BehrensG/ETH1CLCR1/hardware/project/ETH1CLCR1/ETH1CLCR1.kicad_pcb

## KiCad design hardware/project/ETH1CLCR1/ETH1CLCR1.kicad_pcb (2020-01-29)

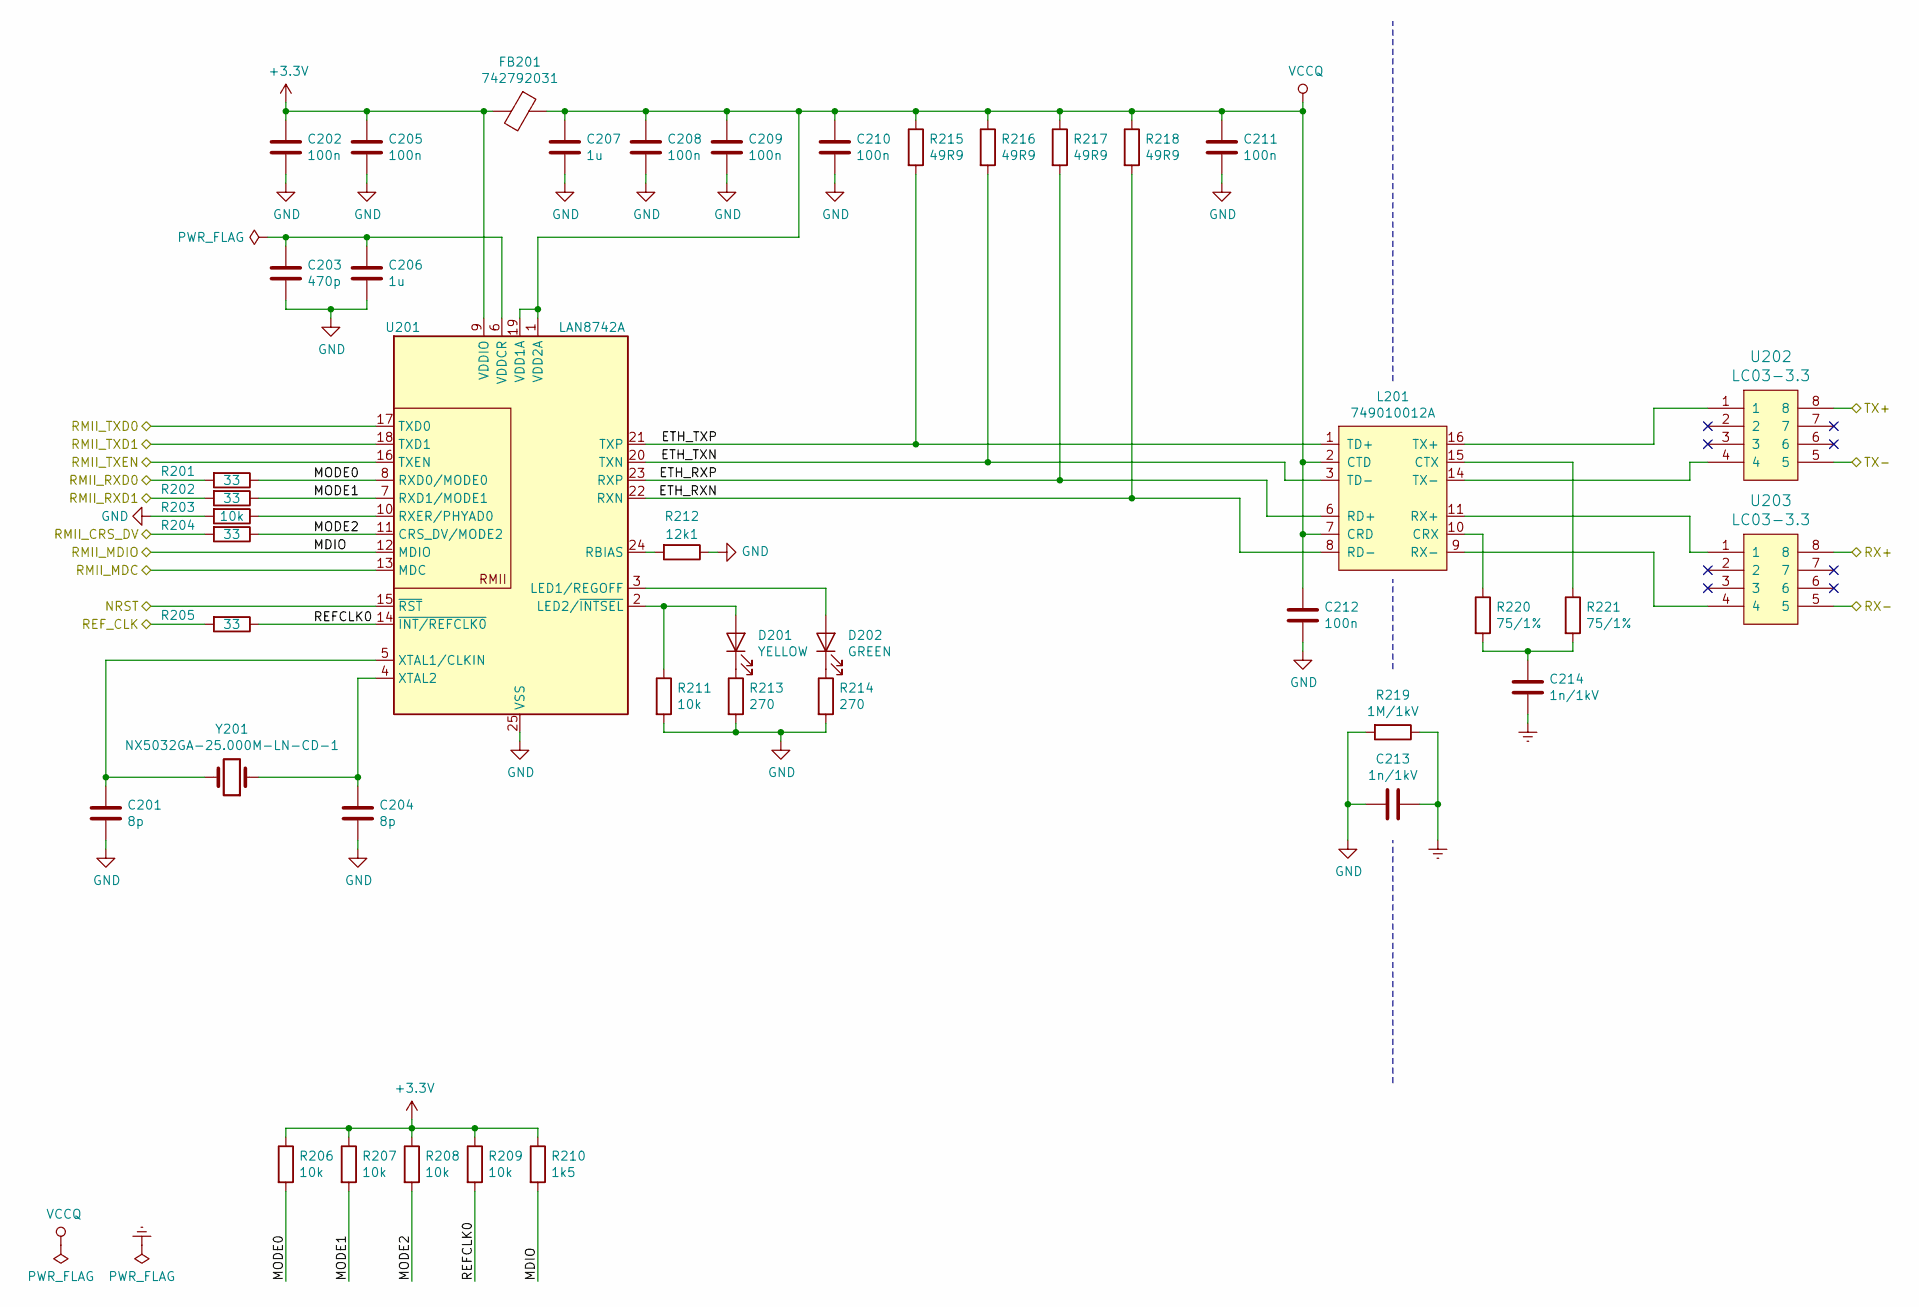
[picture p1: schematic Ethernet.sch]

Parts:
C201, C204: 8p; C_0603_1608Metric_Pad1.05x0.95mm_HandSolder
C202, C205, C208, C209, C210, C211, C212: 100n; C_0603_1608Metric_Pad1.05x0.95mm_HandSolder
C203: 470p; C_0603_1608Metric_Pad1.05x0.95mm_HandSolder
C206, C207: 1u; C_0603_1608Metric_Pad1.05x0.95mm_HandSolder
C213, C214: 1n/1kV; C_1206_3216Metric_Pad1.42x1.75mm_HandSolder
D201: YELLOW; LED_0603_1608Metric_Pad1.05x0.95mm_HandSolder
D202: GREEN; LED_0603_1608Metric_Pad1.05x0.95mm_HandSolder
FB201: 742792031; L_0805_2012Metric_Pad1.15x1.40mm_HandSolder
L201: 749010012A
R201, R202, R204, R205: 33; R_0603_1608Metric_Pad1.05x0.95mm_HandSolder
R203, R206, R207, R208, R209, R211: 10k; R_0603_1608Metric_Pad1.05x0.95mm_HandSolder
R210: 1k5; R_0603_1608Metric_Pad1.05x0.95mm_HandSolder
R212: 12k1; R_0603_1608Metric_Pad1.05x0.95mm_HandSolder
R213, R214: 270; R_0603_1608Metric_Pad1.05x0.95mm_HandSolder
R215, R216, R217, R218: 49R9; R_0603_1608Metric_Pad1.05x0.95mm_HandSolder
R219: 1M/1kV; R_1206_3216Metric_Pad1.42x1.75mm_HandSolder
R220, R221: 75/1%; R_0603_1608Metric_Pad1.05x0.95mm_HandSolder
U201: LAN8742A; QFN-24-1EP_4x4mm_P0.5mm_EP2.6x2.6mm_ThermalVias
U202, U203: LC03-3.3; SO8E
Y201: NX5032GA-25.000M-LN-CD-1; NX5032GA

Connections:
+3V3: C202.1, C205.1, FB201.2, R206.1, R207.1, R208.1, R209.1, R210.1, U201.9 (VDDIO); also elsewhere on the board
/Connector/RX+: U203.8; also elsewhere on the board
/Connector/RX-: U203.5; also elsewhere on the board
/Connector/TX+: U202.8; also elsewhere on the board
/Connector/TX-: U202.5; also elsewhere on the board
/Ethernet/ETH_RXN: L201.8 (RD-), R218.2, U201.22 (RXN)
/Ethernet/ETH_RXP: L201.6 (RD+), R217.2, U201.23 (RXP)
/Ethernet/ETH_TXN: L201.3 (TD-), R216.2, U201.20 (TXN)
/Ethernet/ETH_TXP: L201.1 (TD+), R215.2, U201.21 (TXP)
/Ethernet/MODE0: R201.1, R206.2, U201.8 (RXD0/MODE0)
/Ethernet/MODE1: R202.1, R207.2, U201.7 (RXD1/MODE1)
/Ethernet/MODE2: R204.1, R208.2, U201.11 (CRS_DV/MODE2)
/Ethernet/NRST: U201.15 (~RST); also elsewhere on the board
/Ethernet/REFCLK0: R205.1, R209.2, U201.14 (~INT/REFCLK0)
/Ethernet/REF_CLK: R205.2; also elsewhere on the board
/Ethernet/RMII_CRS_DV: R204.2; also elsewhere on the board
/Ethernet/RMII_MDC: U201.13 (MDC); also elsewhere on the board
/Ethernet/RMII_MDIO: R210.2, U201.12 (MDIO); also elsewhere on the board
/Ethernet/RMII_RXD0: R201.2; also elsewhere on the board
/Ethernet/RMII_RXD1: R202.2; also elsewhere on the board
/Ethernet/RMII_TXD0: U201.17 (TXD0); also elsewhere on the board
/Ethernet/RMII_TXD1: U201.18 (TXD1); also elsewhere on the board
/Ethernet/RMII_TXEN: U201.16 (TXEN); also elsewhere on the board
AGNDF: C201.2, C202.2, C203.2, C204.2, C205.2, C206.2, C207.2, C208.2, C209.2, C210.2, C211.2, C212.2, C213.2, R203.2, R211.2, R212.1, R213.2, R214.2, R219.2, U201.25 (VSS); also elsewhere on the board
Earth: C213.1, C214.2, R219.1; also elsewhere on the board
unnamed: C201.1, U201.5 (XTAL1/CLKIN), Y201.2
unnamed: C203.1, C206.1, U201.6 (VDDCR)
unnamed: C204.1, U201.4 (XTAL2), Y201.1
unnamed: C214.1, R220.2, R221.2
unnamed: D201.1 (K), R213.1
unnamed: D201.2 (A), R211.1, U201.2 (LED2/~INTSEL)
unnamed: D202.1 (K), R214.1
unnamed: D202.2 (A), U201.3 (LED1/REGOFF)
unnamed: L201.9 (RX-), U203.4
unnamed: L201.10 (CRX), R220.1
unnamed: L201.11 (RX+), U203.1
unnamed: L201.14 (TX-), U202.4
unnamed: L201.15 (CTX), R221.1
unnamed: L201.16 (TX+), U202.1
unnamed: R203.1, U201.10 (RXER/PHYAD0)
unnamed: R212.2, U201.24 (RBIAS)
VCCQ: C207.1, C208.1, C209.1, C210.1, C211.1, C212.1, FB201.1, L201.2 (CTD), L201.7 (CRD), R215.1, R216.1, R217.1, R218.1, U201.1 (VDD2A), U201.19 (VDD1A)

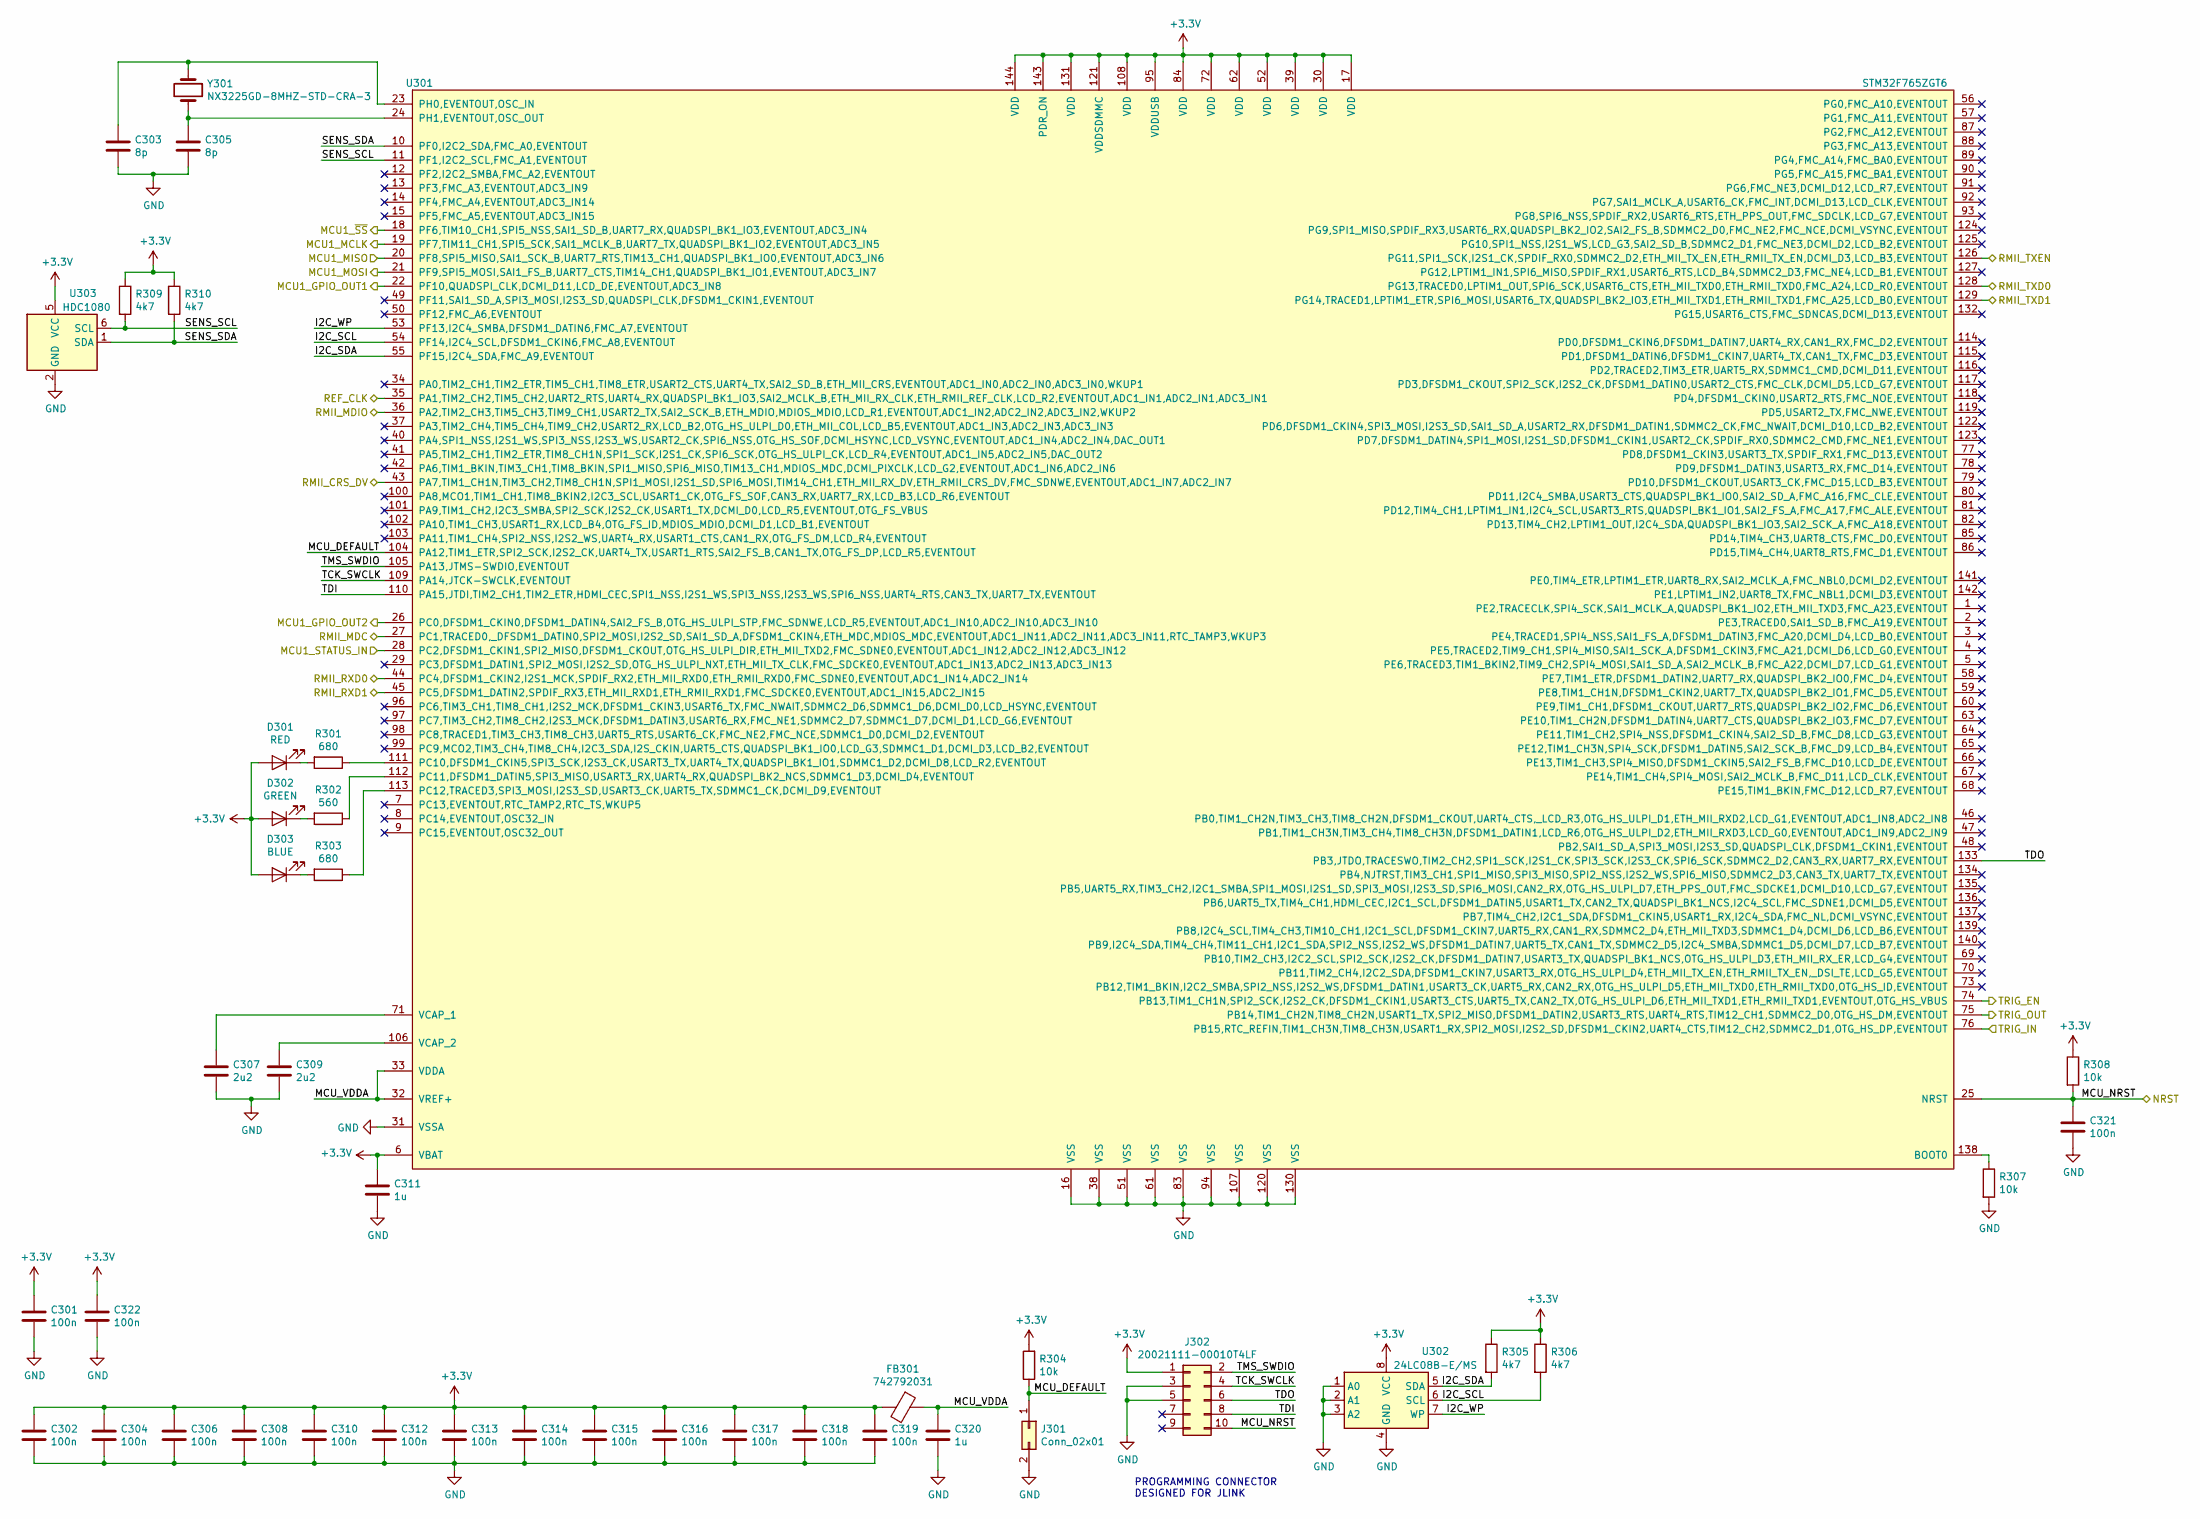
[picture p2: schematic MCU1.sch]

Parts:
C301, C302, C304, C306, C308, C310, C312, C313, C314, C315, C316, C317, C318, C319, C321, C322: 100n; C_0603_1608Metric_Pad1.05x0.95mm_HandSolder
C303, C305: 8p; C_0603_1608Metric_Pad1.05x0.95mm_HandSolder
C307, C309: 2u2; C_0805_2012Metric_Pad1.15x1.40mm_HandSolder
C311, C320: 1u; C_0603_1608Metric_Pad1.05x0.95mm_HandSolder
D301: RED; LED_0603_1608Metric_Pad1.05x0.95mm_HandSolder
D302: GREEN; LED_0603_1608Metric_Pad1.05x0.95mm_HandSolder
D303: BLUE; LED_0603_1608Metric_Pad1.05x0.95mm_HandSolder
FB301: 742792031; L_0805_2012Metric_Pad1.15x1.40mm_HandSolder
J301: Conn_02x01; PinHeader_1x02_P2.54mm_Vertical
J302: 20021111-00010T4LF; PinHeader_2x05_P1.27mm_Vertical
R301, R303: 680; R_0603_1608Metric_Pad1.05x0.95mm_HandSolder
R302: 560; R_0603_1608Metric_Pad1.05x0.95mm_HandSolder
R304, R307, R308: 10k; R_0603_1608Metric_Pad1.05x0.95mm_HandSolder
R305, R306, R309, R310: 4k7; R_0603_1608Metric_Pad1.05x0.95mm_HandSolder
U301: STM32F765ZGT6; TQFP-144_20x20mm_P0.5mm
U302: 24LC08B-E/MS; MSOP-8_3x3mm_P0.65mm
U303: HDC1080; Texas_PWSON-N6
Y301: NX3225GD-8MHZ-STD-CRA-3; NX3225GD

Connections:
+3V3: C301.1, C302.1, C304.1, C306.1, C308.1, C310.1, C311.1, C312.1, C313.1, C314.1, C315.1, C316.1, C317.1, C318.1, C319.1, C322.1, D301.2 (A), D302.2 (A), D303.2 (A), FB301.2, J302.1, R304.2, R305.1, R306.1, R308.1, R309.1, R310.1, U301.6 (VBAT), U301.17 (VDD), U301.30 (VDD), U301.39 (VDD), U301.52 (VDD), U301.62 (VDD), U301.72 (VDD), U301.84 (VDD), U301.95 (VDDUSB), U301.108 (VDD), U301.121 (VDDSDMMC), U301.131 (VDD), U301.143 (PDR_ON), U301.144 (VDD), U302.8 (VCC), U303.5 (VCC); also elsewhere on the board
/Ethernet/NRST: C321.1, J302.10, R308.2, U301.25 (NRST); also elsewhere on the board
/Ethernet/REF_CLK: U301.35 (PA1,TIM2_CH2,TIM5_CH2,UART2_RTS,UART4_R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); also elsewhere on the board
/Ethernet/RMII_CRS_DV: U301.43 (PA7,TIM1_CH1N,TIM3_CH2,TIM8_CH1N,SPI1_M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); also elsewhere on the board
/Ethernet/RMII_MDC: U301.27 (PC1,TRACED0,_DFSDM1_DATIN0,SPI2_MOSI,I2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); also elsewhere on the board
/Ethernet/RMII_MDIO: U301.36 (PA2,TIM2_CH3,TIM5_CH3,TIM9_CH1,USART2_T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); also elsewhere on the board
/Ethernet/RMII_RXD0: U301.44 (PC4,DFSDM1_CKIN2,I2S1_MCK,SPDIF_RX2,ETH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); also elsewhere on the board
/Ethernet/RMII_RXD1: U301.45 (PC5,DFSDM1_DATIN2,SPDIF_RX3,ETH_MII_RXD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); also elsewhere on the board
/Ethernet/RMII_TXD0: U301.128 (PG13,TRACED0,LPTIM1_OUT,SPI6_SCK,USART6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); also elsewhere on the board
/Ethernet/RMII_TXD1: U301.129 (PG14,TRACED1,LPTIM1_ETR,SPI6_MOSI,USART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); also elsewhere on the board
/Ethernet/RMII_TXEN: U301.126 (PG11,SPI1_SCK,I2S1_CK,SPDIF_RX0,SDMMC2_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); also elsewhere on the board
/MCU1/I2C_SCL: R306.2, U301.54 (PF14,I2C4_SCL,DFSDM1_CKIN6,FMC_A8,EVENT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), U302.6 (SCL)
/MCU1/I2C_SDA: R305.2, U301.55 (PF15,I2C4_SDA,FMC_A9,EVENTOUT), U302.5 (SDA)
/MCU1/I2C_WP: U301.53 (PF13,I2C4_SMBA,DFSDM1_DATIN6,FMC_A7,EVE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), U302.7 (WP)
/MCU1/MCU1_GPIO_OUT1: U301.22 (PF10,QUADSPI_CLK,DCMI_D11,LCD_DE,EVENTO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); also elsewhere on the board
/MCU1/MCU1_GPIO_OUT2: U301.26 (PC0,DFSDM1_CKIN0,DFSDM1_DATIN4,SAI2_FS_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); also elsewhere on the board
/MCU1/MCU1_MCLK: U301.19 (PF7,TIM11_CH1,SPI5_SCK,SAI1_MCLK_B,UART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); also elsewhere on the board
/MCU1/MCU1_MISO: U301.20 (PF8,SPI5_MISO,SAI1_SCK_B,UART7_RTS,TIM1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); also elsewhere on the board
/MCU1/MCU1_MOSI: U301.21 (PF9,SPI5_MOSI,SAI1_FS_B,UART7_CTS,TIM14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); also elsewhere on the board
/MCU1/MCU1_STATUS_IN: U301.28 (PC2,DFSDM1_CKIN1,SPI2_MISO,DFSDM1_CKOUT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); also elsewhere on the board
/MCU1/MCU1_~SS: U301.18 (PF6,TIM10_CH1,SPI5_NSS,SAI1_SD_B,UART7_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); also elsewhere on the board
/MCU1/MCU_DEFAULT: J301.1, R304.1, U301.104 (PA12,TIM1_ETR,SPI2_SCK,I2S2_CK,UART4_TX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)
/MCU1/MCU_VDDA: C320.1, FB301.1, U301.32 (VREF+), U301.33 (VDDA)
/MCU1/SENS_SCL: R309.2, U301.11 (PF1,I2C2_SCL,FMC_A1,EVENTOUT), U303.6 (SCL)
/MCU1/SENS_SDA: R310.2, U301.10 (PF0,I2C2_SDA,FMC_A0,EVENTOUT), U303.1 (SDA)
/MCU1/TCK_SWCLK: J302.4, U301.109 (PA14,JTCK-SWCLK,EVENTOUT)
/MCU1/TDI: J302.8, U301.110 (PA15,JTDI,TIM2_CH1,TIM2_ETR,HDMI_CEC,SP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)
/MCU1/TDO: J302.6, U301.133 (PB3,JTDO,TRACESWO,TIM2_CH2,SPI1_SCK,I2S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)
/MCU1/TMS_SWDIO: J302.2, U301.105 (PA13,JTMS-SWDIO,EVENTOUT)
/MCU1/TRIG_EN: U301.74 (PB13,TIM1_CH1N,SPI2_SCK,I2S2_CK,DFSDM1_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); also elsewhere on the board
/MCU1/TRIG_IN: U301.76 (PB15,RTC_REFIN,TIM1_CH3N,TIM8_CH3N,USAR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); also elsewhere on the board
/MCU1/TRIG_OUT: U301.75 (PB14,TIM1_CH2N,TIM8_CH2N,USART1_TX,SPI2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); also elsewhere on the board
AGNDF: C301.2, C302.2, C303.2, C304.2, C305.2, C306.2, C307.2, C308.2, C309.2, C310.2, C311.2, C312.2, C313.2, C314.2, C315.2, C316.2, C317.2, C318.2, C319.2, C320.2, C321.2, C322.2, J301.2, J302.3, J302.5, R307.2, U301.16 (VSS), U301.31 (VSSA), U301.38 (VSS), U301.51 (VSS), U301.61 (VSS), U301.83 (VSS), U301.94 (VSS), U301.107 (VSS), U301.120 (VSS), U301.130 (VSS), U302.1 (A0), U302.2 (A1), U302.3 (A2), U302.4 (GND), U303.2 (GND); also elsewhere on the board
unnamed: C303.1, U301.23 (PH0,EVENTOUT,OSC_IN), Y301.1
unnamed: C305.1, U301.24 (PH1,EVENTOUT,OSC_OUT), Y301.2
unnamed: C307.1, U301.71 (VCAP_1)
unnamed: C309.1, U301.106 (VCAP_2)
unnamed: D301.1 (K), R301.2
unnamed: D302.1 (K), R302.2
unnamed: D303.1 (K), R303.2
unnamed: R301.1, U301.111 (PC10,DFSDM1_CKIN5,SPI3_SCK,I2S3_CK,USAR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)
unnamed: R302.1, U301.112 (PC11,DFSDM1_DATIN5,SPI3_MISO,USART3_RX,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)
unnamed: R303.1, U301.113 (PC12,TRACED3,SPI3_MOSI,I2S3_SD,USART3_C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)
unnamed: R307.1, U301.138 (BOOT0)

Notes on the sheet:
PROGRAMMING CONNECTOR DESIGNED FOR JLINK

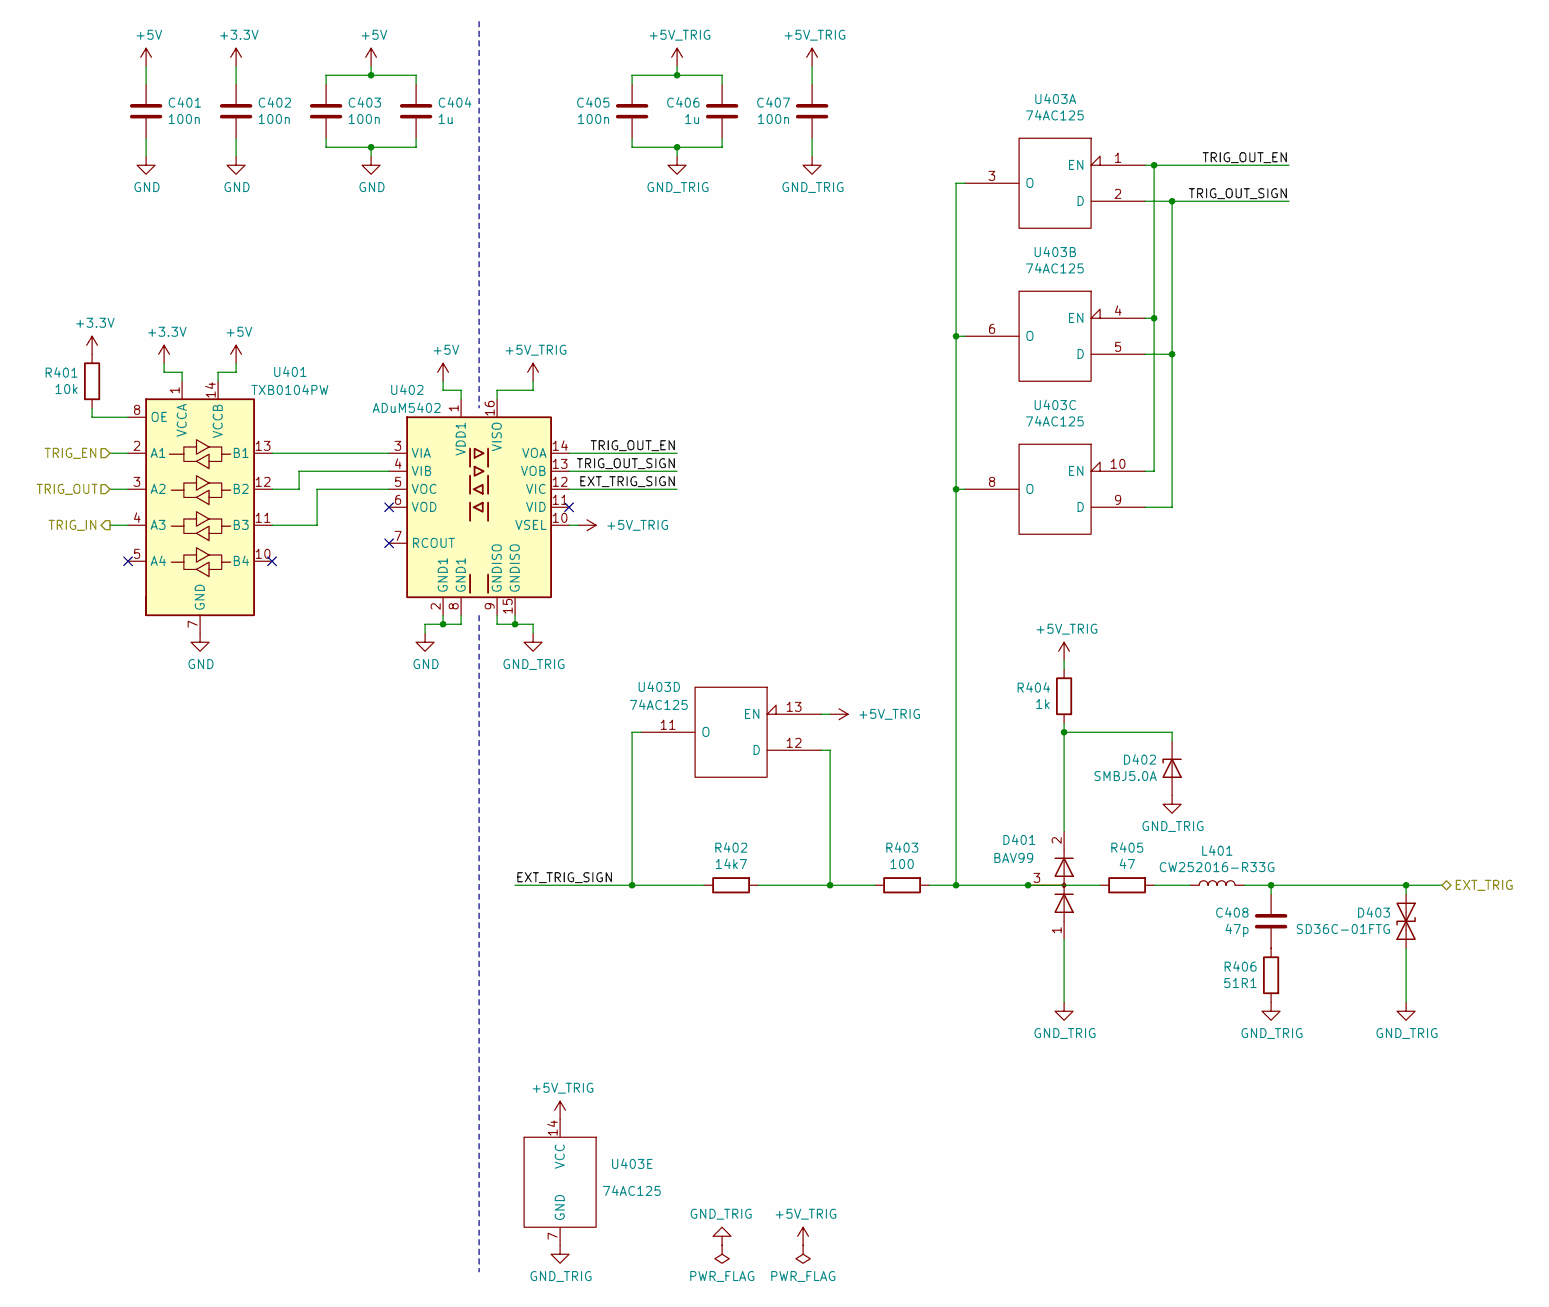
[picture p3: schematic Trigger.sch]

Parts:
C401, C402, C403, C405, C407: 100n; C_0603_1608Metric_Pad1.05x0.95mm_HandSolder
C404, C406: 1u; C_0603_1608Metric_Pad1.05x0.95mm_HandSolder
C408: 47p; C_0603_1608Metric_Pad1.05x0.95mm_HandSolder
D401: BAV99; SOT-23
D402: SMBJ5.0A; D_SMB
D403: SD36C-01FTG; D_SOD-323_HandSoldering
L401: CW252016-R33G; CW252016
R401: 10k; R_0603_1608Metric_Pad1.05x0.95mm_HandSolder
R402: 14k7; R_0603_1608Metric_Pad1.05x0.95mm_HandSolder
R403: 100; R_0603_1608Metric_Pad1.05x0.95mm_HandSolder
R404: 1k; R_0603_1608Metric_Pad1.05x0.95mm_HandSolder
R405: 47; R_0603_1608Metric_Pad1.05x0.95mm_HandSolder
R406: 51R1; R_0603_1608Metric_Pad1.05x0.95mm_HandSolder
U401: TXB0104PW; TSSOP-14_4.4x5mm_P0.65mm
U402: ADuM5402; SOIC-16W_7.5x10.3mm_P1.27mm
U403: 74AC125; TSSOP-14_4.4x5mm_P0.65mm

Connections:
+3V3: C402.1, R401.1, U401.1 (VCCA); also elsewhere on the board
+5V: C401.1, C403.1, C404.1, U401.14 (VCCB), U402.1 (VDD1); also elsewhere on the board
+5V_TRIG: C405.1, C406.1, C407.1, R404.1, U402.10 (VSEL), U402.16 (VISO), U403.13 (EN), U403.14 (VCC)
/Connector/EXT_TRIG: C408.1, D403.1 (A1), L401.1; also elsewhere on the board
/MCU1/TRIG_EN: U401.2 (A1); also elsewhere on the board
/MCU1/TRIG_IN: U401.4 (A3); also elsewhere on the board
/MCU1/TRIG_OUT: U401.3 (A2); also elsewhere on the board
/Trigger/EXT_TRIG_SIGN: R402.1, U402.12 (VIC), U403.11 (O)
/Trigger/TRIG_OUT_EN: U402.14 (VOA), U403.1 (EN), U403.4 (EN), U403.10 (EN)
/Trigger/TRIG_OUT_SIGN: U402.13 (VOB), U403.2 (D), U403.5 (D), U403.9 (D)
AGNDF: C401.2, C402.2, C403.2, C404.2, U401.7 (GND), U402.2 (GND1), U402.8 (GND1); also elsewhere on the board
GND_TRIG: C405.2, C406.2, C407.2, D401.1 (K), D402.2 (A), D403.2 (A2), R406.2, U402.9 (GNDISO), U402.15 (GNDISO), U403.7 (GND); also elsewhere on the board
unnamed: C408.2, R406.1
unnamed: D401.2 (A), D402.1 (K), R404.2
unnamed: D401.3 (K), R403.2, R405.1, U403.3 (O), U403.6 (O), U403.8 (O)
unnamed: L401.2, R405.2
unnamed: R401.2, U401.8 (OE)
unnamed: R402.2, R403.1, U403.12 (D)
unnamed: U401.11 (B3), U402.5 (VOC)
unnamed: U401.12 (B2), U402.4 (VIB)
unnamed: U401.13 (B1), U402.3 (VIA)

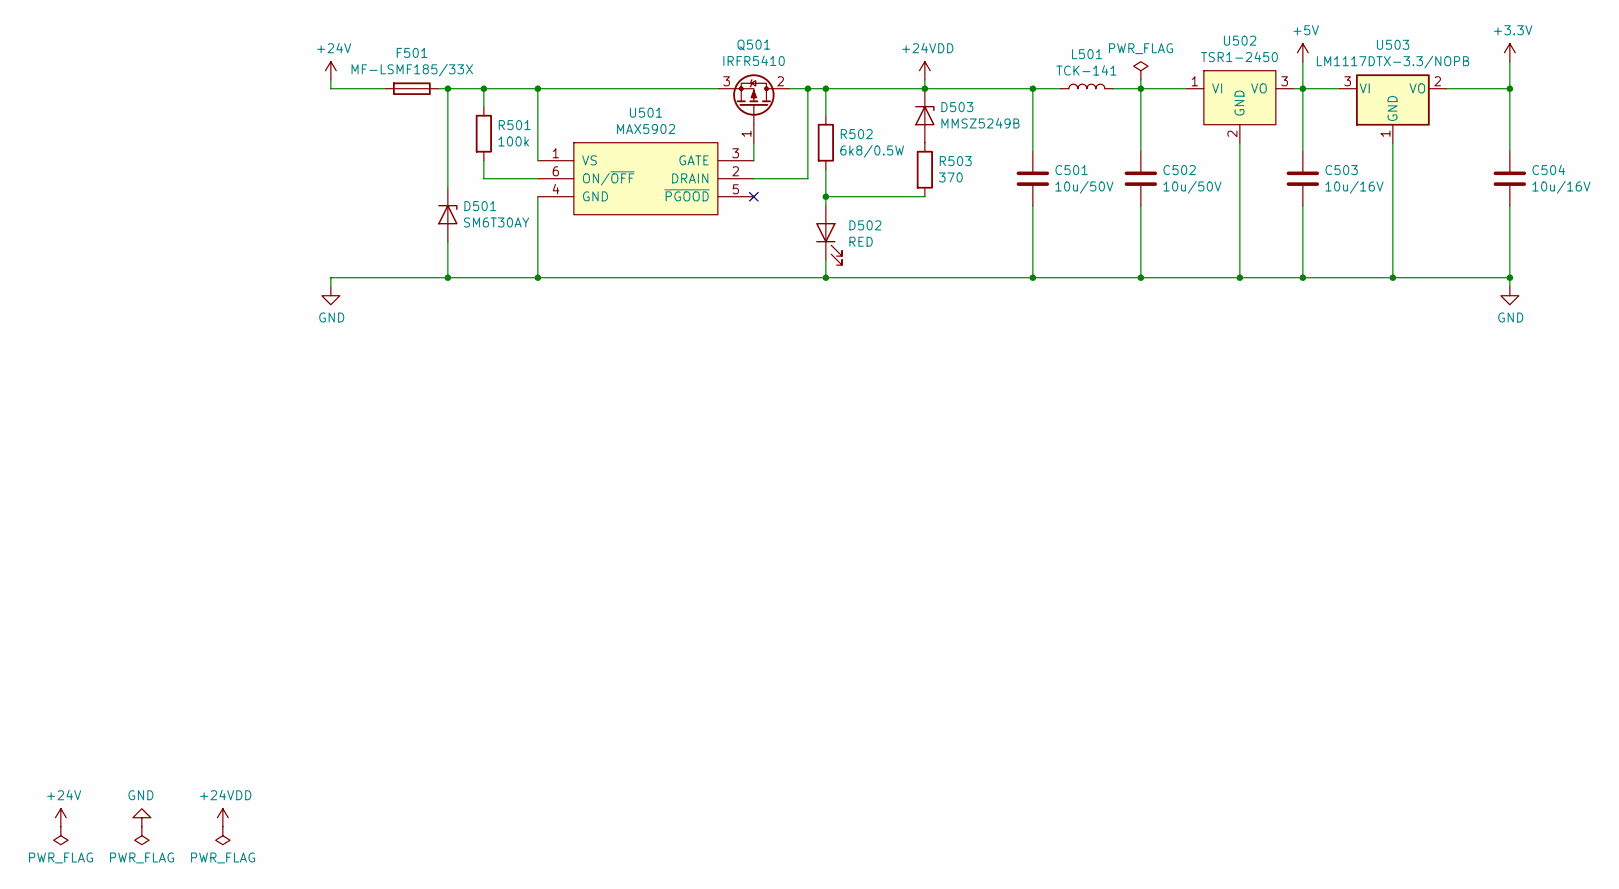
[picture p4: schematic Power_One.sch, Power supply one]

Parts:
C501, C502: 10u/50V; C_1206_3216Metric_Pad1.42x1.75mm_HandSolder
C503, C504: 10u/16V; C_1206_3216Metric_Pad1.42x1.75mm_HandSolder
D501: SM6T30AY; DO_214AA_REV
D502: RED; LED_0603_1608Metric_Pad1.05x0.95mm_HandSolder
D503: MMSZ5249B; D_SOD-123
F501: MF-LSMF185/33X; Fuse_SMD2920
L501: TCK-141
Q501: IRFR5410; TO-252-2_Rectifier
R501: 100k; R_0603_1608Metric_Pad1.05x0.95mm_HandSolder
R502: 6k8/0.5W; R_0805_2012Metric_Pad1.15x1.40mm_HandSolder
R503: 370; R_0603_1608Metric_Pad1.05x0.95mm_HandSolder
U501: MAX5902; SOT-23-6_Handsoldering
U502: TSR1-2450; TSR1
U503: LM1117DTX-3.3/NOPB; TO-252-2

Connections:
+3V3: C504.1, U503.2 (VO); also elsewhere on the board
+5V: C503.1, U502.3 (VO), U503.3 (VI); also elsewhere on the board
+24V: F501.2; also elsewhere on the board
+24VDD: C501.1, D503.1 (K), L501.1, Q501.2 (D), R502.1, U501.2 (DRAIN); also elsewhere on the board
AGNDF: C501.2, C502.2, C503.2, C504.2, D501.2 (A), D502.1 (K), U501.4 (GND), U502.2 (GND), U503.1 (GND); also elsewhere on the board
unnamed: C502.1, L501.2, U502.1 (VI)
unnamed: D501.1 (K), F501.1, Q501.3 (S), R501.1, U501.1 (VS)
unnamed: D502.2 (A), R502.2, R503.2
unnamed: D503.2 (A), R503.1
unnamed: Q501.1 (G), U501.3 (GATE)
unnamed: R501.2, U501.6 (ON/~OFF)

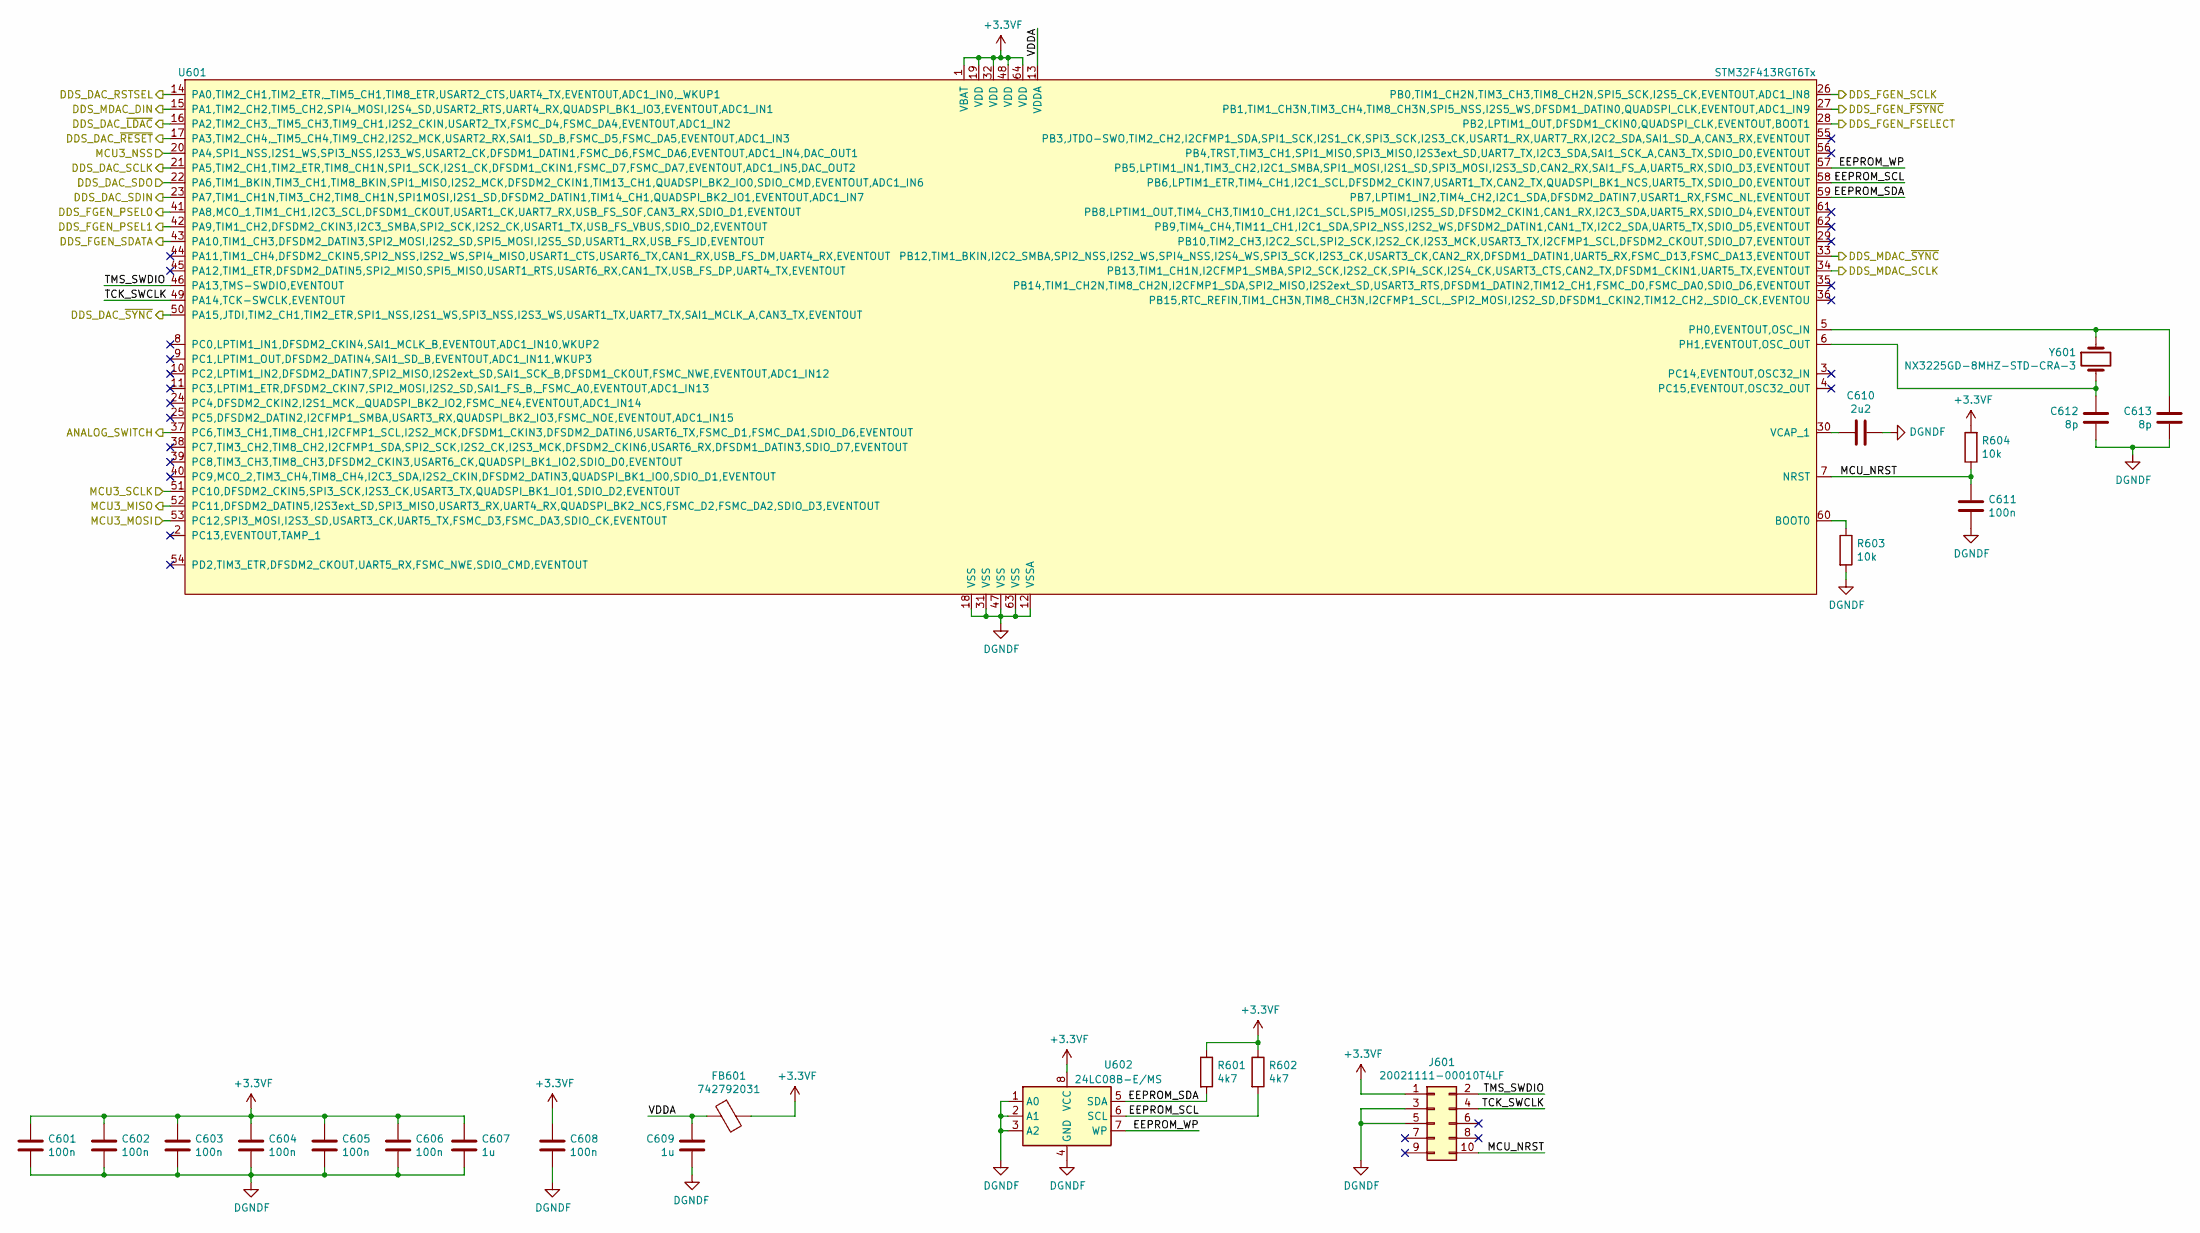
[picture p5: schematic MCU3.sch]

Parts:
C601, C602, C603, C604, C605, C606, C608, C611: 100n; C_0603_1608Metric_Pad1.05x0.95mm_HandSolder
C607, C609: 1u; C_0603_1608Metric_Pad1.05x0.95mm_HandSolder
C610: 2u2; C_0805_2012Metric_Pad1.15x1.40mm_HandSolder
C612, C613: 8p; C_0603_1608Metric_Pad1.05x0.95mm_HandSolder
FB601: 742792031; L_0805_2012Metric_Pad1.15x1.40mm_HandSolder
J601: 20021111-00010T4LF; PinHeader_2x05_P1.27mm_Vertical
R601, R602: 4k7; R_0603_1608Metric_Pad1.05x0.95mm_HandSolder
R603, R604: 10k; R_0603_1608Metric_Pad1.05x0.95mm_HandSolder
U601: STM32F413RGT6Tx; LQFP-64_10x10mm_P0.5mm
U602: 24LC08B-E/MS; MSOP-8_3x3mm_P0.65mm
Y601: NX3225GD-8MHZ-STD-CRA-3; NX3225GD

Connections:
+3.3VF: C601.1, C602.1, C603.1, C604.1, C605.1, C606.1, C607.1, C608.1, FB601.2, J601.1, R601.1, R602.1, R604.2, U601.1 (VBAT), U601.19 (VDD), U601.32 (VDD), U601.48 (VDD), U601.64 (VDD), U602.8 (VCC); also elsewhere on the board
/FGEN/ANALOG_SWITCH: U601.37 (PC6,TIM3_CH1,TIM8_CH1,I2CFMP1_SCL,I2S2_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); also elsewhere on the board
/FGEN/DDS_DAC_RSTSEL: U601.14 (PA0,TIM2_CH1,TIM2_ETR,_TIM5_CH1,TIM8_ET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); also elsewhere on the board
/FGEN/DDS_DAC_SCLK: U601.21 (PA5,TIM2_CH1,TIM2_ETR,TIM8_CH1N,SPI1_SC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); also elsewhere on the board
/FGEN/DDS_DAC_SDIN: U601.23 (PA7,TIM1_CH1N,TIM3_CH2,TIM8_CH1N,SPI1MO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); also elsewhere on the board
/FGEN/DDS_DAC_SDO: U601.22 (PA6,TIM1_BKIN,TIM3_CH1,TIM8_BKIN,SPI1_M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); also elsewhere on the board
/FGEN/DDS_DAC_~LDAC: U601.16 (PA2,TIM2_CH3,_TIM5_CH3,TIM9_CH1,I2S2_CK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); also elsewhere on the board
/FGEN/DDS_DAC_~RESET: U601.17 (PA3,TIM2_CH4,_TIM5_CH4,TIM9_CH2,I2S2_MC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); also elsewhere on the board
/FGEN/DDS_DAC_~SYNC: U601.50 (PA15,JTDI,TIM2_CH1,TIM2_ETR,SPI1_NSS,I2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); also elsewhere on the board
/FGEN/DDS_FGEN_FSELECT: U601.28 (PB2,LPTIM1_OUT,DFSDM1_CKIN0,QUADSPI_CLK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); also elsewhere on the board
/FGEN/DDS_FGEN_PSEL0: U601.41 (PA8,MCO_1,TIM1_CH1,I2C3_SCL,DFSDM1_CKOU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); also elsewhere on the board
/FGEN/DDS_FGEN_PSEL1: U601.42 (PA9,TIM1_CH2,DFSDM2_CKIN3,I2C3_SMBA,SPI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); also elsewhere on the board
/FGEN/DDS_FGEN_SCLK: U601.26 (PB0,TIM1_CH2N,TIM3_CH3,TIM8_CH2N,SPI5_S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); also elsewhere on the board
/FGEN/DDS_FGEN_SDATA: U601.43 (PA10,TIM1_CH3,DFSDM2_DATIN3,SPI2_MOSI,I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); also elsewhere on the board
/FGEN/DDS_FGEN_~FSYNC: U601.27 (PB1,TIM1_CH3N,TIM3_CH4,TIM8_CH3N,SPI5_N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); also elsewhere on the board
/FGEN/DDS_MDAC_DIN: U601.15 (PA1,TIM2_CH2,TIM5_CH2,SPI4_MOSI,I2S4_SD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); also elsewhere on the board
/FGEN/DDS_MDAC_SCLK: U601.34 (PB13,TIM1_CH1N,I2CFMP1_SMBA,SPI2_SCK,I2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); also elsewhere on the board
/FGEN/DDS_MDAC_~SYNC: U601.33 (PB12,TIM1_BKIN,I2C2_SMBA,SPI2_NSS,I2S2_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); also elsewhere on the board
/MCU2/MCU3_MISO: U601.52 (PC11,DFSDM2_DATIN5,I2S3ext_SD,SPI3_MISO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); also elsewhere on the board
/MCU2/MCU3_MOSI: U601.53 (PC12,SPI3_MOSI,I2S3_SD,USART3_CK,UART5_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); also elsewhere on the board
/MCU2/MCU3_NSS: U601.20 (PA4,SPI1_NSS,I2S1_WS,SPI3_NSS,I2S3_WS,U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); also elsewhere on the board
/MCU2/MCU3_SCLK: U601.51 (PC10,DFSDM2_CKIN5,SPI3_SCK,I2S3_CK,USAR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); also elsewhere on the board
/MCU3/EEPROM_SCL: R602.2, U601.58 (PB6,LPTIM1_ETR,TIM4_CH1,I2C1_SCL,DFSDM2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), U602.6 (SCL)
/MCU3/EEPROM_SDA: R601.2, U601.59 (PB7,LPTIM1_IN2,TIM4_CH2,I2C1_SDA,DFSDM2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), U602.5 (SDA)
/MCU3/EEPROM_WP: U601.57 (PB5,LPTIM1_IN1,TIM3_CH2,I2C1_SMBA,SPI1_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), U602.7 (WP)
/MCU3/MCU_NRST: C611.1, J601.10, R604.1, U601.7 (NRST)
/MCU3/TCK_SWCLK: J601.4, U601.49 (PA14,TCK-SWCLK,EVENTOUT)
/MCU3/TMS_SWDIO: J601.2, U601.46 (PA13,TMS-SWDIO,EVENTOUT)
/MCU3/VDDA: C609.1, FB601.1, U601.13 (VDDA)
AGNDF: C601.2, C602.2, C603.2, C604.2, C605.2, C606.2, C607.2, C608.2, C609.2, C610.1, C611.2, C612.2, C613.2, J601.3, J601.5, R603.2, U601.12 (VSSA), U601.18 (VSS), U601.31 (VSS), U601.47 (VSS), U601.63 (VSS), U602.1 (A0), U602.2 (A1), U602.3 (A2), U602.4 (GND); also elsewhere on the board
unnamed: C610.2, U601.30 (VCAP_1)
unnamed: C612.1, U601.6 (PH1,EVENTOUT,OSC_OUT), Y601.2
unnamed: C613.1, U601.5 (PH0,EVENTOUT,OSC_IN), Y601.1
unnamed: R603.1, U601.60 (BOOT0)
