BehrensG/ETH1CLCR1/hardware/project/ETH1CLCR1/ETH1CLCR1.kicad_pcb

## KiCad design hardware/project/ETH1CLCR1/ETH1CLCR1.kicad_pcb (continued)

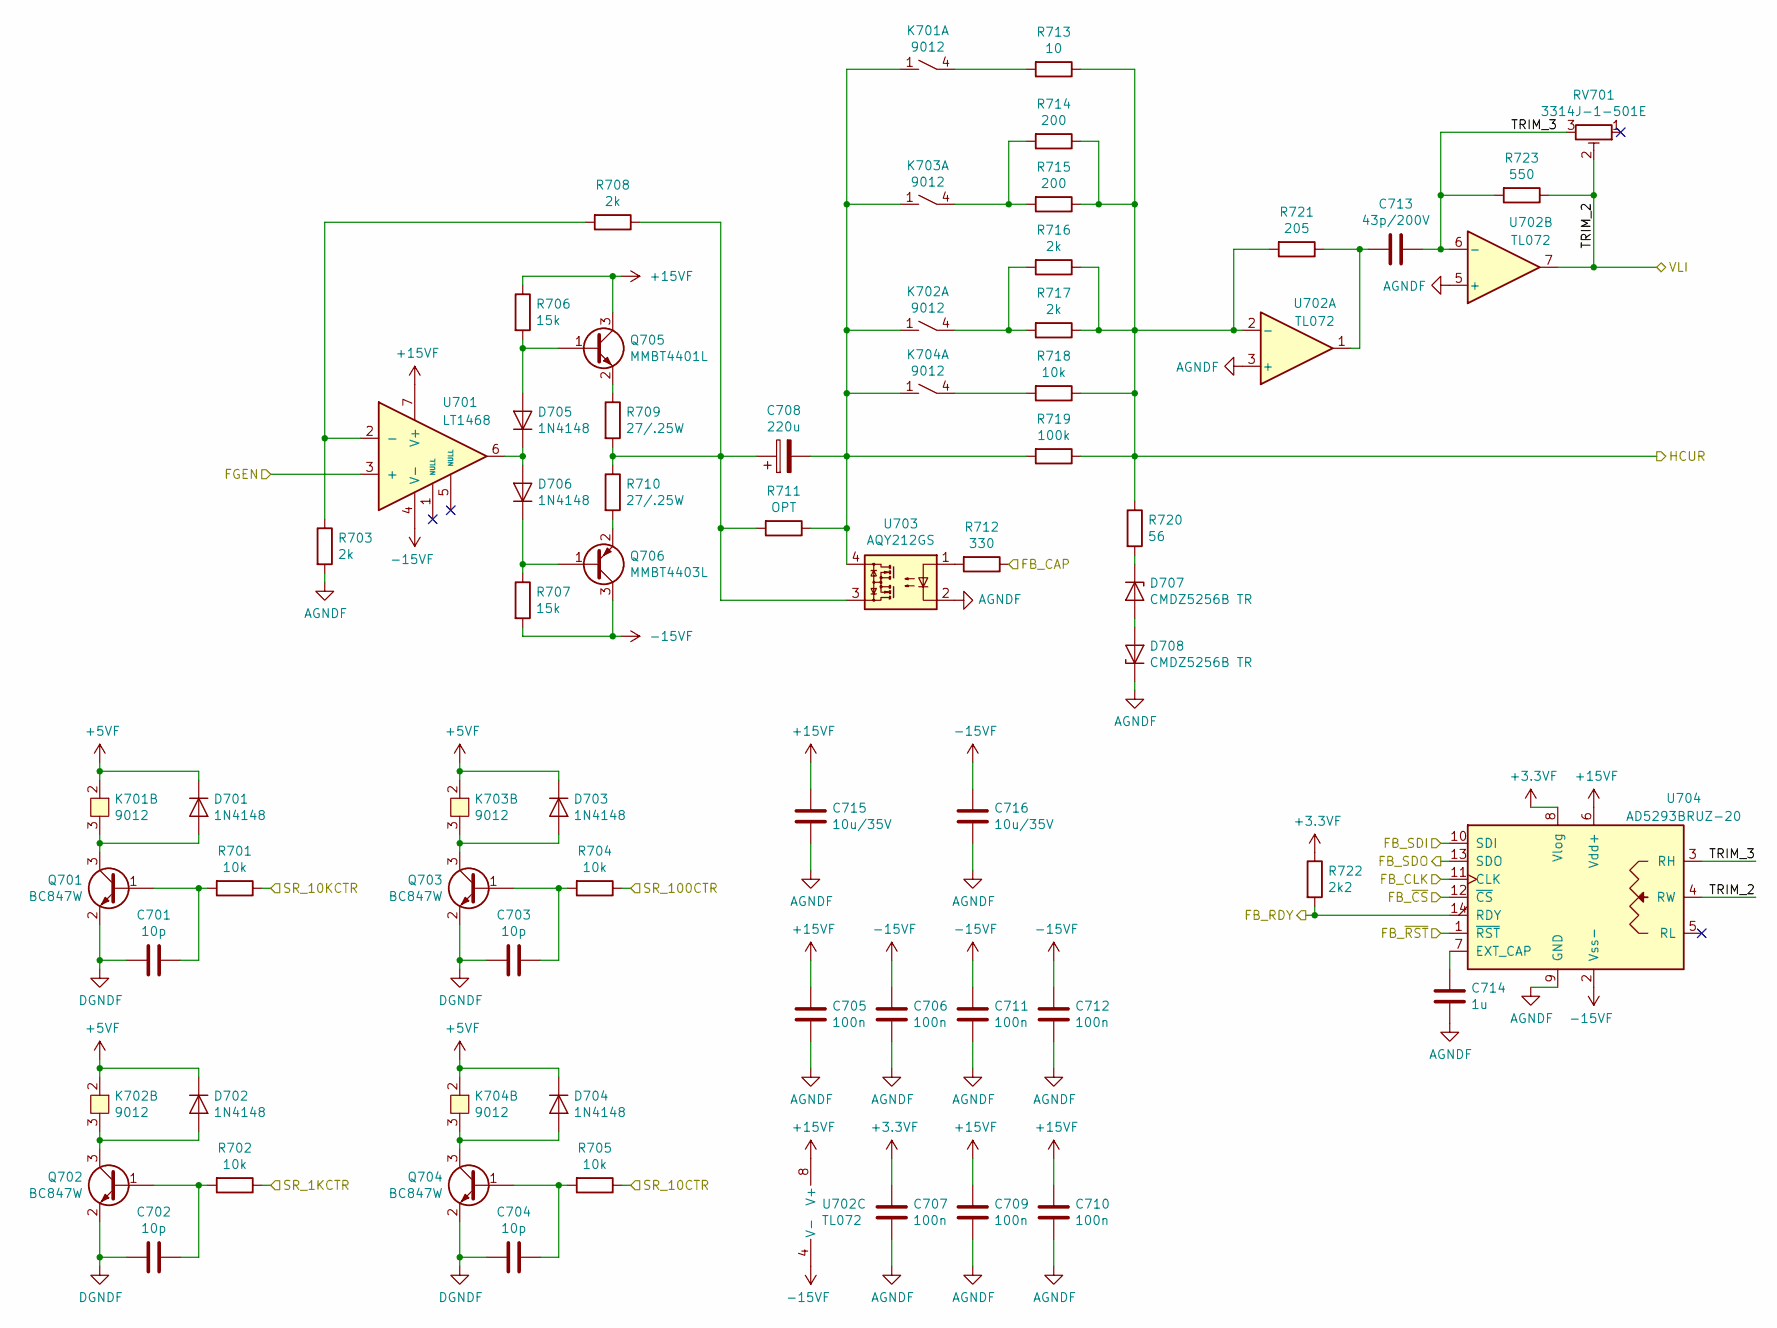
[picture p6: schematic FGEN_Buffer.sch, Function generator power ampl. and source resistor]

Parts:
C701, C702, C703, C704: 10p; C_0603_1608Metric_Pad1.05x0.95mm_HandSolder
C705, C706, C707, C709, C710, C711, C712: 100n; C_0603_1608Metric_Pad1.05x0.95mm_HandSolder
C708: 220u; CP_Elec_10x10
C713: 43p/200V; C_0603_1608Metric_Pad1.05x0.95mm_HandSolder
C714: 1u; C_0603_1608Metric_Pad1.05x0.95mm_HandSolder
C715, C716: 10u/35V; C_1206_3216Metric_Pad1.42x1.75mm_HandSolder
D701, D702, D703, D704, D705, D706: 1N4148; D_SOD-123
D707, D708: CMDZ5256B TR; D_SOD-323_HandSoldering
K701, K702, K703, K704: 9012
Q701, Q702, Q703, Q704: BC847W; SOT-323_SC-70
Q705: MMBT4401L; SOT-23
Q706: MMBT4403L; SOT-23
R701, R702, R704, R705, R718: 10k; R_0603_1608Metric_Pad1.05x0.95mm_HandSolder
R703, R708, R716, R717: 2k; R_0603_1608Metric_Pad1.05x0.95mm_HandSolder
R706, R707: 15k; R_0603_1608Metric_Pad1.05x0.95mm_HandSolder
R709, R710: 27/.25W; R_0805_2012Metric_Pad1.15x1.40mm_HandSolder
R711: OPT; R_0603_1608Metric_Pad1.05x0.95mm_HandSolder
R712: 330; R_0603_1608Metric_Pad1.05x0.95mm_HandSolder
R713: 10; R_0603_1608Metric_Pad1.05x0.95mm_HandSolder
R714, R715: 200; R_0603_1608Metric_Pad1.05x0.95mm_HandSolder
R719: 100k; R_0603_1608Metric_Pad1.05x0.95mm_HandSolder
R720: 56; R_0603_1608Metric_Pad1.05x0.95mm_HandSolder
R721: 205; R_0603_1608Metric_Pad1.05x0.95mm_HandSolder
R722: 2k2; R_0603_1608Metric_Pad1.05x0.95mm_HandSolder
R723: 550; R_0603_1608Metric_Pad1.05x0.95mm_HandSolder
RV701: 3314J-1-501E; Potentiometer_Bourns_3314J_Vertical
U701: LT1468; SSOP-8_3.9x5.05mm_P1.27mm
U702: TL072; SOIC-8_3.9x4.9mm_P1.27mm
U703: AQY212GS
U704: AD5293BRUZ-20; TSSOP-14_4.4x5mm_P0.65mm

Connections:
+3.3VF: C707.1, R722.1, U704.8 (Vlog); also elsewhere on the board
+5VF: D701.1 (K), D702.1 (K), D703.1 (K), D704.1 (K), K701.2, K702.2, K703.2, K704.2; also elsewhere on the board
+15VF: C705.1, C709.1, C710.1, C715.1, Q705.3 (C), R706.1, U701.7 (V+), U702.8 (V+), U704.6 (Vdd+); also elsewhere on the board
-15VF: C706.1, C711.1, C712.1, C716.1, Q706.3 (C), R707.2, U701.4 (V-), U702.4 (V-), U704.2 (Vss-); also elsewhere on the board
/Connector/HCUR: R713.1, R714.1, R715.1, R716.1, R717.1, R718.1, R719.1, R720.1, R721.2, U702.2 (-); also elsewhere on the board
/FGEN Buffer + Source resistor/FB_CAP: R712.1; also elsewhere on the board
/FGEN Buffer + Source resistor/FB_CLK: U704.11 (CLK); also elsewhere on the board
/FGEN Buffer + Source resistor/FB_RDY: R722.2, U704.14 (RDY); also elsewhere on the board
/FGEN Buffer + Source resistor/FB_SDI: U704.10 (SDI); also elsewhere on the board
/FGEN Buffer + Source resistor/FB_SDO: U704.13 (SDO); also elsewhere on the board
/FGEN Buffer + Source resistor/FB_~CS: U704.12 (~CS~); also elsewhere on the board
/FGEN Buffer + Source resistor/FB_~RST: U704.1 (~RST~); also elsewhere on the board
/FGEN Buffer + Source resistor/FGEN: U701.3 (+); also elsewhere on the board
/FGEN Buffer + Source resistor/SR_1KCTR: R702.1; also elsewhere on the board
/FGEN Buffer + Source resistor/SR_10CTR: R705.1; also elsewhere on the board
/FGEN Buffer + Source resistor/SR_10KCTR: R701.1; also elsewhere on the board
/FGEN Buffer + Source resistor/SR_100CTR: R704.1; also elsewhere on the board
/FGEN Buffer + Source resistor/TRIM_3: C713.1, R723.2, RV701.3, U702.6 (-), U704.3 (RH)
/FGEN Buffer + Source resistor/VLI: R723.1, RV701.2, U702.7, U704.4 (RW); also elsewhere on the board
AGNDF: C701.2, C702.2, C703.2, C704.2, C705.2, C706.2, C707.2, C709.2, C710.2, C711.2, C712.2, C714.2, C715.2, C716.2, D708.1 (K), Q701.2 (E), Q702.2 (E), Q703.2 (E), Q704.2 (E), R703.2, U702.3 (+), U702.5 (+), U703.2, U704.9 (GND); also elsewhere on the board
unnamed: C701.1, Q701.1 (B), R701.2
unnamed: C702.1, Q702.1 (B), R702.2
unnamed: C703.1, Q703.1 (B), R704.2
unnamed: C704.1, Q704.1 (B), R705.2
unnamed: C708.1, R708.1, R709.2, R710.1, R711.2, U703.3
unnamed: C708.2, K701.1, K702.1, K703.1, K704.1, R711.1, R719.2, U703.4
unnamed: C713.2, R721.1, U702.1
unnamed: C714.1, U704.7 (EXT_CAP)
unnamed: D701.2 (A), K701.3, Q701.3 (C)
unnamed: D702.2 (A), K702.3, Q702.3 (C)
unnamed: D703.2 (A), K703.3, Q703.3 (C)
unnamed: D704.2 (A), K704.3, Q704.3 (C)
unnamed: D705.1 (K), D706.2 (A), U701.6
unnamed: D705.2 (A), Q705.1 (B), R706.2
unnamed: D706.1 (K), Q706.1 (B), R707.1
unnamed: D707.1 (K), R720.2
unnamed: D707.2 (A), D708.2 (A)
unnamed: K701.4, R713.2
unnamed: K702.4, R716.2, R717.2
unnamed: K703.4, R714.2, R715.2
unnamed: K704.4, R718.2
unnamed: Q705.2 (E), R709.1
unnamed: Q706.2 (E), R710.2
unnamed: R703.1, R708.2, U701.2 (-)
unnamed: R712.2, U703.1

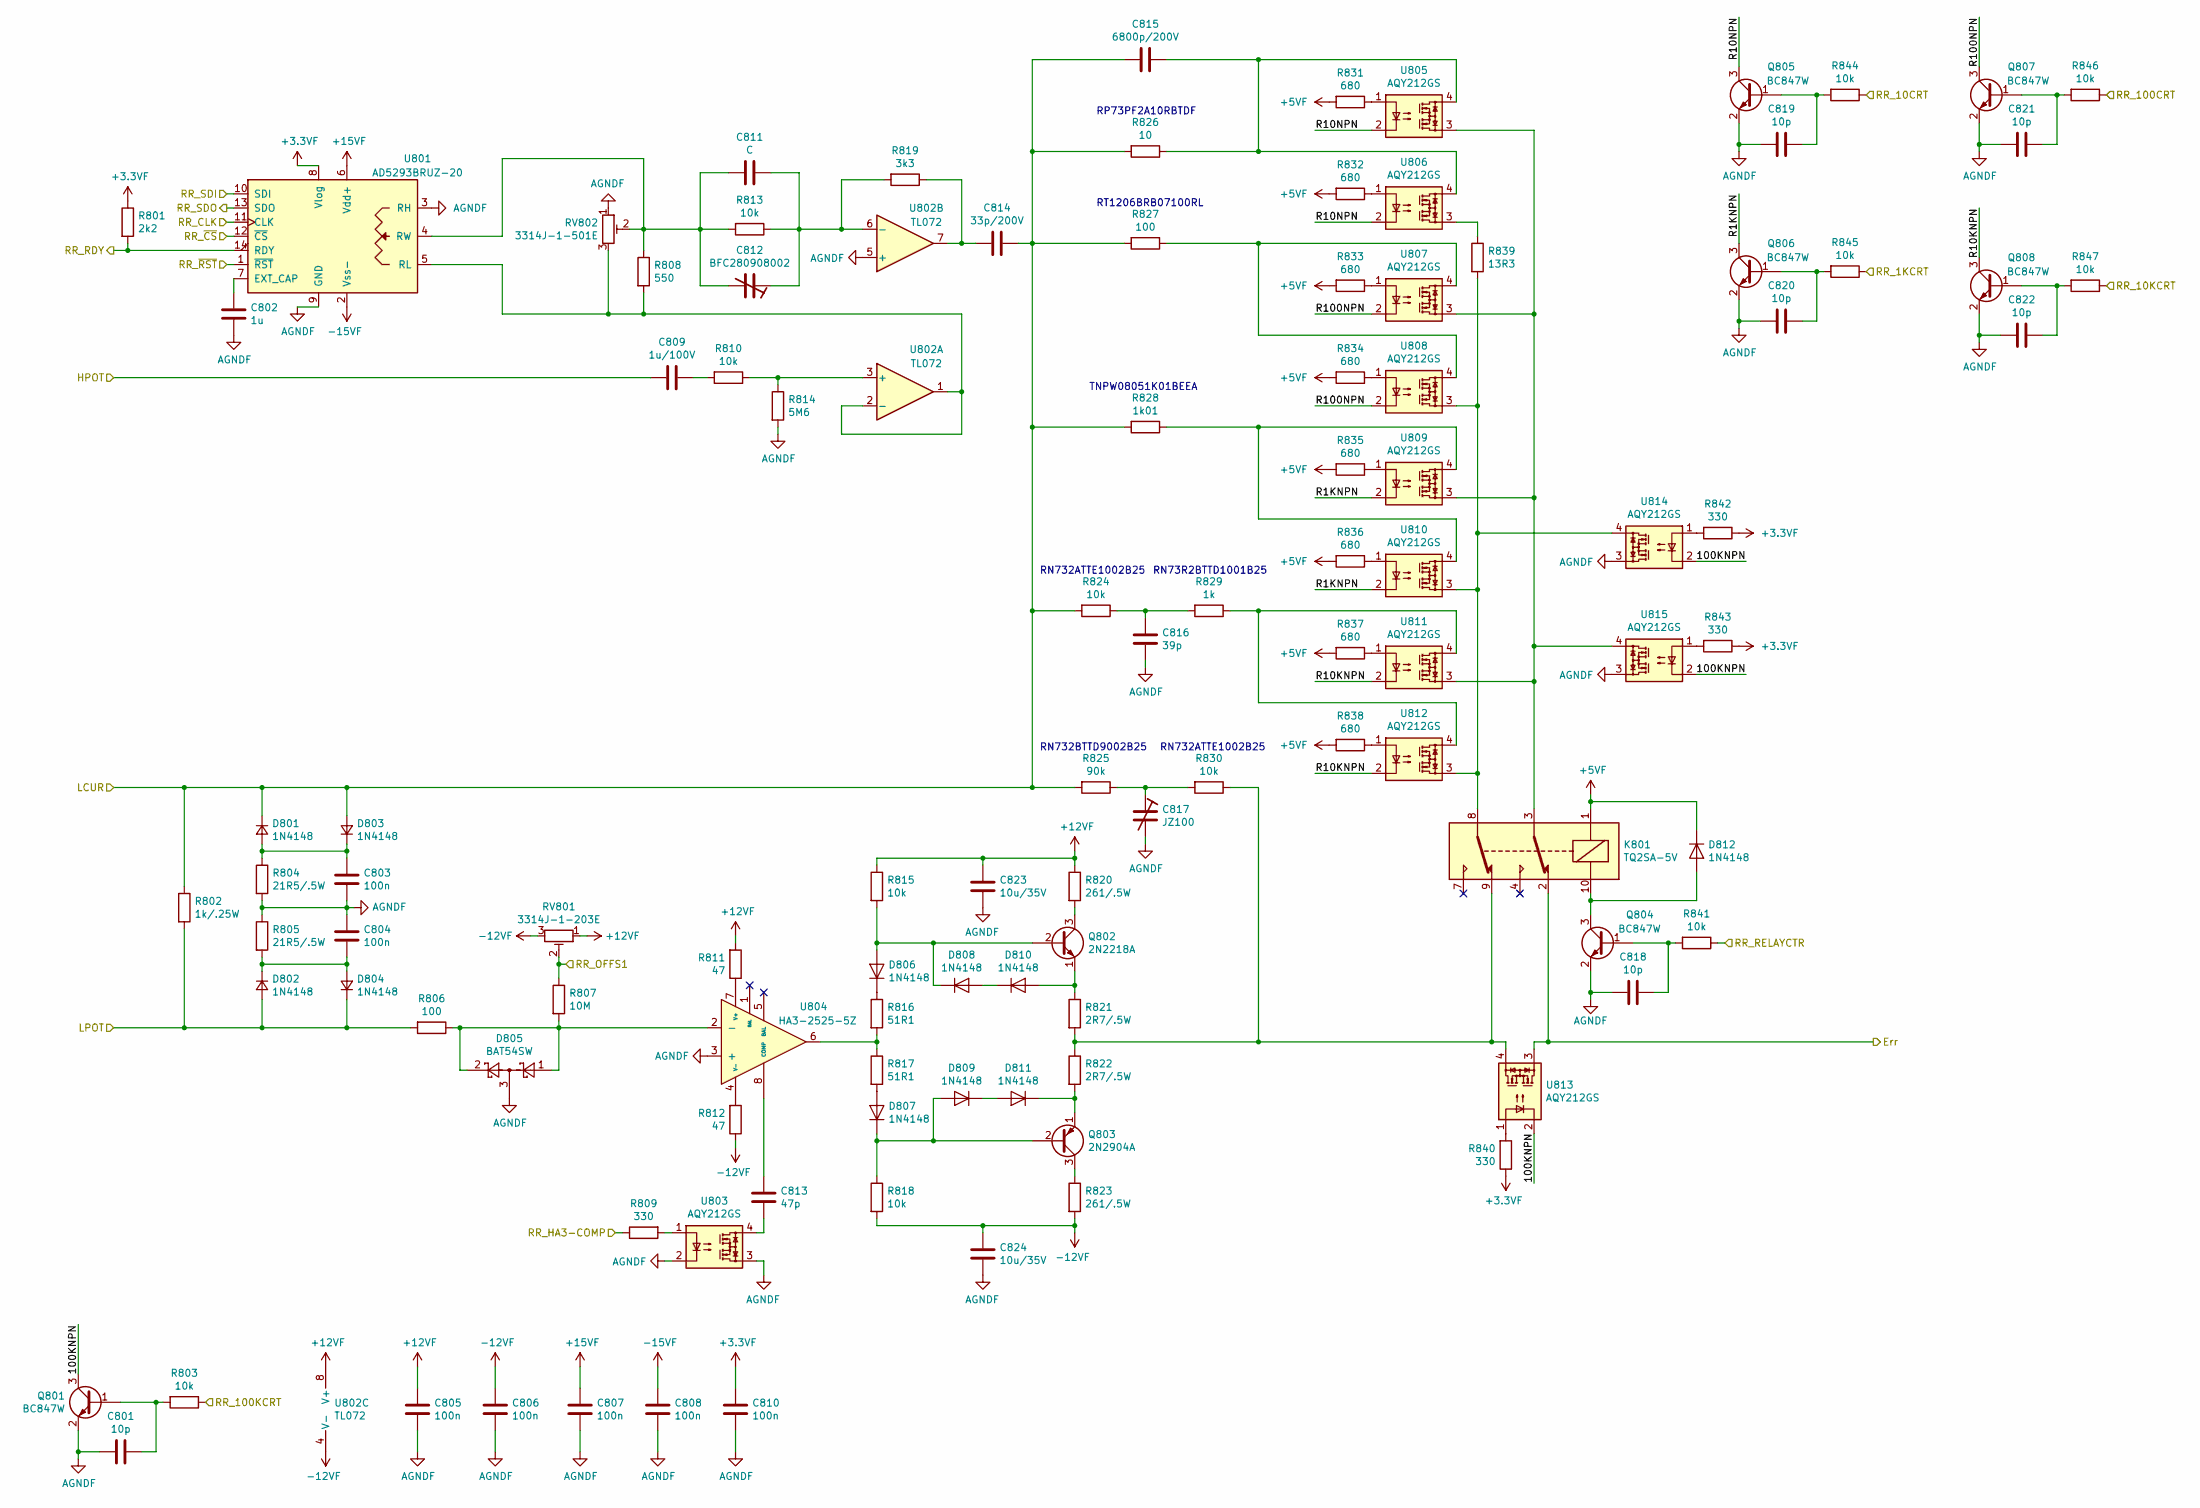
[picture p7: schematic RangeResistor.sch, Range resistor]

Parts:
C801, C818, C819, C820, C821, C822: 10p; C_0603_1608Metric_Pad1.05x0.95mm_HandSolder
C802: 1u; C_0603_1608Metric_Pad1.05x0.95mm_HandSolder
C803, C804, C805, C806, C807, C808, C810: 100n; C_0603_1608Metric_Pad1.05x0.95mm_HandSolder
C809: 1u/100V; C_1812_4532Metric_Pad1.30x3.40mm_HandSolder
C811: C; C_0603_1608Metric_Pad1.05x0.95mm_HandSolder
C812: BFC280908002; BFC2
C813: 47p; C_0603_1608Metric_Pad1.05x0.95mm_HandSolder
C814: 33p/200V; C_0603_1608Metric_Pad1.05x0.95mm_HandSolder
C815: 6800p/200V; C_0603_1608Metric_Pad1.05x0.95mm_HandSolder
C816: 39p; C_0603_1608Metric_Pad1.05x0.95mm_HandSolder
C817: JZ100; JZ
C823, C824: 10u/35V; C_1206_3216Metric_Pad1.42x1.75mm_HandSolder
D801, D802, D803, D804, D806, D807, D808, D809, D810, D811, D812: 1N4148; D_SOD-123
D805: BAT54SW; SOT-323_SC-70
K801: TQ2SA-5V; SA
Q801, Q804, Q805, Q806, Q807, Q808: BC847W; SOT-323_SC-70
Q802: 2N2218A; TO-39-3
Q803: 2N2904A; TO-39-3
R801: 2k2; R_0603_1608Metric_Pad1.05x0.95mm_HandSolder
R802: 1k/.25W; R_1206_3216Metric_Pad1.42x1.75mm_HandSolder
R803, R810, R813, R815, R818, R824, R830, R841, R844, R845, R846, R847: 10k; R_0603_1608Metric_Pad1.05x0.95mm_HandSolder
R804, R805: 21R5/.5W; R_0805_2012Metric_Pad1.15x1.40mm_HandSolder
R806: 100; R_0603_1608Metric_Pad1.05x0.95mm_HandSolder
R807: 10M; R_0603_1608Metric_Pad1.05x0.95mm_HandSolder
R808: 550; R_0603_1608Metric_Pad1.05x0.95mm_HandSolder
R809, R840, R842, R843: 330; R_0603_1608Metric_Pad1.05x0.95mm_HandSolder
R811, R812: 47; R_0603_1608Metric_Pad1.05x0.95mm_HandSolder
R814: 5M6; R_0603_1608Metric_Pad1.05x0.95mm_HandSolder
R816, R817: 51R1; R_0603_1608Metric_Pad1.05x0.95mm_HandSolder
R819: 3k3; R_0603_1608Metric_Pad1.05x0.95mm_HandSolder
R820, R823: 261/.5W; R_0805_2012Metric_Pad1.15x1.40mm_HandSolder
R821, R822: 2R7/.5W; R_0805_2012Metric_Pad1.15x1.40mm_HandSolder
R825: 90k; R_1206_3216Metric_Pad1.42x1.75mm_HandSolder
R826: 10; R_0805_2012Metric_Pad1.15x1.40mm_HandSolder
R827: 100; R_1206_3216Metric_Pad1.42x1.75mm_HandSolder
R828: 1k01; R_0805_2012Metric_Pad1.15x1.40mm_HandSolder
R829: 1k; R_1206_3216Metric_Pad1.42x1.75mm_HandSolder
R831, R832, R833, R834, R835, R836, R837, R838: 680; R_0603_1608Metric_Pad1.05x0.95mm_HandSolder
R839: 13R3; R_0603_1608Metric_Pad1.05x0.95mm_HandSolder
RV801: 3314J-1-203E; Potentiometer_Bourns_3314J_Vertical
RV802: 3314J-1-501E; Potentiometer_Bourns_3314J_Vertical
U801: AD5293BRUZ-20; TSSOP-14_4.4x5mm_P0.65mm
U802: TL072; SOIC-8_3.9x4.9mm_P1.27mm
U803, U805, U806, U807, U808, U809, U810, U811, U812, U813, U814, U815: AQY212GS
U804: HA3-2525-5Z; DIP-8_W7.62mm

Connections:
+3.3VF: C810.1, R801.1, R840.1, R842.1, R843.1, U801.8 (Vlog); also elsewhere on the board
+5VF: D812.1 (K), K801.1, R831.2, R832.2, R833.2, R834.2, R835.2, R836.2, R837.2, R838.2; also elsewhere on the board
+12VF: C805.1, C823.1, R811.2, R815.1, R820.1, RV801.1, U802.8 (V+); also elsewhere on the board
+15VF: C807.1, U801.6 (Vdd+); also elsewhere on the board
-12VF: C806.1, C824.1, R812.1, R818.2, R823.2, RV801.3, U802.4 (V-); also elsewhere on the board
-15VF: C808.1, U801.2 (Vss-); also elsewhere on the board
/Connector/HPOT: C809.2; also elsewhere on the board
/Connector/LCUR: C814.1, C815.2, D801.1 (K), D803.2 (A), R802.1, R824.2, R825.2, R826.2, R827.2, R828.2; also elsewhere on the board
/Connector/LPOT: D802.2 (A), D804.1 (K), R802.2, R806.2; also elsewhere on the board
/DAC/RR_OFFS1: R807.1, RV801.2; also elsewhere on the board
/MCU2/RR_1KCRT: R845.1; also elsewhere on the board
/MCU2/RR_10CRT: R844.1; also elsewhere on the board
/MCU2/RR_10KCRT: R847.1; also elsewhere on the board
/MCU2/RR_100CRT: R846.1; also elsewhere on the board
/MCU2/RR_100KCRT: R803.1; also elsewhere on the board
/MCU2/RR_CLK: U801.11 (CLK); also elsewhere on the board
/MCU2/RR_HA3-COMP: R809.1; also elsewhere on the board
/MCU2/RR_RDY: R801.2, U801.14 (RDY); also elsewhere on the board
/MCU2/RR_RELAYCTR: R841.1; also elsewhere on the board
/MCU2/RR_SDI: U801.10 (SDI); also elsewhere on the board
/MCU2/RR_SDO: U801.13 (SDO); also elsewhere on the board
/MCU2/RR_~CS: U801.12 (~CS~); also elsewhere on the board
/MCU2/RR_~RST: U801.1 (~RST~); also elsewhere on the board
/Process Amplifier/Err: K801.2, U813.3; also elsewhere on the board
/Range Resistors/100KNPN: Q801.3 (C), U813.2, U814.2, U815.2
/Range Resistors/R1KNPN: Q806.3 (C), U809.2, U810.2
/Range Resistors/R10KNPN: Q808.3 (C), U811.2, U812.2
/Range Resistors/R10NPN: Q805.3 (C), U805.2, U806.2
/Range Resistors/R100NPN: Q807.3 (C), U807.2, U808.2
AGNDF: C801.2, C802.2, C803.2, C804.1, C805.2, C806.2, C807.2, C808.2, C810.2, C816.2, C817.2, C818.2, C819.2, C820.2, C821.2, C822.2, C823.2, C824.2, D805.3, Q801.2 (E), Q804.2 (E), Q805.2 (E), Q806.2 (E), Q807.2 (E), Q808.2 (E), R804.2, R805.1, R814.2, RV802.1, U801.3 (RH), U801.9 (GND), U802.5 (+), U803.2, U803.3, U804.3 (+), U814.3, U815.3; also elsewhere on the board
unnamed: C801.1, Q801.1 (B), R803.2
unnamed: C802.1, U801.7 (EXT_CAP)
unnamed: C803.1, D801.2 (A), D803.1 (K), R804.1
unnamed: C804.2, D802.1 (K), D804.2 (A), R805.2
unnamed: C809.1, R810.2
unnamed: C811.1, C812.1, R813.1, R819.2, U802.6 (-)
unnamed: C811.2, C812.2, R808.1, R813.2, RV802.2, U801.4 (RW)
unnamed: C813.1, U803.4
unnamed: C813.2, U804.8 (COMP)
unnamed: C814.2, R819.1, U802.7
unnamed: C815.1, R826.1, U805.4, U806.4
unnamed: C816.1, R824.1, R829.2
unnamed: C817.1, R825.1, R830.2
unnamed: C818.1, Q804.1 (B), R841.2
unnamed: C819.1, Q805.1 (B), R844.2
unnamed: C820.1, Q806.1 (B), R845.2
unnamed: C821.1, Q807.1 (B), R846.2
unnamed: C822.1, Q808.1 (B), R847.2
unnamed: D805.1, D805.2, R806.1, R807.2, U804.2 (-)
unnamed: D806.1 (K), R816.1
unnamed: D806.2 (A), D808.1 (K), Q802.2 (B), R815.2
unnamed: D807.1 (K), D809.2 (A), Q803.2 (B), R818.1
unnamed: D807.2 (A), R817.2
unnamed: D808.2 (A), D810.1 (K)
unnamed: D809.1 (K), D811.2 (A)
unnamed: D810.2 (A), Q802.1 (E), R821.1
unnamed: D811.1 (K), Q803.1 (E), R822.2
unnamed: D812.2 (A), K801.10, Q804.3 (C)
unnamed: K801.3, U805.3, U807.3, U809.3, U811.3, U815.4
unnamed: K801.8, R839.2, U808.3, U810.3, U812.3, U814.4
unnamed: K801.9, R821.2, R822.1, R830.1, U813.4
unnamed: Q802.3 (C), R820.2
unnamed: Q803.3 (C), R823.1
unnamed: R808.2, RV802.3, U801.5 (RL), U802.1, U802.2 (-)
unnamed: R809.2, U803.1
unnamed: R810.1, R814.1, U802.3 (+)
unnamed: R811.1, U804.7 (V+)
unnamed: R812.2, U804.4 (V-)
unnamed: R816.2, R817.1, U804.6
unnamed: R827.1, U807.4, U808.4
unnamed: R828.1, U809.4, U810.4
unnamed: R829.1, U811.4, U812.4
unnamed: R831.1, U805.1
unnamed: R832.1, U806.1
unnamed: R833.1, U807.1
unnamed: R834.1, U808.1
unnamed: R835.1, U809.1
unnamed: R836.1, U810.1
unnamed: R837.1, U811.1
unnamed: R838.1, U812.1
unnamed: R839.1, U806.3
unnamed: R840.2, U813.1
unnamed: R842.2, U814.1
unnamed: R843.2, U815.1

Notes on the sheet:
RP73PF2A10RBTDF
RT1206BRB07100RL
TNPW08051K01BEEA
RN732BTTD9002B25
RN732ATTE1002B25
RN73R2BTTD1001B25

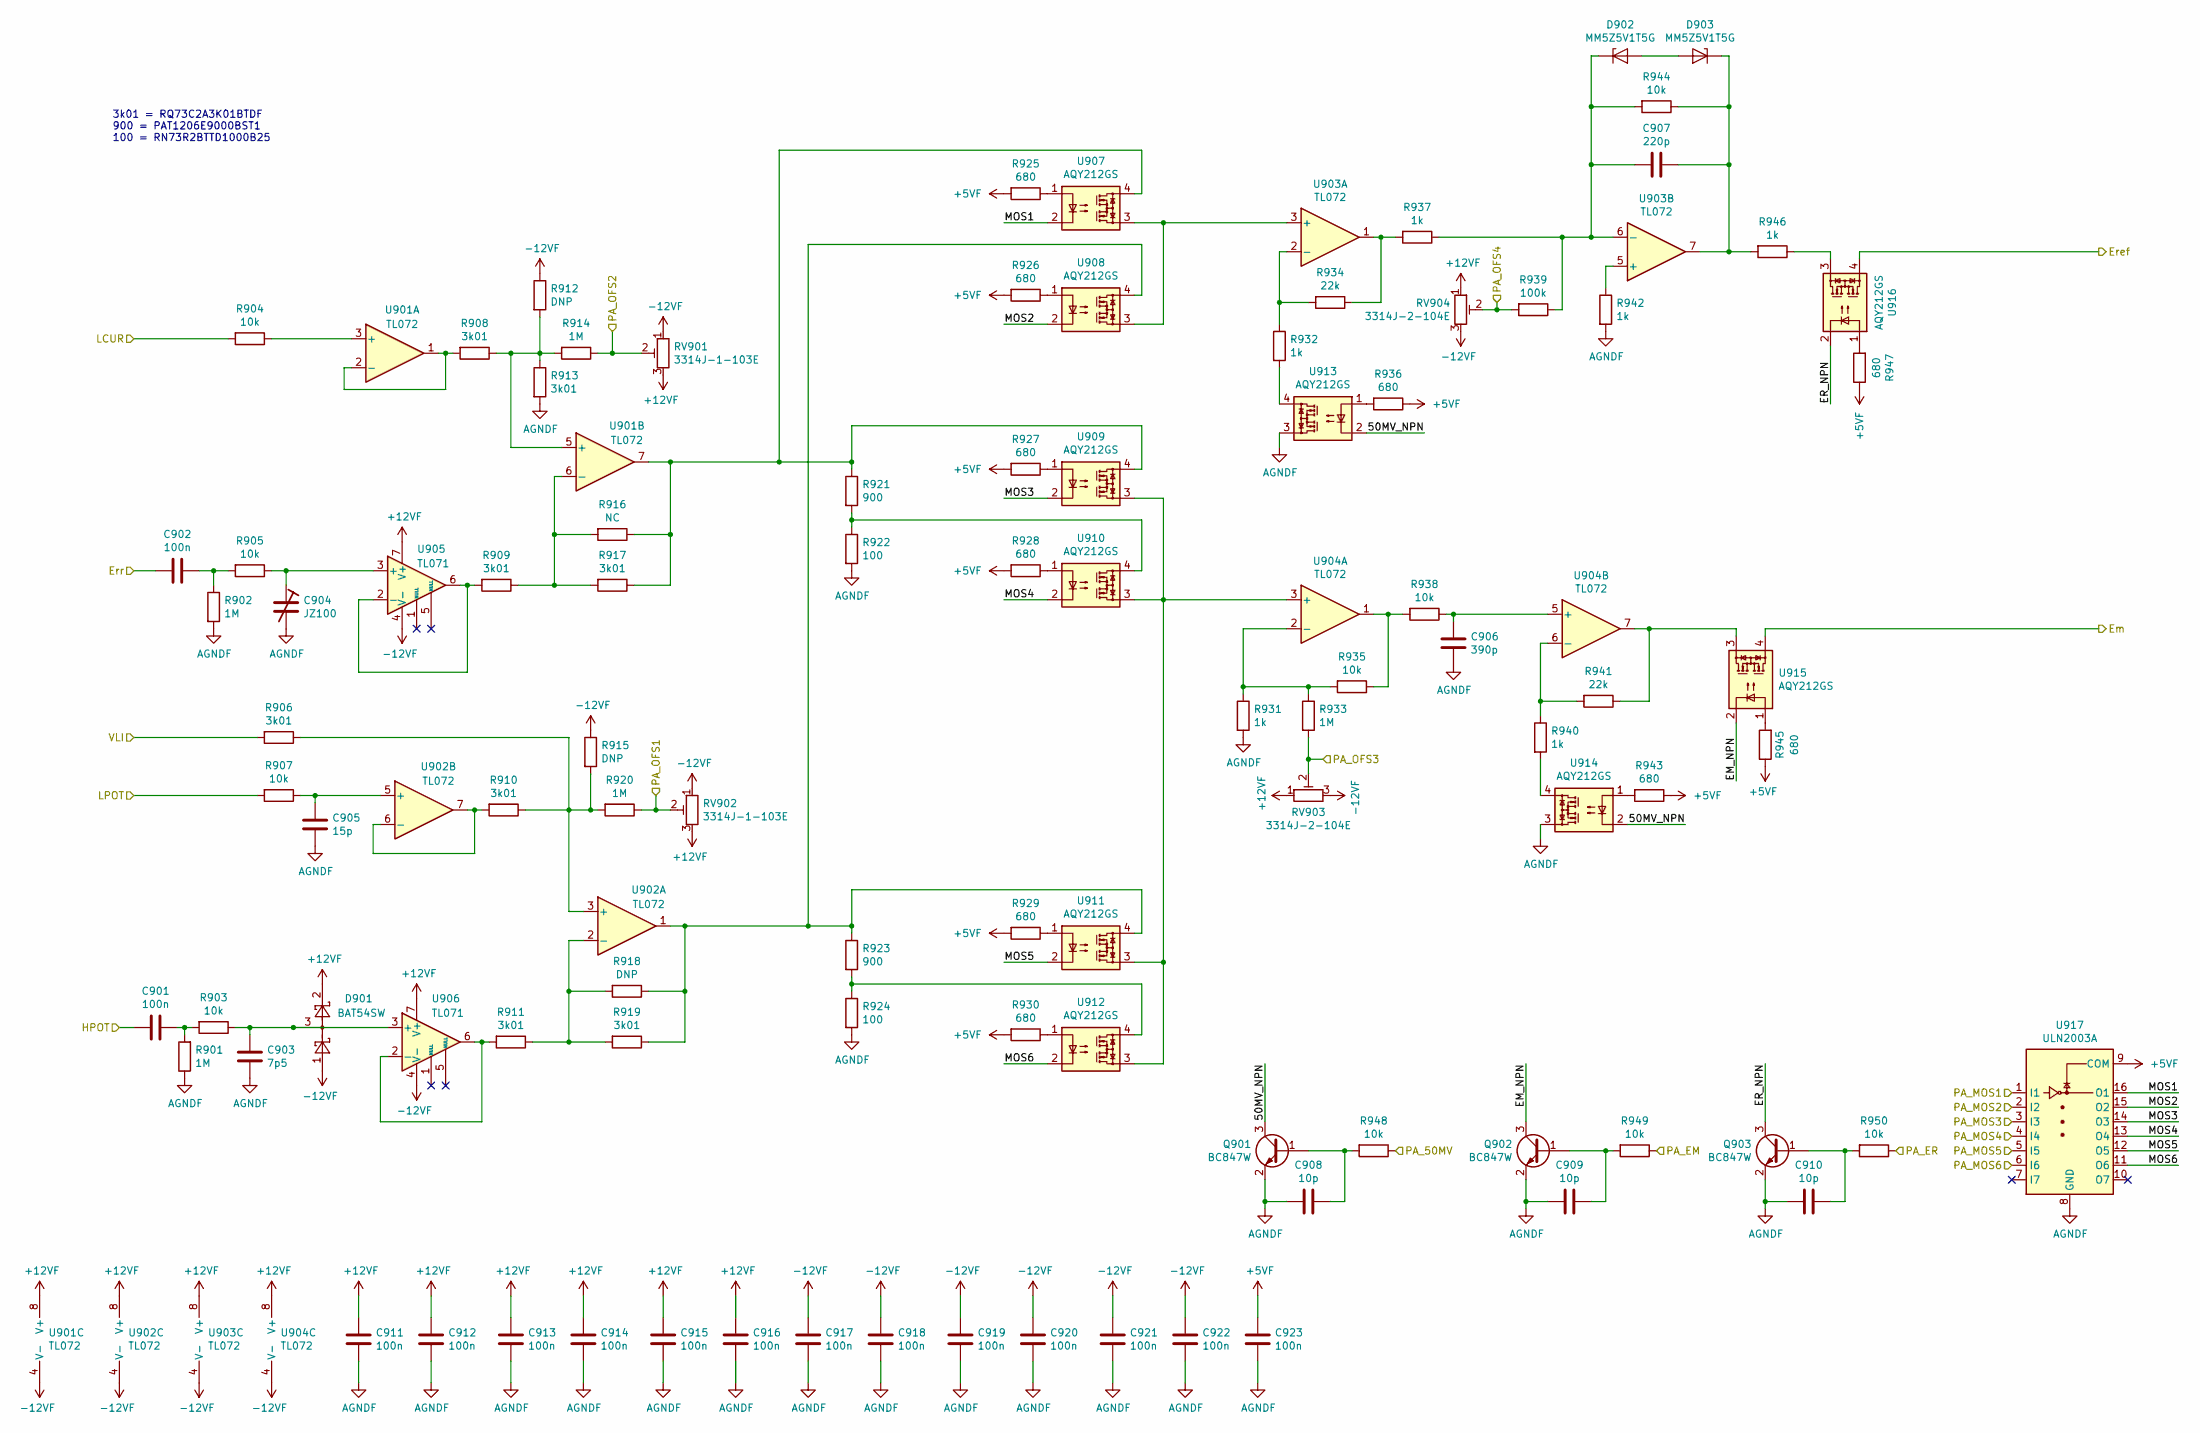
[picture p8: schematic ProcessAmplifier.sch, Process amplifier]

Parts:
C901, C902, C911, C912, C913, C914, C915, C916, C917, C918, C919, C920, C921, C922, C923: 100n; C_0603_1608Metric_Pad1.05x0.95mm_HandSolder
C903: 7p5; C_0603_1608Metric_Pad1.05x0.95mm_HandSolder
C904: JZ100; JZ
C905: 15p; C_0603_1608Metric_Pad1.05x0.95mm_HandSolder
C906: 390p; C_0603_1608Metric_Pad1.05x0.95mm_HandSolder
C907: 220p; C_0603_1608Metric_Pad1.05x0.95mm_HandSolder
C908, C909, C910: 10p; C_0603_1608Metric_Pad1.05x0.95mm_HandSolder
D901: BAT54SW; SOT-323_SC-70
D902, D903: MM5Z5V1T5G; D_SOD-523
Q901, Q902, Q903: BC847W; SOT-323_SC-70
R901, R902, R914, R920, R933: 1M; R_0603_1608Metric_Pad1.05x0.95mm_HandSolder
R903, R904, R905, R907, R935, R938, R944, R948, R949, R950: 10k; R_0603_1608Metric_Pad1.05x0.95mm_HandSolder
R906, R908, R909, R910, R911, R913, R917, R919: 3k01; R_0805_2012Metric_Pad1.15x1.40mm_HandSolder
R912, R915, R918: DNP; R_0603_1608Metric_Pad1.05x0.95mm_HandSolder
R916: NC; R_0603_1608Metric_Pad1.05x0.95mm_HandSolder
R921, R923: 900; R_1206_3216Metric_Pad1.42x1.75mm_HandSolder
R922, R924: 100; R_1206_3216Metric_Pad1.42x1.75mm_HandSolder
R925, R926, R927, R928, R929, R930, R936, R943, R945, R947: 680; R_0603_1608Metric_Pad1.05x0.95mm_HandSolder
R931, R932, R937, R940, R942, R946: 1k; R_0603_1608Metric_Pad1.05x0.95mm_HandSolder
R934, R941: 22k; R_0603_1608Metric_Pad1.05x0.95mm_HandSolder
R939: 100k; R_0603_1608Metric_Pad1.05x0.95mm_HandSolder
RV901, RV902: 3314J-1-103E; Potentiometer_Bourns_3314J_Vertical
RV903, RV904: 3314J-2-104E; Potentiometer_Bourns_3314J_Vertical
U901, U902, U903, U904: TL072; SOIC-8_3.9x4.9mm_P1.27mm
U905, U906: TL071; SOIC-8_3.9x4.9mm_P1.27mm
U907, U908, U909, U910, U911, U912, U913, U914, U915, U916: AQY212GS
U917: ULN2003A; TSSOP-16_4.4x5mm_P0.65mm

Connections:
+5VF: C923.1, R925.2, R926.2, R927.2, R928.2, R929.2, R930.2, R936.1, R943.1, R945.1, R947.1, U917.9 (COM); also elsewhere on the board
+12VF: C911.1, C912.1, C913.1, C914.1, C915.1, C916.1, D901.2, RV901.3, RV902.3, RV903.1, RV904.1, U901.8 (V+), U902.8 (V+), U903.8 (V+), U904.8 (V+), U905.7 (V+), U906.7 (V+); also elsewhere on the board
-12VF: C917.1, C918.1, C919.1, C920.1, C921.1, C922.1, D901.1, R912.1, R915.1, RV901.1, RV902.1, RV903.3, RV904.3, U901.4 (V-), U902.4 (V-), U903.4 (V-), U904.4 (V-), U905.4 (V-), U906.4 (V-); also elsewhere on the board
/ADC/Em: U915.4; also elsewhere on the board
/ADC/Eref: U916.4; also elsewhere on the board
/Connector/HPOT: C901.2; also elsewhere on the board
/Connector/LCUR: R904.2; also elsewhere on the board
/Connector/LPOT: R907.2; also elsewhere on the board
/DAC/PA_OFFS1: R920.1, RV902.2; also elsewhere on the board
/DAC/PA_OFFS2: R914.1, RV901.2; also elsewhere on the board
/DAC/PA_OFFS3: R933.2, RV903.2; also elsewhere on the board
/DAC/PA_OFFS4: R939.2, RV904.2; also elsewhere on the board
/FGEN Buffer + Source resistor/VLI: R906.2; also elsewhere on the board
/MCU2/PA_50MV: R948.1; also elsewhere on the board
/MCU2/PA_EM: R949.1; also elsewhere on the board
/MCU2/PA_ER: R950.1; also elsewhere on the board
/MCU2/PA_MOS1: U917.1 (I1); also elsewhere on the board
/MCU2/PA_MOS2: U917.2 (I2); also elsewhere on the board
/MCU2/PA_MOS3: U917.3 (I3); also elsewhere on the board
/MCU2/PA_MOS4: U917.4 (I4); also elsewhere on the board
/MCU2/PA_MOS5: U917.5 (I5); also elsewhere on the board
/MCU2/PA_MOS6: U917.6 (I6); also elsewhere on the board
/Process Amplifier/50MV_NPN: Q901.3 (C), U913.2, U914.2
/Process Amplifier/EM_NPN: Q902.3 (C), U915.2
/Process Amplifier/ER_NPN: Q903.3 (C), U916.2
/Process Amplifier/Err: C902.2; also elsewhere on the board
/Process Amplifier/MOS1: U907.2, U917.16 (O1)
/Process Amplifier/MOS2: U908.2, U917.15 (O2)
/Process Amplifier/MOS3: U909.2, U917.14 (O3)
/Process Amplifier/MOS4: U910.2, U917.13 (O4)
/Process Amplifier/MOS5: U911.2, U917.12 (O5)
/Process Amplifier/MOS6: U912.2, U917.11 (O6)
AGNDF: C903.2, C904.2, C905.2, C906.2, C908.2, C909.2, C910.2, C911.2, C912.2, C913.2, C914.2, C915.2, C916.2, C917.2, C918.2, C919.2, C920.2, C921.2, C922.2, C923.2, Q901.2 (E), Q902.2 (E), Q903.2 (E), R901.1, R902.2, R913.2, R922.2, R924.2, R931.2, R942.2, U913.3, U914.3, U917.8 (GND); also elsewhere on the board
unnamed: C901.1, R901.2, R903.2
unnamed: C902.1, R902.1, R905.2
unnamed: C903.1, D901.3, R903.1, U906.3 (+)
unnamed: C904.1, R905.1, U905.3 (+)
unnamed: C905.1, R907.1, U902.5 (+)
unnamed: C906.1, R938.1, U904.5 (+)
unnamed: C907.1, D903.1 (K), R944.1, R946.2, U903.7
unnamed: C907.2, D902.1 (K), R937.1, R939.1, R944.2, U903.6 (-)
unnamed: C908.1, Q901.1 (B), R948.2
unnamed: C909.1, Q902.1 (B), R949.2
unnamed: C910.1, Q903.1 (B), R950.2
unnamed: D902.2 (A), D903.2 (A)
unnamed: R904.1, U901.3 (+)
unnamed: R906.1, R910.1, R915.2, R920.2, U902.3 (+)
unnamed: R908.1, R912.2, R913.1, R914.2, U901.5 (+)
unnamed: R908.2, U901.1, U901.2 (-)
unnamed: R909.1, R916.2, R917.2, U901.6 (-)
unnamed: R909.2, U905.2 (-), U905.6
unnamed: R910.2, U902.6 (-), U902.7
unnamed: R911.1, R918.2, R919.2, U902.2 (-)
unnamed: R911.2, U906.2 (-), U906.6
unnamed: R916.1, R917.1, R921.1, U901.7, U907.4, U909.4
unnamed: R918.1, R919.1, R923.1, U902.1, U908.4, U911.4
unnamed: R921.2, R922.1, U910.4
unnamed: R923.2, R924.1, U912.4
unnamed: R925.1, U907.1
unnamed: R926.1, U908.1
unnamed: R927.1, U909.1
unnamed: R928.1, U910.1
unnamed: R929.1, U911.1
unnamed: R930.1, U912.1
unnamed: R931.1, R933.1, R935.2, U904.2 (-)
unnamed: R932.1, R934.2, U903.2 (-)
unnamed: R932.2, U913.4
unnamed: R934.1, R937.2, U903.1
unnamed: R935.1, R938.2, U904.1
unnamed: R936.2, U913.1
unnamed: R940.1, R941.2, U904.6 (-)
unnamed: R940.2, U914.4
unnamed: R941.1, U904.7, U915.3
unnamed: R942.1, U903.5 (+)
unnamed: R943.2, U914.1
unnamed: R945.2, U915.1
unnamed: R946.1, U916.3
unnamed: R947.2, U916.1
unnamed: U903.3 (+), U907.3, U908.3
unnamed: U904.3 (+), U909.3, U910.3, U911.3, U912.3

Notes on the sheet:
3k01 = RQ73C2A3K01BTDF 900 = PAT1206E9000BST1 100 = RN73R2BTTD1000B25
