BehrensG/ETH1CLCR1/hardware/project/ETH1CLCR1/ETH1CLCR1.kicad_pcb

## KiCad design hardware/project/ETH1CLCR1/ETH1CLCR1.kicad_pcb (continued)

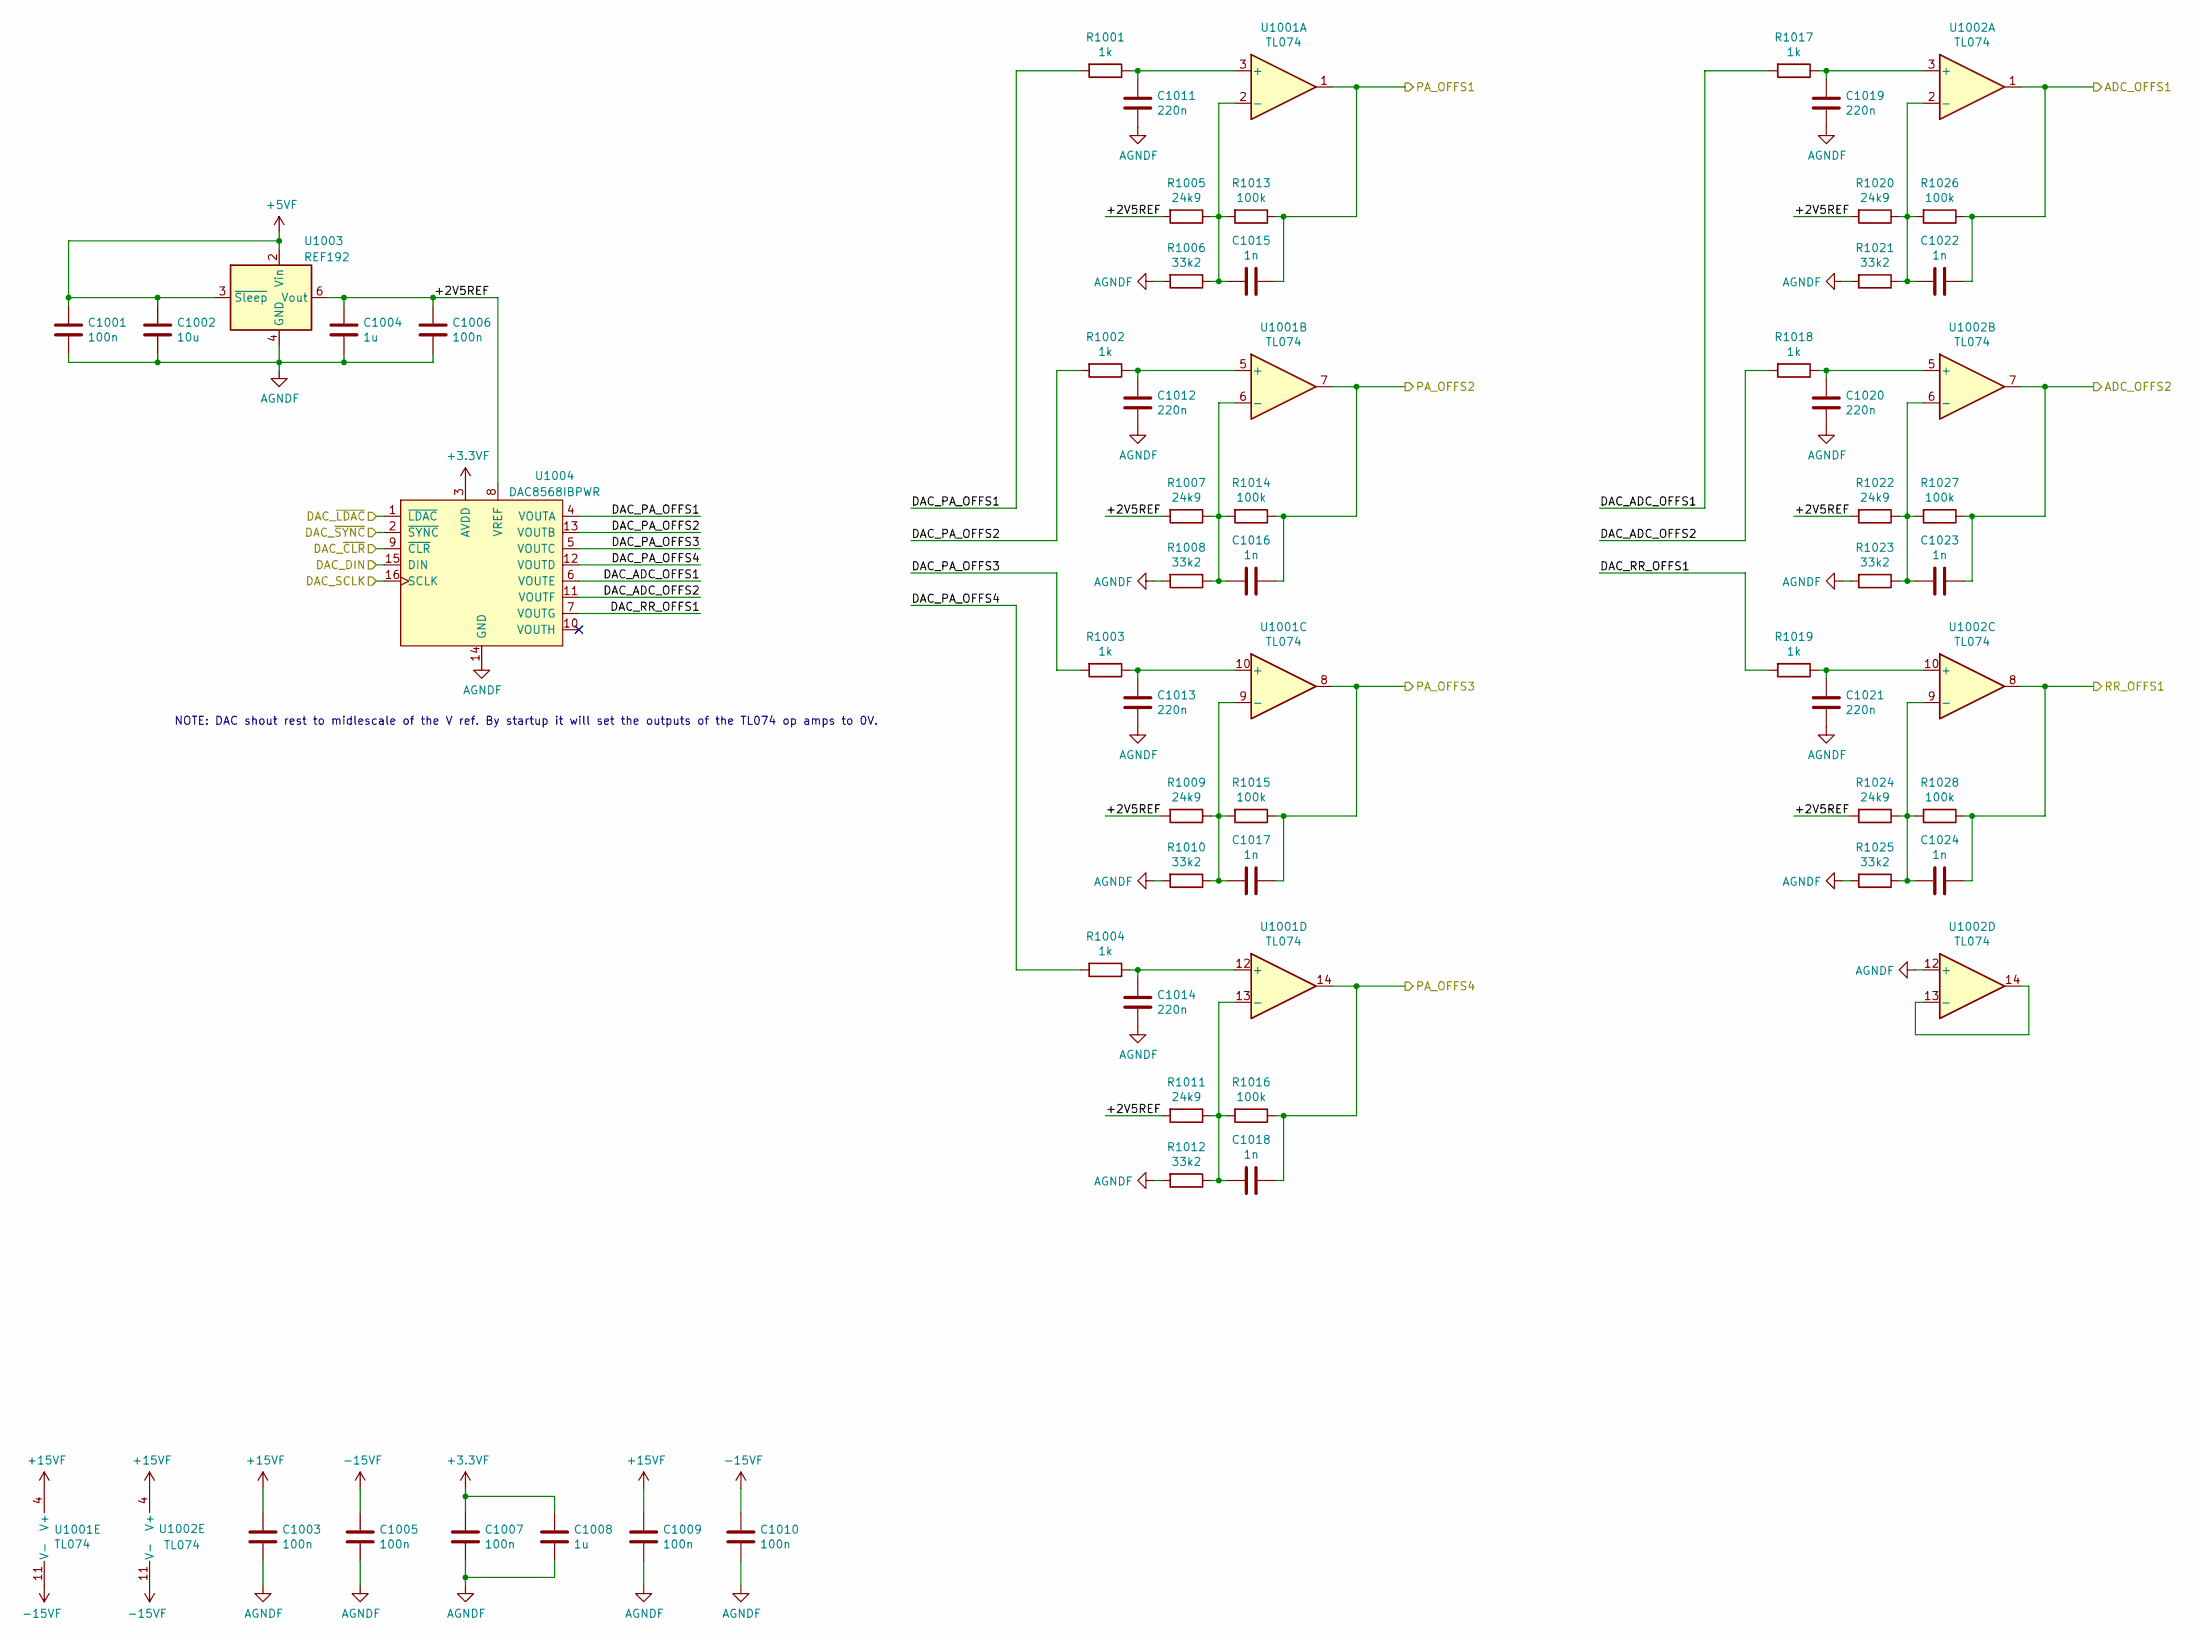
[picture p9: schematic DAC.sch]

Parts:
C1001, C1003, C1005, C1006, C1007, C1009, C1010: 100n; C_0603_1608Metric_Pad1.05x0.95mm_HandSolder
C1002: 10u; C_0805_2012Metric_Pad1.15x1.40mm_HandSolder
C1004, C1008: 1u; C_0603_1608Metric_Pad1.05x0.95mm_HandSolder
C1011, C1012, C1013, C1014, C1019, C1020, C1021: 220n; C_0603_1608Metric_Pad1.05x0.95mm_HandSolder
C1015, C1016, C1017, C1018, C1022, C1023, C1024: 1n; C_0603_1608Metric_Pad1.05x0.95mm_HandSolder
R1001, R1002, R1003, R1004, R1017, R1018, R1019: 1k; R_0603_1608Metric_Pad1.05x0.95mm_HandSolder
R1005, R1007, R1009, R1011, R1020, R1022, R1024: 24k9; R_0603_1608Metric_Pad1.05x0.95mm_HandSolder
R1006, R1008, R1010, R1012, R1021, R1023, R1025: 33k2; R_0603_1608Metric_Pad1.05x0.95mm_HandSolder
R1013, R1014, R1015, R1016, R1026, R1027, R1028: 100k; R_0603_1608Metric_Pad1.05x0.95mm_HandSolder
U1001, U1002: TL074; SOIC-14_3.9x8.7mm_P1.27mm
U1003: REF192; SSOP-8_3.9x5.05mm_P1.27mm
U1004: DAC8568IBPWR; TSSOP-16_4.4x5mm_P0.65mm

Connections:
+3.3VF: C1007.1, C1008.1, U1004.3 (AVDD); also elsewhere on the board
+5VF: C1001.1, C1002.1, U1003.2 (Vin), U1003.3 (~Sleep~); also elsewhere on the board
+15VF: C1003.1, C1009.1, U1001.4 (V+), U1002.4 (V+); also elsewhere on the board
-15VF: C1005.1, C1010.1, U1001.11 (V-), U1002.11 (V-); also elsewhere on the board
/ADC/ADC_OFFS1: C1022.1, R1026.1, U1002.1; also elsewhere on the board
/ADC/ADC_OFFS2: C1023.1, R1027.1, U1002.7; also elsewhere on the board
/DAC/+2V5REF: C1004.1, C1006.1, R1005.2, R1007.2, R1009.2, R1011.2, R1020.2, R1022.2, R1024.2, U1003.6 (Vout), U1004.8 (VREF)
/DAC/DAC_ADC_OFFS1: R1017.2, U1004.6 (VOUTE)
/DAC/DAC_ADC_OFFS2: R1018.2, U1004.11 (VOUTF)
/DAC/DAC_DIN: U1004.15 (DIN); also elsewhere on the board
/DAC/DAC_PA_OFFS1: R1001.2, U1004.4 (VOUTA)
/DAC/DAC_PA_OFFS2: R1002.2, U1004.13 (VOUTB)
/DAC/DAC_PA_OFFS3: R1003.2, U1004.5 (VOUTC)
/DAC/DAC_PA_OFFS4: R1004.2, U1004.12 (VOUTD)
/DAC/DAC_RR_OFFS1: R1019.2, U1004.7 (VOUTG)
/DAC/DAC_SCLK: U1004.16 (SCLK); also elsewhere on the board
/DAC/DAC_~CLR: U1004.9 (~CLR); also elsewhere on the board
/DAC/DAC_~LDAC: U1004.1 (~LDAC); also elsewhere on the board
/DAC/DAC_~SYNC: U1004.2 (~SYNC); also elsewhere on the board
/DAC/PA_OFFS1: C1015.1, R1013.1, U1001.1; also elsewhere on the board
/DAC/PA_OFFS2: C1016.1, R1014.1, U1001.7; also elsewhere on the board
/DAC/PA_OFFS3: C1017.1, R1015.1, U1001.8; also elsewhere on the board
/DAC/PA_OFFS4: C1018.1, R1016.1, U1001.14; also elsewhere on the board
/DAC/RR_OFFS1: C1024.1, R1028.1, U1002.8; also elsewhere on the board
AGNDF: C1001.2, C1002.2, C1003.2, C1004.2, C1005.2, C1006.2, C1007.2, C1008.2, C1009.2, C1010.2, C1011.2, C1012.2, C1013.2, C1014.2, C1019.2, C1020.2, C1021.2, R1006.2, R1008.2, R1010.2, R1012.2, R1021.2, R1023.2, R1025.2, U1002.12 (+), U1003.4 (GND), U1004.14 (GND); also elsewhere on the board
unnamed: C1011.1, R1001.1, U1001.3 (+)
unnamed: C1012.1, R1002.1, U1001.5 (+)
unnamed: C1013.1, R1003.1, U1001.10 (+)
unnamed: C1014.1, R1004.1, U1001.12 (+)
unnamed: C1015.2, R1005.1, R1006.1, R1013.2, U1001.2 (-)
unnamed: C1016.2, R1007.1, R1008.1, R1014.2, U1001.6 (-)
unnamed: C1017.2, R1009.1, R1010.1, R1015.2, U1001.9 (-)
unnamed: C1018.2, R1011.1, R1012.1, R1016.2, U1001.13 (-)
unnamed: C1019.1, R1017.1, U1002.3 (+)
unnamed: C1020.1, R1018.1, U1002.5 (+)
unnamed: C1021.1, R1019.1, U1002.10 (+)
unnamed: C1022.2, R1020.1, R1021.1, R1026.2, U1002.2 (-)
unnamed: C1023.2, R1022.1, R1023.1, R1027.2, U1002.6 (-)
unnamed: C1024.2, R1024.1, R1025.1, R1028.2, U1002.9 (-)
unnamed: U1002.13 (-), U1002.14

Notes on the sheet:
NOTE: DAC shout rest to midlescale of the V ref. By startup it will set the outputs of the TL074 op amps to 0V.

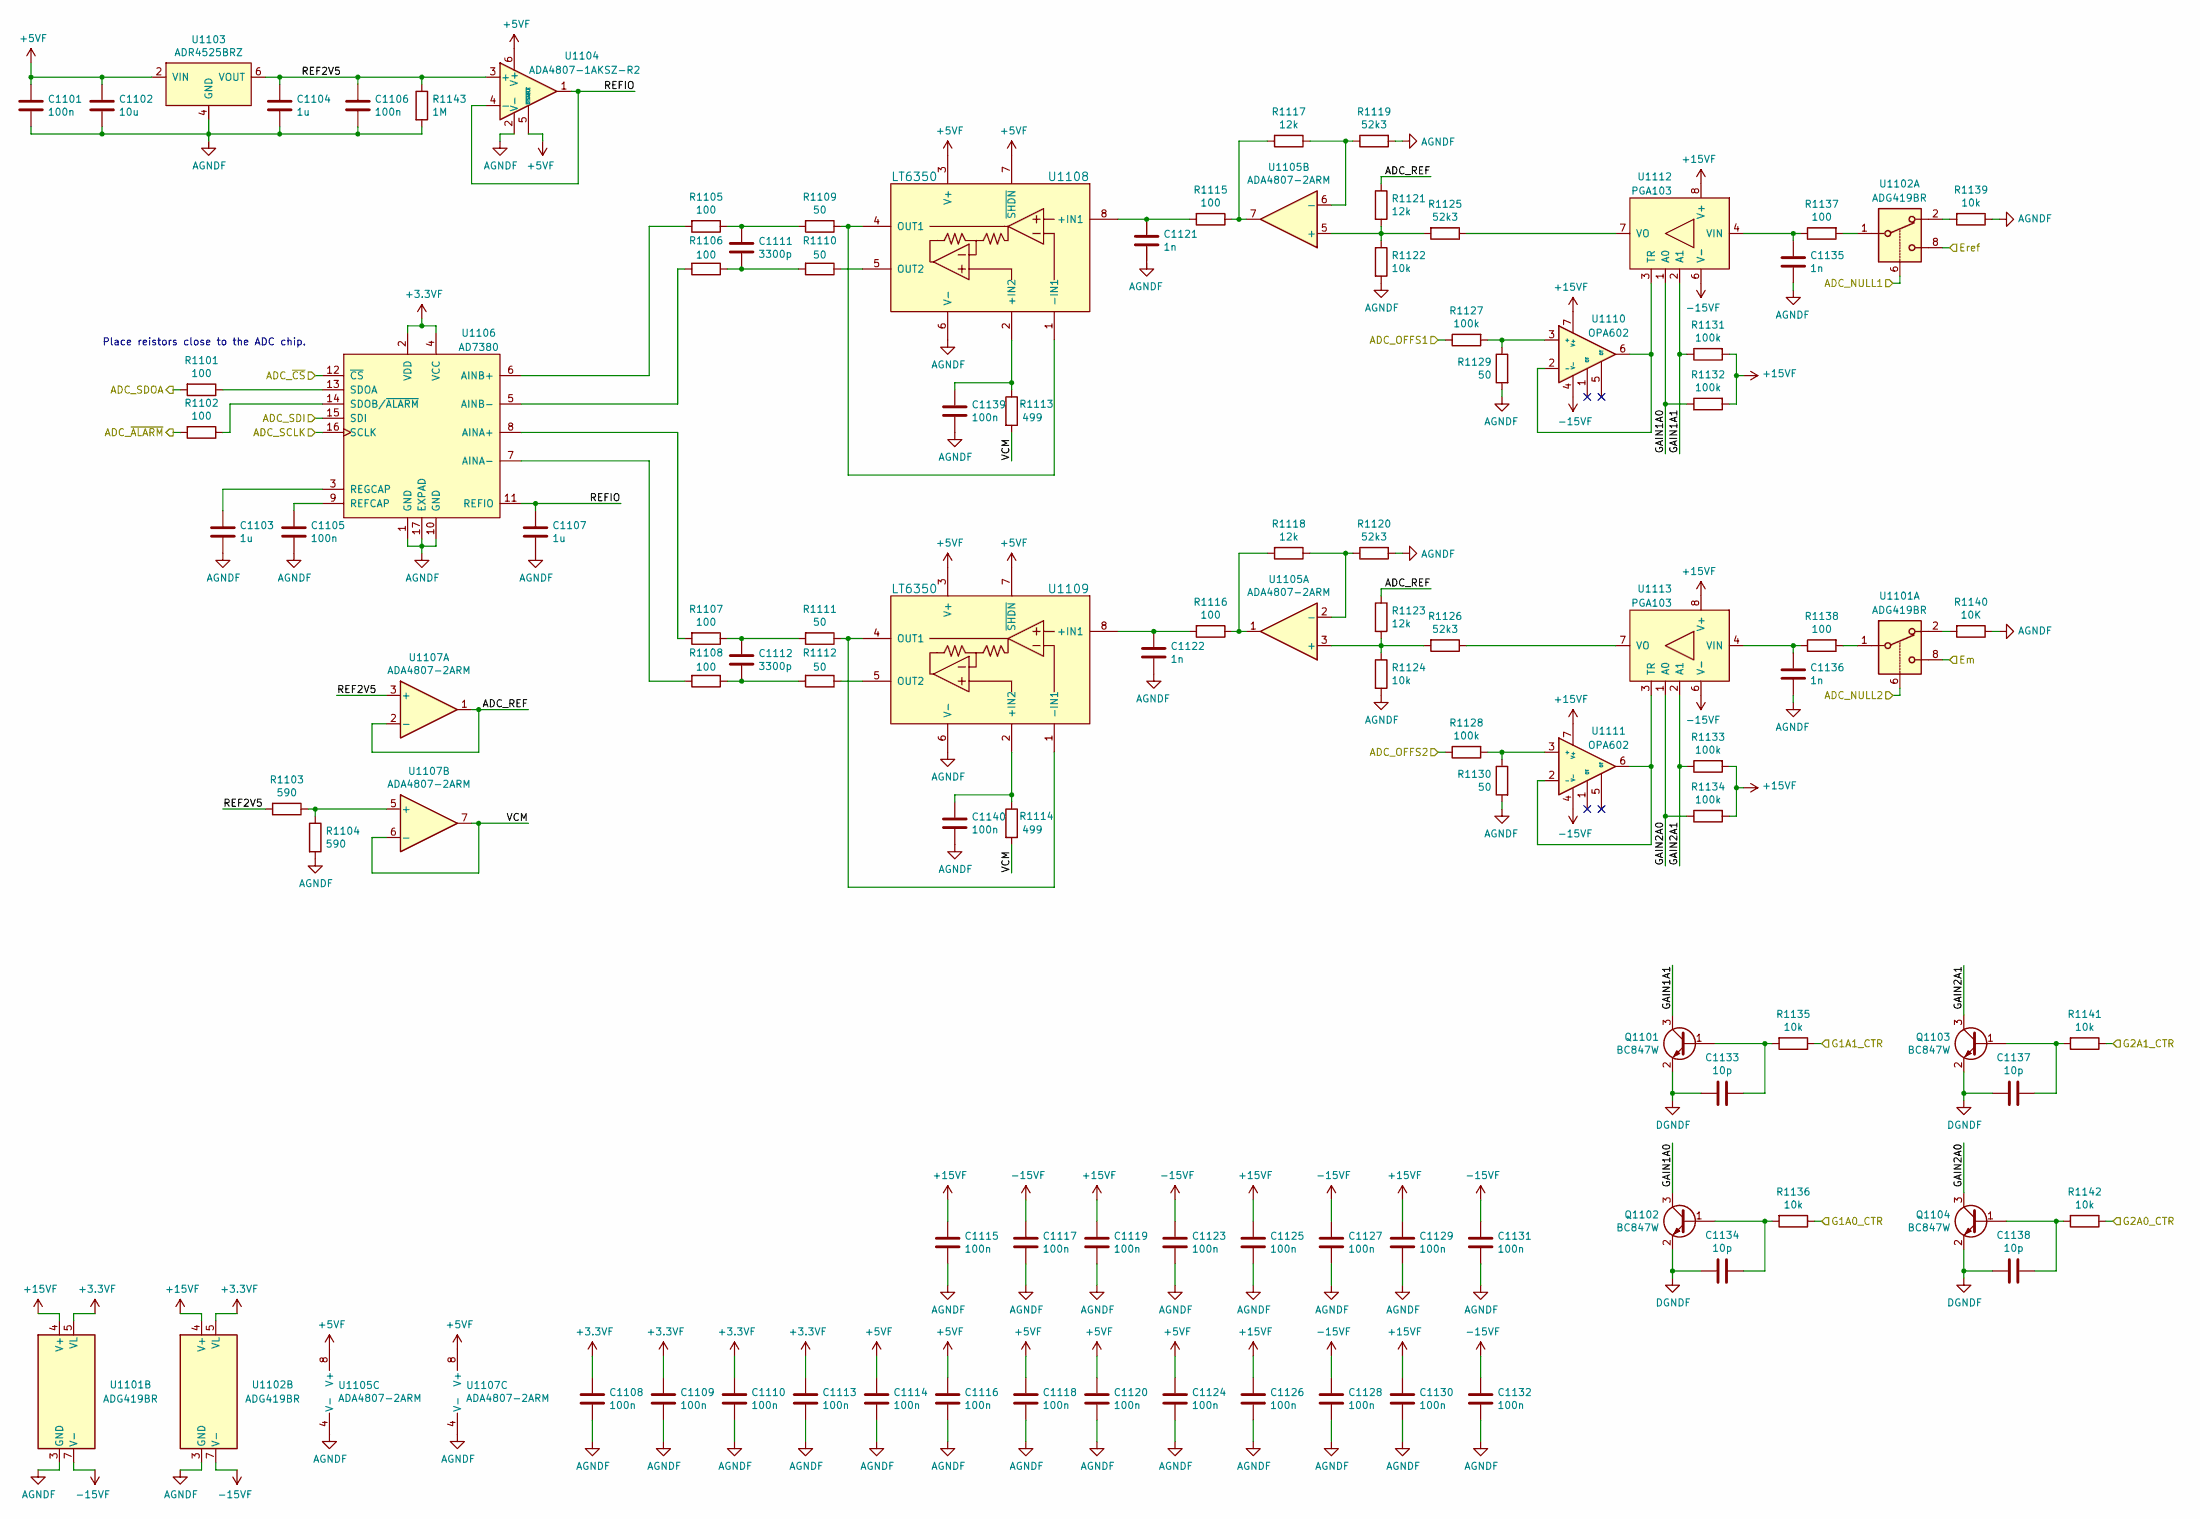
[picture p10: schematic ADC.sch]

Parts:
C1101, C1105, C1106, C1108, C1109, C1110, C1113, C1114, C1115, C1116, C1117, C1118, C1119, C1120, C1123, C1124, C1125, C1126, C1127, C1128, C1129, C1130, C1131, C1132, C1139, C1140: 100n; C_0603_1608Metric_Pad1.05x0.95mm_HandSolder
C1102: 10u; C_0805_2012Metric_Pad1.15x1.40mm_HandSolder
C1103, C1104, C1107: 1u; C_0603_1608Metric_Pad1.05x0.95mm_HandSolder
C1111, C1112: 3300p; C_0603_1608Metric_Pad1.05x0.95mm_HandSolder
C1121, C1122, C1135, C1136: 1n; C_0603_1608Metric_Pad1.05x0.95mm_HandSolder
C1133, C1134, C1137, C1138: 10p; C_0603_1608Metric_Pad1.05x0.95mm_HandSolder
Q1101, Q1102, Q1103, Q1104: BC847W; SOT-323_SC-70
R1101, R1102, R1105, R1106, R1107, R1108, R1115, R1116, R1137, R1138: 100; R_0603_1608Metric_Pad1.05x0.95mm_HandSolder
R1103, R1104: 590; R_0603_1608Metric_Pad1.05x0.95mm_HandSolder
R1109, R1110, R1111, R1112, R1129, R1130: 50; R_0603_1608Metric_Pad1.05x0.95mm_HandSolder
R1113, R1114: 499; R_0603_1608Metric_Pad1.05x0.95mm_HandSolder
R1117, R1118, R1121, R1123: 12k; R_0603_1608Metric_Pad1.05x0.95mm_HandSolder
R1119, R1120, R1125, R1126: 52k3; R_0603_1608Metric_Pad1.05x0.95mm_HandSolder
R1122, R1124, R1135, R1136, R1139, R1141, R1142: 10k; R_0603_1608Metric_Pad1.05x0.95mm_HandSolder
R1127, R1128, R1131, R1132, R1133, R1134: 100k; R_0603_1608Metric_Pad1.05x0.95mm_HandSolder
R1140: 10K; R_0603_1608Metric_Pad1.05x0.95mm_HandSolder
R1143: 1M; R_0603_1608Metric_Pad1.05x0.95mm_HandSolder
U1101, U1102: ADG419BR; SOIC-8_3.9x4.9mm_P1.27mm
U1103: ADR4525BRZ; SOIC-8_3.9x4.9mm_P1.27mm
U1104: ADA4807-1AKSZ-R2; SOT-363_SC-70-6_Handsoldering
U1105, U1107: ADA4807-2ARM; MSOP-8_3x3mm_P0.65mm
U1106: AD7380; LFCSP-16-1EP_3x3mm_P0.5mm_EP1.6x1.6mm
U1108, U1109: LT6350; MSOP-8_3x3mm_P0.65mm
U1110, U1111: OPA602; SOIC-8_3.9x4.9mm_P1.27mm
U1112, U1113: PGA103; SOIC-8_3.9x4.9mm_P1.27mm

Connections:
+3.3VF: C1108.1, C1109.1, C1110.1, C1113.1, U1101.5 (VL), U1102.5 (VL), U1106.2 (VDD), U1106.4 (VCC); also elsewhere on the board
+5VF: C1101.1, C1102.1, C1114.1, C1116.1, C1118.1, C1120.1, C1124.1, U1103.2 (VIN), U1104.5 (~DISABLE), U1104.6 (V+), U1105.8 (V+), U1107.8 (V+), U1108.3 (V+), U1108.7 (~SHDN), U1109.3 (V+), U1109.7 (~SHDN); also elsewhere on the board
+15VF: C1115.1, C1119.1, C1125.1, C1126.1, C1129.1, C1130.1, R1131.2, R1132.2, R1133.2, R1134.2, U1101.4 (V+), U1102.4 (V+), U1110.7 (V+), U1111.7 (V+), U1112.8 (V+), U1113.8 (V+); also elsewhere on the board
-15VF: C1117.1, C1123.1, C1127.1, C1128.1, C1131.1, C1132.1, U1101.7 (V-), U1102.7 (V-), U1110.4 (V-), U1111.4 (V-), U1112.6 (V-), U1113.6 (V-); also elsewhere on the board
/ADC/ADC_NULL1: U1102.6; also elsewhere on the board
/ADC/ADC_NULL2: U1101.6; also elsewhere on the board
/ADC/ADC_OFFS1: R1127.1; also elsewhere on the board
/ADC/ADC_OFFS2: R1128.1; also elsewhere on the board
/ADC/ADC_REF: R1121.1, R1123.1, U1107.1, U1107.2 (-)
/ADC/ADC_SCLK: U1106.16 (SCLK); also elsewhere on the board
/ADC/ADC_SDI: U1106.15 (SDI); also elsewhere on the board
/ADC/ADC_SDOA: R1101.2; also elsewhere on the board
/ADC/ADC_~ALARM: R1102.2; also elsewhere on the board
/ADC/ADC_~CS: U1106.12 (~CS); also elsewhere on the board
/ADC/Em: U1101.8; also elsewhere on the board
/ADC/Eref: U1102.8; also elsewhere on the board
/ADC/G1A0_CTR: R1136.1; also elsewhere on the board
/ADC/G1A1_CTR: R1135.1; also elsewhere on the board
/ADC/G2A0_CTR: R1142.1; also elsewhere on the board
/ADC/G2A1_CTR: R1141.1; also elsewhere on the board
/ADC/GAIN1A0: Q1102.3 (C), R1132.1, U1112.1 (A0)
/ADC/GAIN1A1: Q1101.3 (C), R1131.1, U1112.2 (A1)
/ADC/GAIN2A0: Q1104.3 (C), R1134.1, U1113.1 (A0)
/ADC/GAIN2A1: Q1103.3 (C), R1133.1, U1113.2 (A1)
/ADC/REF2V5: C1104.1, C1106.1, R1103.2, R1143.1, U1103.6 (VOUT), U1104.3 (+), U1107.3 (+)
/ADC/REFIO: C1107.1, U1104.1, U1104.4 (-), U1106.11 (REFIO)
/ADC/VCM: R1113.2, R1114.2, U1107.6 (-), U1107.7
AGNDF: C1101.2, C1102.2, C1103.2, C1104.2, C1105.2, C1106.2, C1107.2, C1108.2, C1109.2, C1110.2, C1113.2, C1114.2, C1115.2, C1116.2, C1117.2, C1118.2, C1119.2, C1120.2, C1121.2, C1122.2, C1123.2, C1124.2, C1125.2, C1126.2, C1127.2, C1128.2, C1129.2, C1130.2, C1131.2, C1132.2, C1133.2, C1134.2, C1135.2, C1136.2, C1137.2, C1138.2, C1139.2, C1140.2, Q1101.2 (E), Q1102.2 (E), Q1103.2 (E), Q1104.2 (E), R1104.2, R1119.2, R1120.2, R1122.2, R1124.2, R1129.2, R1130.2, R1139.1, R1140.1, R1143.2, U1101.3 (GND), U1102.3 (GND), U1103.4 (GND), U1104.2 (V-), U1105.4 (V-), U1106.1 (GND), U1106.10 (GND), U1106.17 (EXPAD), U1107.4 (V-), U1108.6 (V-), U1109.6 (V-); also elsewhere on the board
unnamed: C1103.1, U1106.3 (REGCAP)
unnamed: C1105.1, U1106.9 (REFCAP)
unnamed: C1111.1, R1105.1, R1109.2
unnamed: C1111.2, R1106.1, R1110.2
unnamed: C1112.1, R1107.1, R1111.2
unnamed: C1112.2, R1108.1, R1112.2
unnamed: C1121.1, R1115.2, U1108.8 (+IN1)
unnamed: C1122.1, R1116.2, U1109.8 (+IN1)
unnamed: C1133.1, Q1101.1 (B), R1135.2
unnamed: C1134.1, Q1102.1 (B), R1136.2
unnamed: C1135.1, R1137.1, U1112.4 (VIN)
unnamed: C1136.1, R1138.1, U1113.4 (VIN)
unnamed: C1137.1, Q1103.1 (B), R1141.2
unnamed: C1138.1, Q1104.1 (B), R1142.2
unnamed: C1139.1, R1113.1, U1108.2 (+IN2)
unnamed: C1140.1, R1114.1, U1109.2 (+IN2)
unnamed: R1101.1, U1106.13 (SDOA)
unnamed: R1102.1, U1106.14 (SDOB/~ALARM)
unnamed: R1103.1, R1104.1, U1107.5 (+)
unnamed: R1105.2, U1106.6 (AINB+)
unnamed: R1106.2, U1106.5 (AINB-)
unnamed: R1107.2, U1106.8 (AINA+)
unnamed: R1108.2, U1106.7 (AINA-)
unnamed: R1109.1, U1108.1 (-IN1), U1108.4 (OUT1)
unnamed: R1110.1, U1108.5 (OUT2)
unnamed: R1111.1, U1109.1 (-IN1), U1109.4 (OUT1)
unnamed: R1112.1, U1109.5 (OUT2)
unnamed: R1115.1, R1117.2, U1105.7
unnamed: R1116.1, R1118.2, U1105.1
unnamed: R1117.1, R1119.1, U1105.6 (-)
unnamed: R1118.1, R1120.1, U1105.2 (-)
unnamed: R1121.2, R1122.1, R1125.2, U1105.5 (+)
unnamed: R1123.2, R1124.1, R1126.2, U1105.3 (+)
unnamed: R1125.1, U1112.7 (VO)
unnamed: R1126.1, U1113.7 (VO)
unnamed: R1127.2, R1129.1, U1110.3 (+)
unnamed: R1128.2, R1130.1, U1111.3 (+)
unnamed: R1137.2, U1102.1
unnamed: R1138.2, U1101.1
unnamed: R1139.2, U1102.2
unnamed: R1140.2, U1101.2
unnamed: U1110.2 (-), U1110.6, U1112.3 (TR)
unnamed: U1111.2 (-), U1111.6, U1113.3 (TR)

Notes on the sheet:
Place reistors close to the ADC chip.

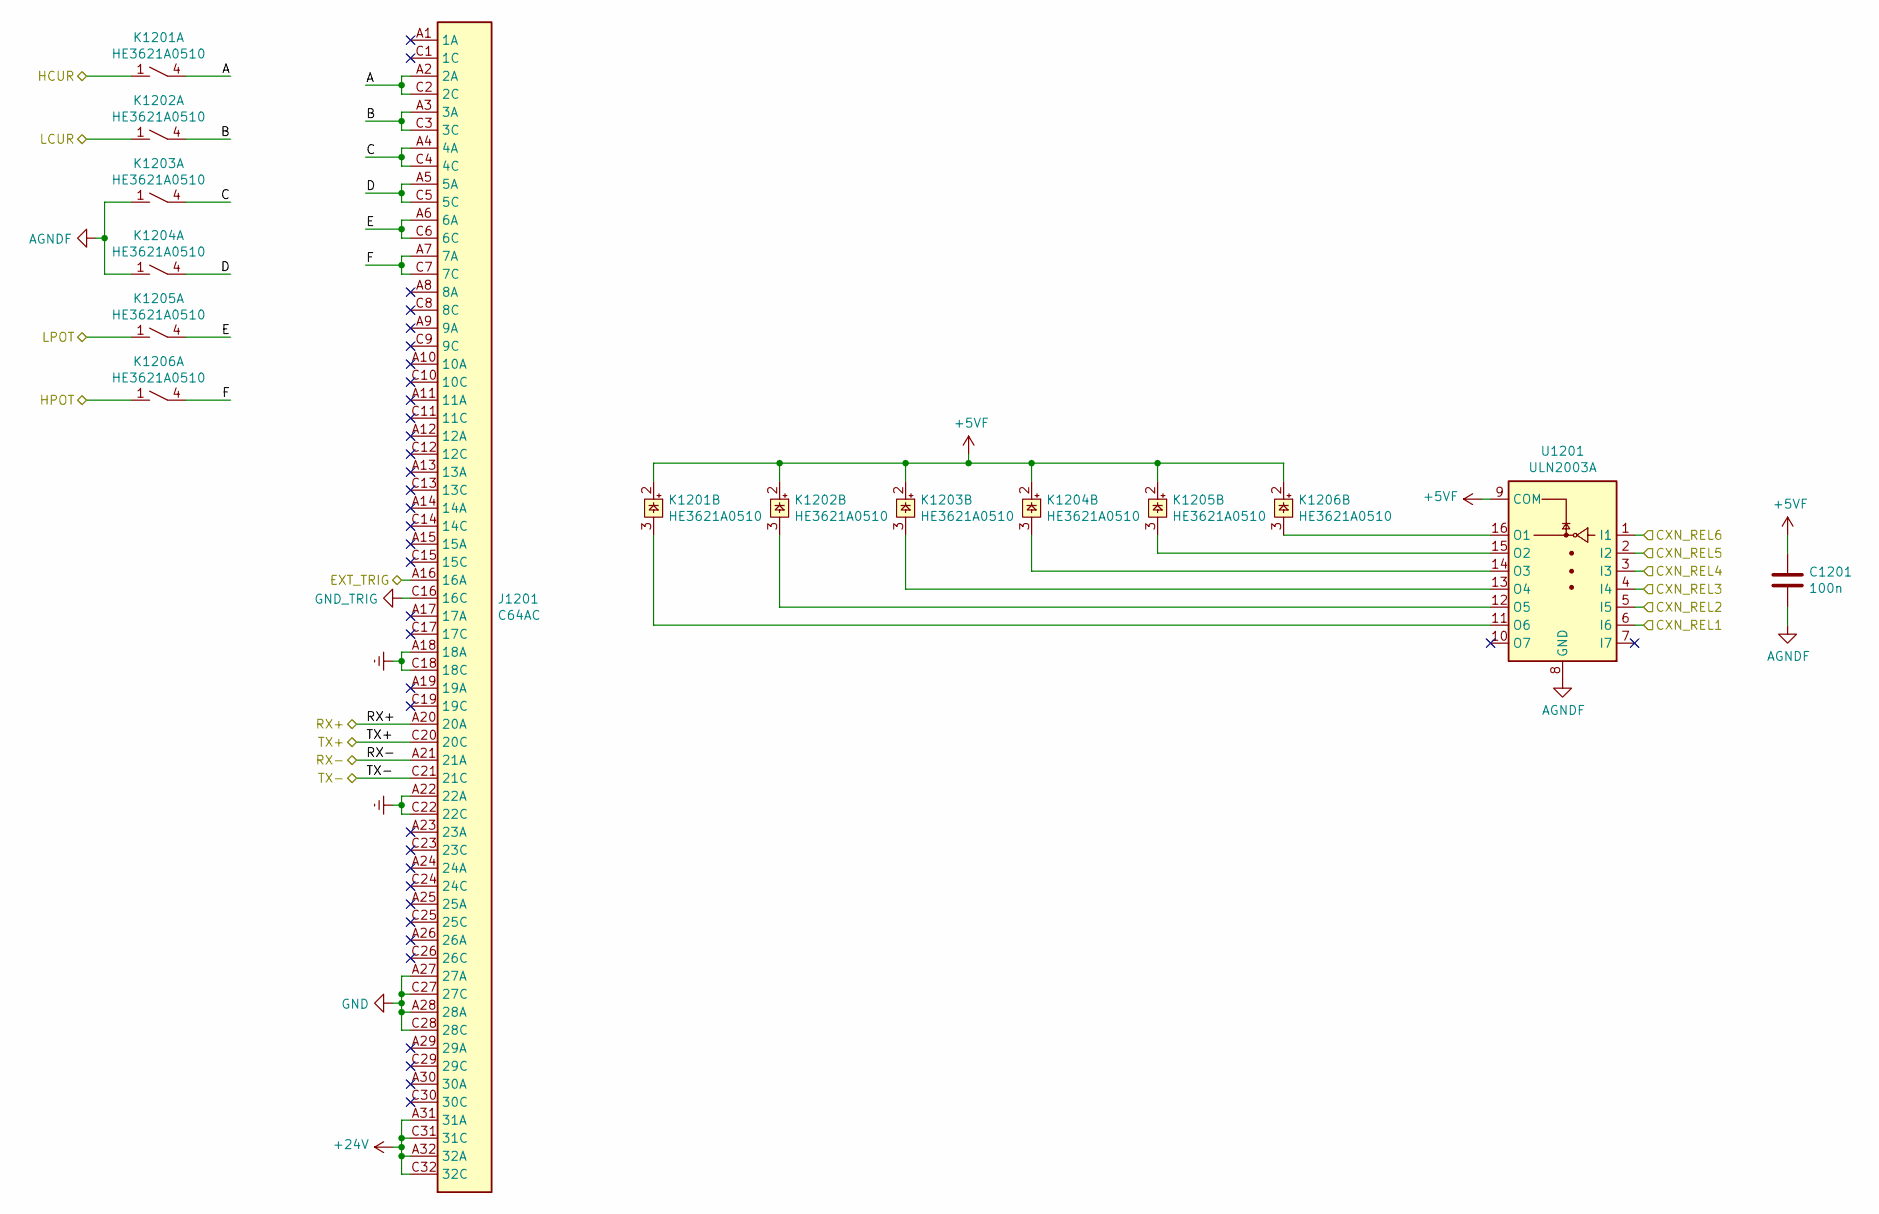
[picture p11: schematic Connector.sch]

Parts:
C1201: 100n; C_0603_1608Metric_Pad1.05x0.95mm_HandSolder
J1201: C64AC; Socket_DIN41612-CaseC1-AC-Male-64Pin-2rows
K1201, K1202, K1203, K1204, K1205, K1206: HE3621A0510; HE360_x-5050462-8
U1201: ULN2003A; TSSOP-16_4.4x5mm_P0.65mm

Connections:
+5VF: C1201.1, K1201.2, K1202.2, K1203.2, K1204.2, K1205.2, K1206.2, U1201.9 (COM); also elsewhere on the board
+24V: J1201.A31 (31A), J1201.A32 (32A), J1201.C31 (31C), J1201.C32 (32C); also elsewhere on the board
/Connector/A: J1201.A2 (2A), J1201.C2 (2C), K1201.4
/Connector/B: J1201.A3 (3A), J1201.C3 (3C), K1202.4
/Connector/C: J1201.A4 (4A), J1201.C4 (4C), K1203.4
/Connector/CXN_REL1: U1201.6 (I6); also elsewhere on the board
/Connector/CXN_REL2: U1201.5 (I5); also elsewhere on the board
/Connector/CXN_REL3: U1201.4 (I4); also elsewhere on the board
/Connector/CXN_REL4: U1201.3 (I3); also elsewhere on the board
/Connector/CXN_REL5: U1201.2 (I2); also elsewhere on the board
/Connector/CXN_REL6: U1201.1 (I1); also elsewhere on the board
/Connector/D: J1201.A5 (5A), J1201.C5 (5C), K1204.4
/Connector/E: J1201.A6 (6A), J1201.C6 (6C), K1205.4
/Connector/EXT_TRIG: J1201.A16 (16A); also elsewhere on the board
/Connector/F: J1201.A7 (7A), J1201.C7 (7C), K1206.4
/Connector/HCUR: K1201.1; also elsewhere on the board
/Connector/HPOT: K1206.1; also elsewhere on the board
/Connector/LCUR: K1202.1; also elsewhere on the board
/Connector/LPOT: K1205.1; also elsewhere on the board
/Connector/RX+: J1201.A20 (20A); also elsewhere on the board
/Connector/RX-: J1201.A21 (21A); also elsewhere on the board
/Connector/TX+: J1201.C20 (20C); also elsewhere on the board
/Connector/TX-: J1201.C21 (21C); also elsewhere on the board
AGNDF: C1201.2, J1201.A27 (27A), J1201.A28 (28A), J1201.C27 (27C), J1201.C28 (28C), K1203.1, K1204.1, U1201.8 (GND); also elsewhere on the board
Earth: J1201.A18 (18A), J1201.A22 (22A), J1201.C18 (18C), J1201.C22 (22C); also elsewhere on the board
GND_TRIG: J1201.C16 (16C); also elsewhere on the board
unnamed: K1201.3, U1201.11 (O6)
unnamed: K1202.3, U1201.12 (O5)
unnamed: K1203.3, U1201.13 (O4)
unnamed: K1204.3, U1201.14 (O3)
unnamed: K1205.3, U1201.15 (O2)
unnamed: K1206.3, U1201.16 (O1)
