BehrensG/ETH1CLCR1/hardware/project/ETH1CLCR1/ETH1CLCR1.kicad_pcb

## KiCad design hardware/project/ETH1CLCR1/ETH1CLCR1.kicad_pcb (continued)

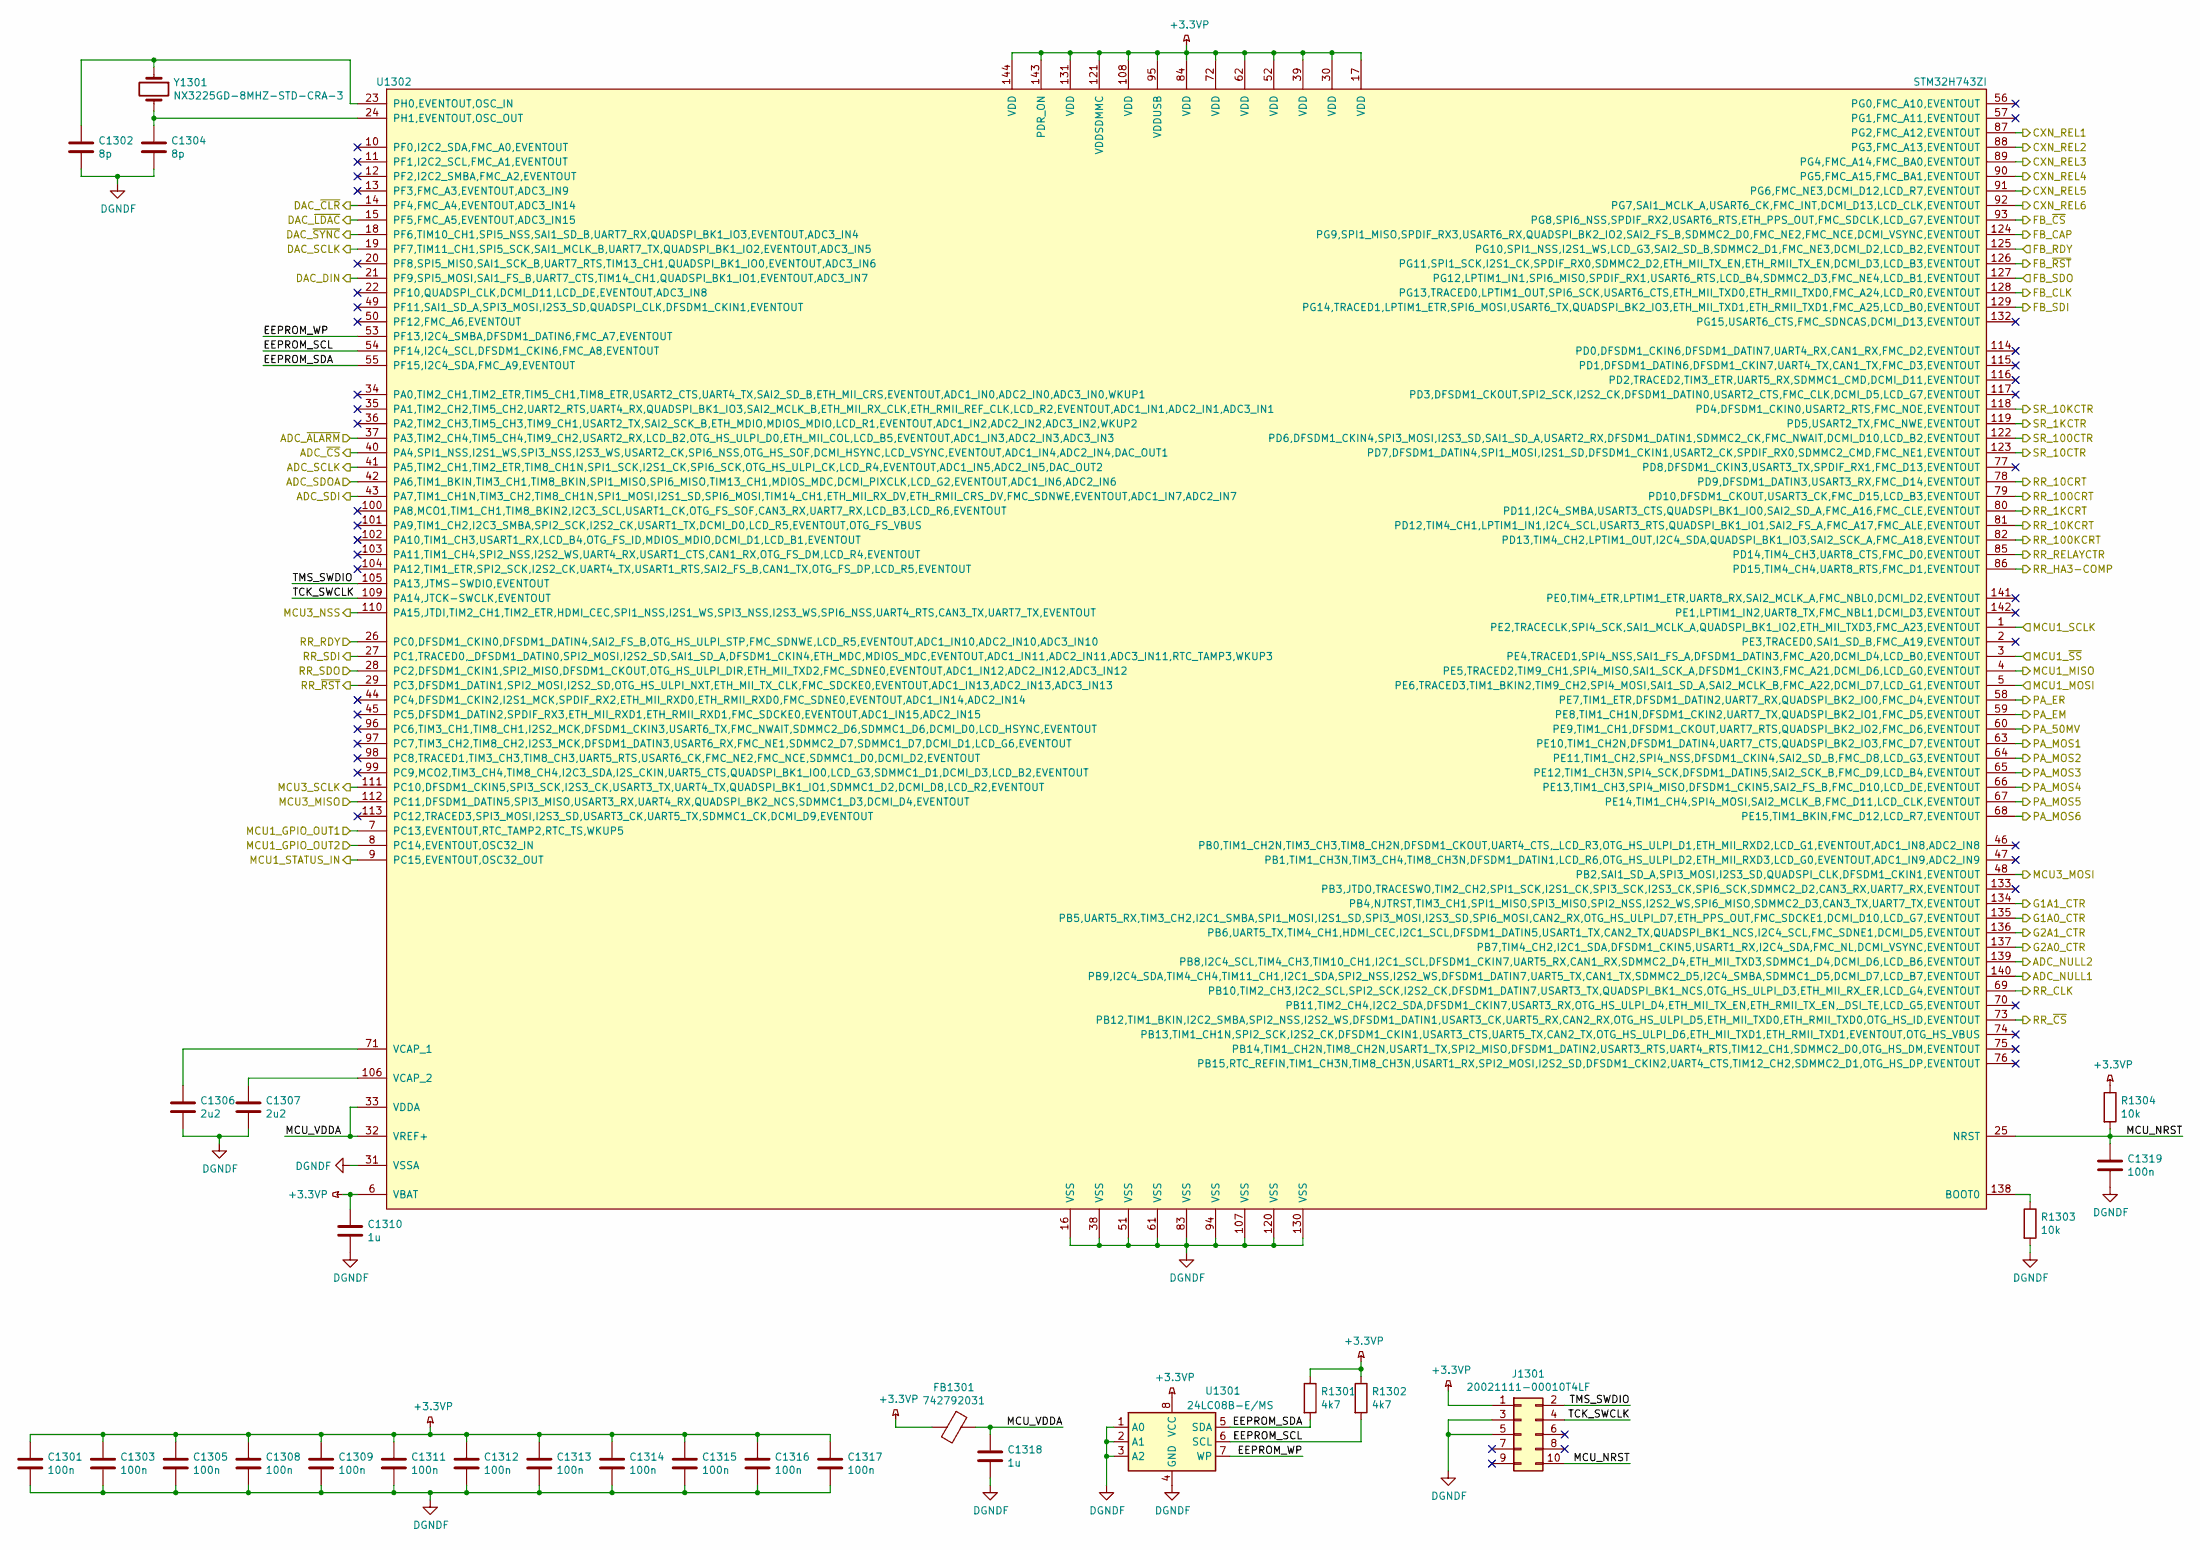
[picture p12: schematic MCU2.sch]

Parts:
C1301, C1303, C1305, C1308, C1309, C1311, C1312, C1313, C1314, C1315, C1316, C1317, C1319: 100n; C_0603_1608Metric_Pad1.05x0.95mm_HandSolder
C1302, C1304: 8p; C_0603_1608Metric_Pad1.05x0.95mm_HandSolder
C1306, C1307: 2u2; C_0805_2012Metric_Pad1.15x1.40mm_HandSolder
C1310, C1318: 1u; C_0603_1608Metric_Pad1.05x0.95mm_HandSolder
FB1301: 742792031; L_0805_2012Metric_Pad1.15x1.40mm_HandSolder
J1301: 20021111-00010T4LF; PinHeader_2x05_P1.27mm_Vertical
R1301, R1302: 4k7; R_0603_1608Metric_Pad1.05x0.95mm_HandSolder
R1303, R1304: 10k; R_0603_1608Metric_Pad1.05x0.95mm_HandSolder
U1301: 24LC08B-E/MS; MSOP-8_3x3mm_P0.65mm
U1302: STM32H743ZI; TQFP-144_20x20mm_P0.5mm
Y1301: NX3225GD-8MHZ-STD-CRA-3; NX3225GD

Connections:
+3.3VP: C1301.1, C1303.1, C1305.1, C1308.1, C1309.1, C1310.1, C1311.1, C1312.1, C1313.1, C1314.1, C1315.1, C1316.1, C1317.1, FB1301.2, J1301.1, R1301.1, R1302.1, R1304.1, U1301.8 (VCC), U1302.6 (VBAT), U1302.17 (VDD), U1302.30 (VDD), U1302.39 (VDD), U1302.52 (VDD), U1302.62 (VDD), U1302.72 (VDD), U1302.84 (VDD), U1302.95 (VDDUSB), U1302.108 (VDD), U1302.121 (VDDSDMMC), U1302.131 (VDD), U1302.143 (PDR_ON), U1302.144 (VDD); also elsewhere on the board
/ADC/ADC_NULL1: U1302.140 (PB9,I2C4_SDA,TIM4_CH4,TIM11_CH1,I2C1_SD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); also elsewhere on the board
/ADC/ADC_NULL2: U1302.139 (PB8,I2C4_SCL,TIM4_CH3,TIM10_CH1,I2C1_SC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); also elsewhere on the board
/ADC/ADC_SCLK: U1302.41 (PA5,TIM2_CH1,TIM2_ETR,TIM8_CH1N,SPI1_SC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); also elsewhere on the board
/ADC/ADC_SDI: U1302.43 (PA7,TIM1_CH1N,TIM3_CH2,TIM8_CH1N,SPI1_M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); also elsewhere on the board
/ADC/ADC_SDOA: U1302.42 (PA6,TIM1_BKIN,TIM3_CH1,TIM8_BKIN,SPI1_M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); also elsewhere on the board
/ADC/ADC_~ALARM: U1302.37 (PA3,TIM2_CH4,TIM5_CH4,TIM9_CH2,USART2_R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); also elsewhere on the board
/ADC/ADC_~CS: U1302.40 (PA4,SPI1_NSS,I2S1_WS,SPI3_NSS,I2S3_WS,U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); also elsewhere on the board
/ADC/G1A0_CTR: U1302.135 (PB5,UART5_RX,TIM3_CH2,I2C1_SMBA,SPI1_MO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); also elsewhere on the board
/ADC/G1A1_CTR: U1302.134 (PB4,NJTRST,TIM3_CH1,SPI1_MISO,SPI3_MISO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); also elsewhere on the board
/ADC/G2A0_CTR: U1302.137 (PB7,TIM4_CH2,I2C1_SDA,DFSDM1_CKIN5,USAR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); also elsewhere on the board
/ADC/G2A1_CTR: U1302.136 (PB6,UART5_TX,TIM4_CH1,HDMI_CEC,I2C1_SCL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); also elsewhere on the board
/Connector/CXN_REL1: U1302.87 (PG2,FMC_A12,EVENTOUT); also elsewhere on the board
/Connector/CXN_REL2: U1302.88 (PG3,FMC_A13,EVENTOUT); also elsewhere on the board
/Connector/CXN_REL3: U1302.89 (PG4,FMC_A14,FMC_BA0,EVENTOUT); also elsewhere on the board
/Connector/CXN_REL4: U1302.90 (PG5,FMC_A15,FMC_BA1,EVENTOUT); also elsewhere on the board
/Connector/CXN_REL5: U1302.91 (PG6,FMC_NE3,DCMI_D12,LCD_R7,EVENTOUT); also elsewhere on the board
/Connector/CXN_REL6: U1302.92 (PG7,SAI1_MCLK_A,USART6_CK,FMC_INT,DCMI_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); also elsewhere on the board
/DAC/DAC_DIN: U1302.21 (PF9,SPI5_MOSI,SAI1_FS_B,UART7_CTS,TIM14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); also elsewhere on the board
/DAC/DAC_SCLK: U1302.19 (PF7,TIM11_CH1,SPI5_SCK,SAI1_MCLK_B,UART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); also elsewhere on the board
/DAC/DAC_~CLR: U1302.14 (PF4,FMC_A4,EVENTOUT,ADC3_IN14); also elsewhere on the board
/DAC/DAC_~LDAC: U1302.15 (PF5,FMC_A5,EVENTOUT,ADC3_IN15); also elsewhere on the board
/DAC/DAC_~SYNC: U1302.18 (PF6,TIM10_CH1,SPI5_NSS,SAI1_SD_B,UART7_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); also elsewhere on the board
/FGEN Buffer + Source resistor/FB_CAP: U1302.124 (PG9,SPI1_MISO,SPDIF_RX3,USART6_RX,QUADS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); also elsewhere on the board
/FGEN Buffer + Source resistor/FB_CLK: U1302.128 (PG13,TRACED0,LPTIM1_OUT,SPI6_SCK,USART6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); also elsewhere on the board
/FGEN Buffer + Source resistor/FB_RDY: U1302.125 (PG10,SPI1_NSS,I2S1_WS,LCD_G3,SAI2_SD_B,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); also elsewhere on the board
/FGEN Buffer + Source resistor/FB_SDI: U1302.129 (PG14,TRACED1,LPTIM1_ETR,SPI6_MOSI,USART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); also elsewhere on the board
/FGEN Buffer + Source resistor/FB_SDO: U1302.127 (PG12,LPTIM1_IN1,SPI6_MISO,SPDIF_RX1,USA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); also elsewhere on the board
/FGEN Buffer + Source resistor/FB_~CS: U1302.93 (PG8,SPI6_NSS,SPDIF_RX2,USART6_RTS,ETH_P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); also elsewhere on the board
/FGEN Buffer + Source resistor/FB_~RST: U1302.126 (PG11,SPI1_SCK,I2S1_CK,SPDIF_RX0,SDMMC2_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); also elsewhere on the board
/FGEN Buffer + Source resistor/SR_1KCTR: U1302.119 (PD5,USART2_TX,FMC_NWE,EVENTOUT); also elsewhere on the board
/FGEN Buffer + Source resistor/SR_10CTR: U1302.123 (PD7,DFSDM1_DATIN4,SPI1_MOSI,I2S1_SD,DFS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); also elsewhere on the board
/FGEN Buffer + Source resistor/SR_10KCTR: U1302.118 (PD4,DFSDM1_CKIN0,USART2_RTS,FMC_NOE,EVE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); also elsewhere on the board
/FGEN Buffer + Source resistor/SR_100CTR: U1302.122 (PD6,DFSDM1_CKIN4,SPI3_MOSI,I2S3_SD,SAI1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); also elsewhere on the board
/MCU1/MCU1_GPIO_OUT1: U1302.7 (PC13,EVENTOUT,RTC_TAMP2,RTC_TS,WKUP5); also elsewhere on the board
/MCU1/MCU1_GPIO_OUT2: U1302.8 (PC14,EVENTOUT,OSC32_IN); also elsewhere on the board
/MCU1/MCU1_MCLK: U1302.1 (PE2,TRACECLK,SPI4_SCK,SAI1_MCLK_A,QUADS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); also elsewhere on the board
/MCU1/MCU1_MISO: U1302.4 (PE5,TRACED2,TIM9_CH1,SPI4_MISO,SAI1_SCK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); also elsewhere on the board
/MCU1/MCU1_MOSI: U1302.5 (PE6,TRACED3,TIM1_BKIN2,TIM9_CH2,SPI4_MO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); also elsewhere on the board
/MCU1/MCU1_STATUS_IN: U1302.9 (PC15,EVENTOUT,OSC32_OUT); also elsewhere on the board
/MCU1/MCU1_~SS: U1302.3 (PE4,TRACED1,SPI4_NSS,SAI1_FS_A,DFSDM1_D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); also elsewhere on the board
/MCU2/EEPROM_SCL: R1302.2, U1301.6 (SCL), U1302.54 (PF14,I2C4_SCL,DFSDM1_CKIN6,FMC_A8,EVENT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)
/MCU2/EEPROM_SDA: R1301.2, U1301.5 (SDA), U1302.55 (PF15,I2C4_SDA,FMC_A9,EVENTOUT)
/MCU2/EEPROM_WP: U1301.7 (WP), U1302.53 (PF13,I2C4_SMBA,DFSDM1_DATIN6,FMC_A7,EVE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)
/MCU2/MCU3_MISO: U1302.112 (PC11,DFSDM1_DATIN5,SPI3_MISO,USART3_RX,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); also elsewhere on the board
/MCU2/MCU3_MOSI: U1302.48 (PB2,SAI1_SD_A,SPI3_MOSI,I2S3_SD,QUADSPI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); also elsewhere on the board
/MCU2/MCU3_NSS: U1302.110 (PA15,JTDI,TIM2_CH1,TIM2_ETR,HDMI_CEC,SP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); also elsewhere on the board
/MCU2/MCU3_SCLK: U1302.111 (PC10,DFSDM1_CKIN5,SPI3_SCK,I2S3_CK,USAR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); also elsewhere on the board
/MCU2/MCU_NRST: C1319.1, J1301.10, R1304.2, U1302.25 (NRST)
/MCU2/MCU_VDDA: C1318.1, FB1301.1, U1302.32 (VREF+), U1302.33 (VDDA)
/MCU2/PA_50MV: U1302.60 (PE9,TIM1_CH1,DFSDM1_CKOUT,UART7_RTS,QUA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); also elsewhere on the board
/MCU2/PA_EM: U1302.59 (PE8,TIM1_CH1N,DFSDM1_CKIN2,UART7_TX,QUA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); also elsewhere on the board
/MCU2/PA_ER: U1302.58 (PE7,TIM1_ETR,DFSDM1_DATIN2,UART7_RX,QUA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); also elsewhere on the board
/MCU2/PA_MOS1: U1302.63 (PE10,TIM1_CH2N,DFSDM1_DATIN4,UART7_CTS,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); also elsewhere on the board
/MCU2/PA_MOS2: U1302.64 (PE11,TIM1_CH2,SPI4_NSS,DFSDM1_CKIN4,SAI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); also elsewhere on the board
/MCU2/PA_MOS3: U1302.65 (PE12,TIM1_CH3N,SPI4_SCK,DFSDM1_DATIN5,S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); also elsewhere on the board
/MCU2/PA_MOS4: U1302.66 (PE13,TIM1_CH3,SPI4_MISO,DFSDM1_CKIN5,SA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); also elsewhere on the board
/MCU2/PA_MOS5: U1302.67 (PE14,TIM1_CH4,SPI4_MOSI,SAI2_MCLK_B,FMC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); also elsewhere on the board
/MCU2/PA_MOS6: U1302.68 (PE15,TIM1_BKIN,FMC_D12,LCD_R7,EVENTOUT); also elsewhere on the board
/MCU2/RR_1KCRT: U1302.80 (PD11,I2C4_SMBA,USART3_CTS,QUADSPI_BK1_I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); also elsewhere on the board
/MCU2/RR_10CRT: U1302.78 (PD9,DFSDM1_DATIN3,USART3_RX,FMC_D14,EVE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); also elsewhere on the board
/MCU2/RR_10KCRT: U1302.81 (PD12,TIM4_CH1,LPTIM1_IN1,I2C4_SCL,USART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); also elsewhere on the board
/MCU2/RR_100CRT: U1302.79 (PD10,DFSDM1_CKOUT,USART3_CK,FMC_D15,LCD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); also elsewhere on the board
/MCU2/RR_100KCRT: U1302.82 (PD13,TIM4_CH2,LPTIM1_OUT,I2C4_SDA,QUADS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); also elsewhere on the board
/MCU2/RR_CLK: U1302.69 (PB10,TIM2_CH3,I2C2_SCL,SPI2_SCK,I2S2_CK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); also elsewhere on the board
/MCU2/RR_HA3-COMP: U1302.86 (PD15,TIM4_CH4,UART8_RTS,FMC_D1,EVENTOUT); also elsewhere on the board
/MCU2/RR_RDY: U1302.26 (PC0,DFSDM1_CKIN0,DFSDM1_DATIN4,SAI2_FS_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); also elsewhere on the board
/MCU2/RR_RELAYCTR: U1302.85 (PD14,TIM4_CH3,UART8_CTS,FMC_D0,EVENTOUT); also elsewhere on the board
/MCU2/RR_SDI: U1302.27 (PC1,TRACED0,_DFSDM1_DATIN0,SPI2_MOSI,I2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); also elsewhere on the board
/MCU2/RR_SDO: U1302.28 (PC2,DFSDM1_CKIN1,SPI2_MISO,DFSDM1_CKOUT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); also elsewhere on the board
/MCU2/RR_~CS: U1302.73 (PB12,TIM1_BKIN,I2C2_SMBA,SPI2_NSS,I2S2_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); also elsewhere on the board
/MCU2/RR_~RST: U1302.29 (PC3,DFSDM1_DATIN1,SPI2_MOSI,I2S2_SD,OTG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); also elsewhere on the board
/MCU2/TCK_SWCLK: J1301.4, U1302.109 (PA14,JTCK-SWCLK,EVENTOUT)
/MCU2/TMS_SWDIO: J1301.2, U1302.105 (PA13,JTMS-SWDIO,EVENTOUT)
AGNDF: C1301.2, C1302.2, C1303.2, C1304.2, C1305.2, C1306.2, C1307.2, C1308.2, C1309.2, C1310.2, C1311.2, C1312.2, C1313.2, C1314.2, C1315.2, C1316.2, C1317.2, C1318.2, C1319.2, J1301.3, J1301.5, R1303.2, U1301.1 (A0), U1301.2 (A1), U1301.3 (A2), U1301.4 (GND), U1302.16 (VSS), U1302.31 (VSSA), U1302.38 (VSS), U1302.51 (VSS), U1302.61 (VSS), U1302.83 (VSS), U1302.94 (VSS), U1302.107 (VSS), U1302.120 (VSS), U1302.130 (VSS); also elsewhere on the board
unnamed: C1302.1, U1302.23 (PH0,EVENTOUT,OSC_IN), Y1301.1
unnamed: C1304.1, U1302.24 (PH1,EVENTOUT,OSC_OUT), Y1301.2
unnamed: C1306.1, U1302.71 (VCAP_1)
unnamed: C1307.1, U1302.106 (VCAP_2)
unnamed: R1303.1, U1302.138 (BOOT0)

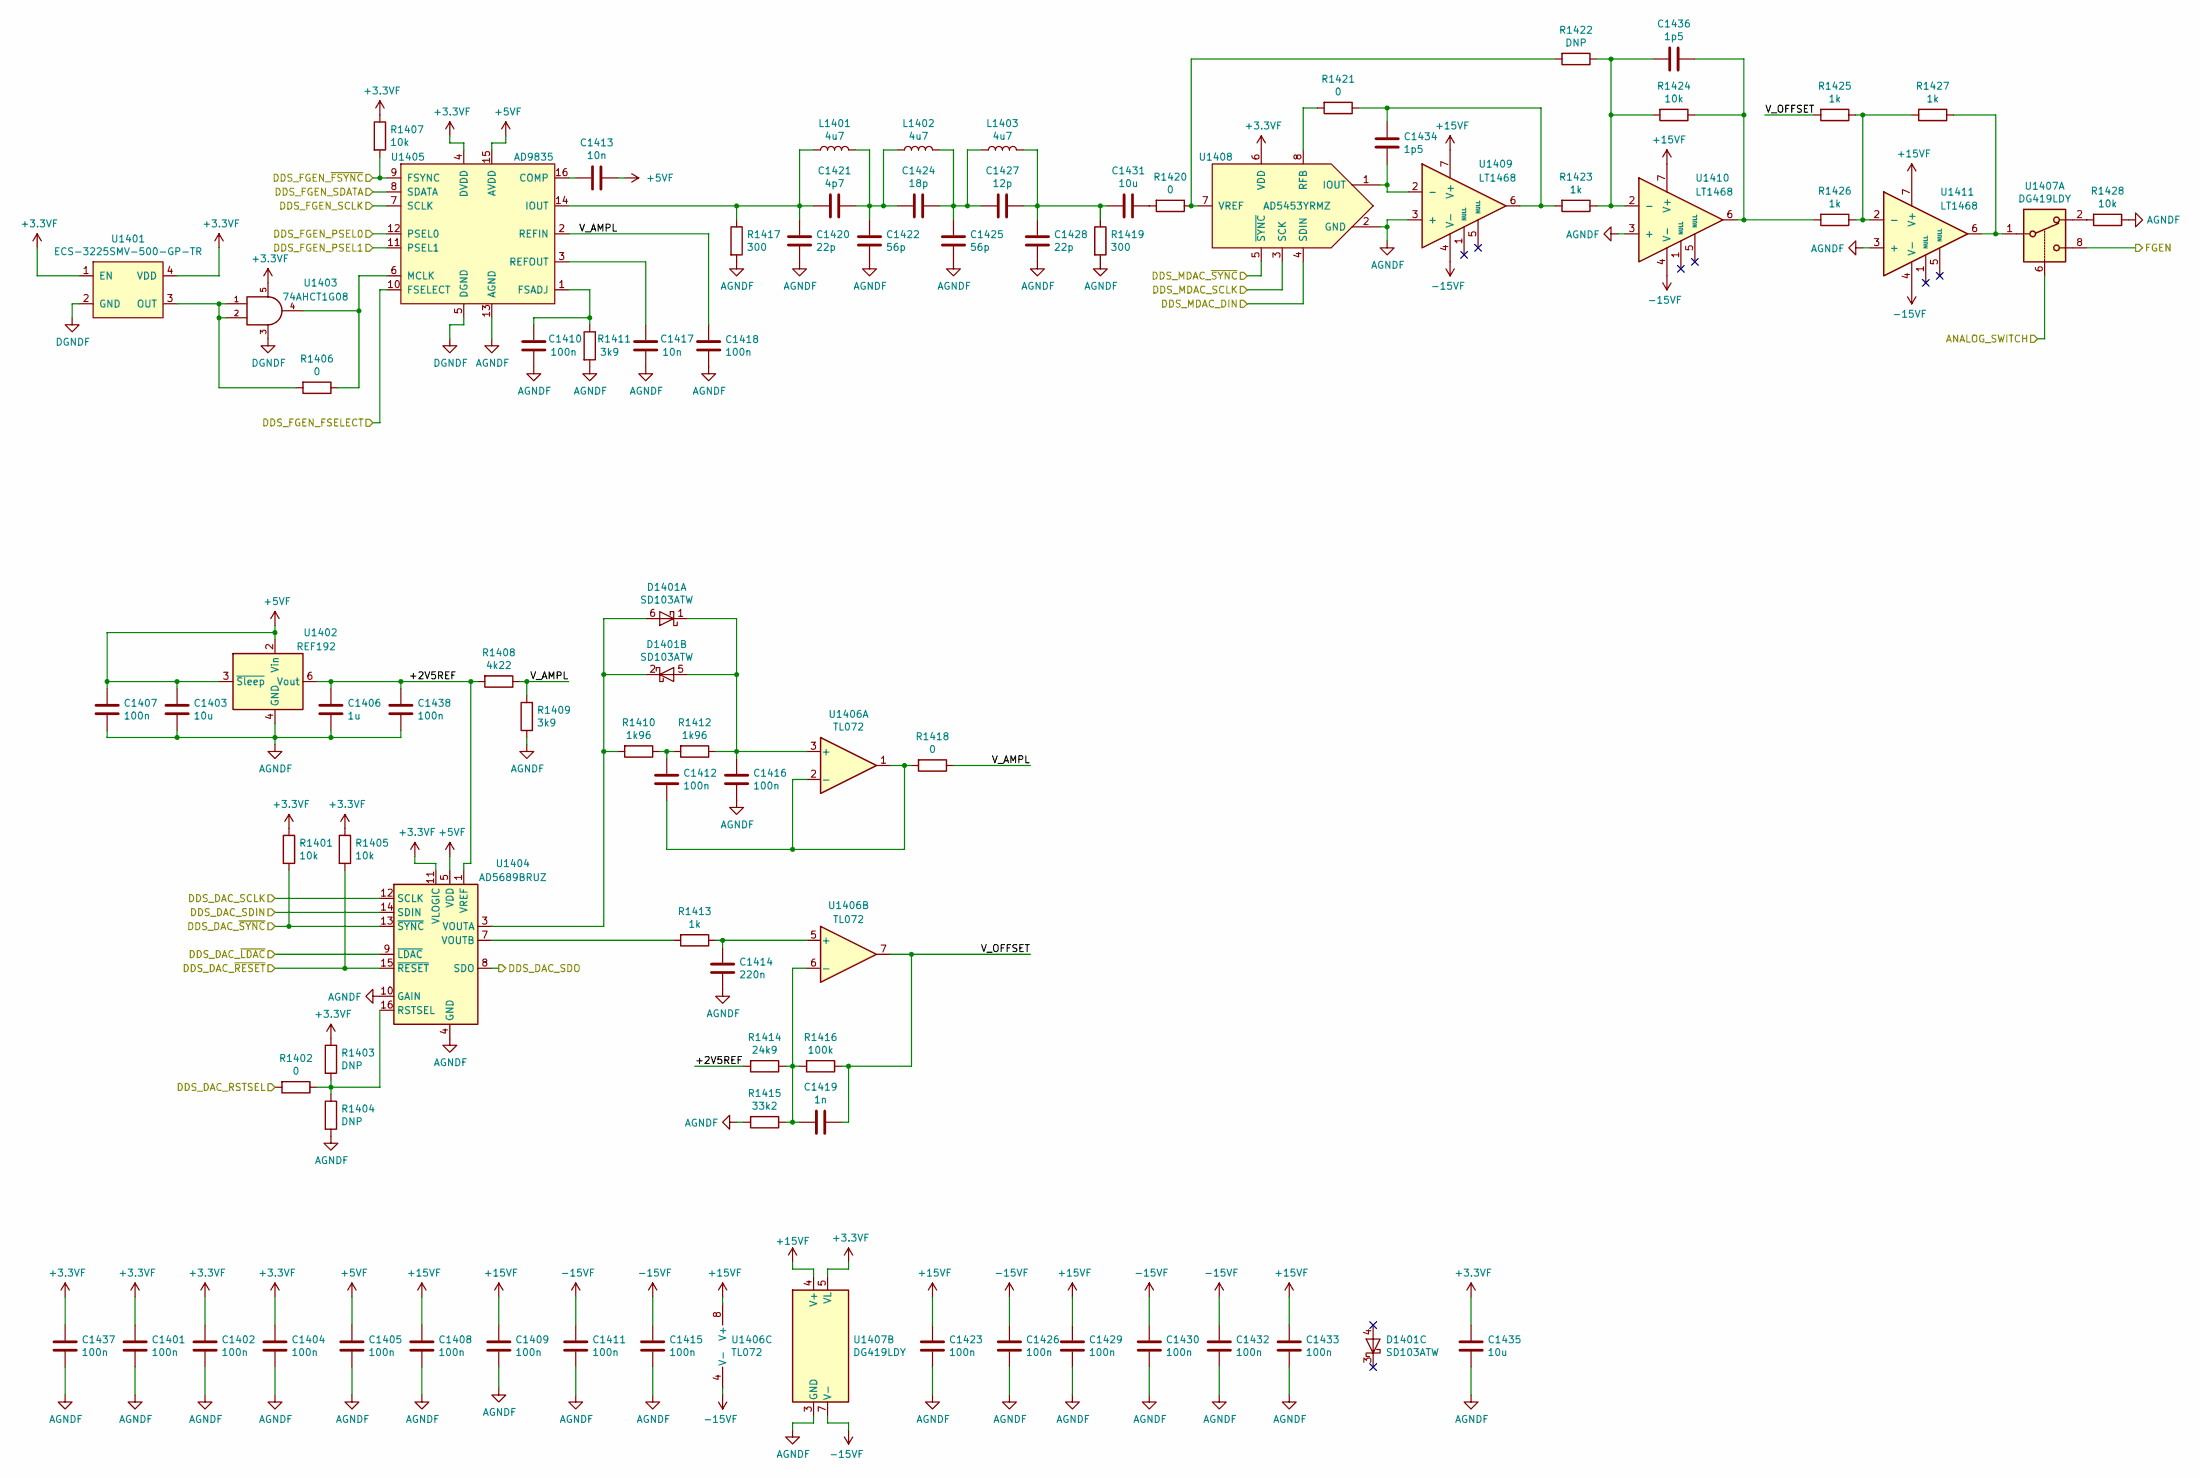
[picture p13: schematic FGEN.sch, Function generator]

Parts:
C1401, C1402, C1404, C1405, C1407, C1408, C1409, C1410, C1411, C1412, C1415, C1416, C1418, C1423, C1426, C1429, C1430, C1432, C1433, C1437, C1438: 100n; C_0603_1608Metric_Pad1.05x0.95mm_HandSolder
C1403, C1435: 10u; C_0805_2012Metric_Pad1.15x1.40mm_HandSolder
C1406: 1u; C_0603_1608Metric_Pad1.05x0.95mm_HandSolder
C1413, C1417: 10n; C_0603_1608Metric_Pad1.05x0.95mm_HandSolder
C1414: 220n; C_0603_1608Metric_Pad1.05x0.95mm_HandSolder
C1419: 1n; C_0603_1608Metric_Pad1.05x0.95mm_HandSolder
C1420, C1428: 22p; C_0603_1608Metric_Pad1.05x0.95mm_HandSolder
C1421: 4p7; C_0603_1608Metric_Pad1.05x0.95mm_HandSolder
C1422, C1425: 56p; C_0603_1608Metric_Pad1.05x0.95mm_HandSolder
C1424: 18p; C_0603_1608Metric_Pad1.05x0.95mm_HandSolder
C1427: 12p; C_0603_1608Metric_Pad1.05x0.95mm_HandSolder
C1431: 10u; C_1206_3216Metric_Pad1.42x1.75mm_HandSolder
C1434, C1436: 1p5; C_0603_1608Metric_Pad1.05x0.95mm_HandSolder
D1401: SD103ATW; SOT-363_SC-70-6
L1401, L1402, L1403: 4u7; L_0603_1608Metric_Pad1.05x0.95mm_HandSolder
R1401, R1405, R1407, R1424, R1428: 10k; R_0603_1608Metric_Pad1.05x0.95mm_HandSolder
R1402, R1406, R1418, R1420, R1421: 0; R_0603_1608Metric_Pad1.05x0.95mm_HandSolder
R1403, R1404, R1422: DNP; R_0603_1608Metric_Pad1.05x0.95mm_HandSolder
R1408: 4k22; R_0603_1608Metric_Pad1.05x0.95mm_HandSolder
R1409, R1411: 3k9; R_0603_1608Metric_Pad1.05x0.95mm_HandSolder
R1410, R1412: 1k96; R_0603_1608Metric_Pad1.05x0.95mm_HandSolder
R1413, R1423, R1425, R1426, R1427: 1k; R_0603_1608Metric_Pad1.05x0.95mm_HandSolder
R1414: 24k9; R_0603_1608Metric_Pad1.05x0.95mm_HandSolder
R1415: 33k2; R_0603_1608Metric_Pad1.05x0.95mm_HandSolder
R1416: 100k; R_0603_1608Metric_Pad1.05x0.95mm_HandSolder
R1417, R1419: 300; R_0603_1608Metric_Pad1.05x0.95mm_HandSolder
U1401: ECS-3225SMV-500-GP-TR; ECS
U1402: REF192; SSOP-8_3.9x5.05mm_P1.27mm
U1403: 74AHCT1G08; SOT-353_SC-70-5
U1404: AD5689BRUZ; TSSOP-16_4.4x5mm_P0.65mm
U1405: AD9835; TSSOP-16_4.4x5mm_P0.65mm
U1406: TL072; SOIC-8_3.9x4.9mm_P1.27mm
U1407: DG419LDY; SOIC-8_3.9x4.9mm_P1.27mm
U1408: AD5453YRMZ; MSOP-8_3x3mm_P0.65mm
U1409, U1410, U1411: LT1468; SSOP-8_3.9x5.05mm_P1.27mm

Connections:
+3.3VF: C1401.1, C1402.1, C1404.1, C1435.1, C1437.1, R1401.1, R1403.1, R1405.1, R1407.1, U1401.1 (EN), U1401.4 (VDD), U1403.5, U1404.11 (VLOGIC), U1405.4 (DVDD), U1407.5 (VL), U1408.6 (VDD); also elsewhere on the board
+5VF: C1403.1, C1405.1, C1407.1, C1413.1, U1402.2 (Vin), U1402.3 (~Sleep~), U1404.5 (VDD), U1405.15 (AVDD); also elsewhere on the board
+15VF: C1408.1, C1409.1, C1423.1, C1429.1, C1433.1, U1406.8 (V+), U1407.4 (V+), U1409.7 (V+), U1410.7 (V+), U1411.7 (V+); also elsewhere on the board
-15VF: C1411.1, C1415.1, C1426.1, C1430.1, C1432.1, U1406.4 (V-), U1407.7 (V-), U1409.4 (V-), U1410.4 (V-), U1411.4 (V-); also elsewhere on the board
/FGEN Buffer + Source resistor/FGEN: U1407.8; also elsewhere on the board
/FGEN/+2V5REF: C1406.1, C1438.1, R1408.2, R1414.2, U1402.6 (Vout), U1404.1 (VREF)
/FGEN/ANALOG_SWITCH: U1407.6; also elsewhere on the board
/FGEN/DDS_DAC_RSTSEL: R1402.2; also elsewhere on the board
/FGEN/DDS_DAC_SCLK: U1404.12 (SCLK); also elsewhere on the board
/FGEN/DDS_DAC_SDIN: U1404.14 (SDIN); also elsewhere on the board
/FGEN/DDS_DAC_SDO: U1404.8 (SDO); also elsewhere on the board
/FGEN/DDS_DAC_~LDAC: U1404.9 (~LDAC); also elsewhere on the board
/FGEN/DDS_DAC_~RESET: R1405.2, U1404.15 (~RESET); also elsewhere on the board
/FGEN/DDS_DAC_~SYNC: R1401.2, U1404.13 (~SYNC); also elsewhere on the board
/FGEN/DDS_FGEN_FSELECT: U1405.10 (FSELECT); also elsewhere on the board
/FGEN/DDS_FGEN_PSEL0: U1405.12 (PSEL0); also elsewhere on the board
/FGEN/DDS_FGEN_PSEL1: U1405.11 (PSEL1); also elsewhere on the board
/FGEN/DDS_FGEN_SCLK: U1405.7 (SCLK); also elsewhere on the board
/FGEN/DDS_FGEN_SDATA: U1405.8 (SDATA); also elsewhere on the board
/FGEN/DDS_FGEN_~FSYNC: R1407.2, U1405.9 (FSYNC); also elsewhere on the board
/FGEN/DDS_MDAC_DIN: U1408.4 (SDIN); also elsewhere on the board
/FGEN/DDS_MDAC_SCLK: U1408.3 (SCK); also elsewhere on the board
/FGEN/DDS_MDAC_~SYNC: U1408.5 (~SYNC); also elsewhere on the board
/FGEN/V_AMPL: C1418.1, R1408.1, R1409.2, R1418.1, U1405.2 (REFIN)
/FGEN/V_OFFSET: C1419.1, R1416.1, R1425.2, U1406.7
AGNDF: C1401.2, C1402.2, C1403.2, C1404.2, C1405.2, C1406.2, C1407.2, C1408.2, C1409.2, C1410.2, C1411.2, C1414.2, C1415.2, C1416.1, C1417.2, C1418.2, C1420.2, C1422.2, C1423.2, C1425.2, C1426.2, C1428.2, C1429.2, C1430.2, C1432.2, C1433.2, C1435.2, C1437.2, C1438.2, R1404.2, R1409.1, R1411.2, R1415.2, R1417.2, R1419.2, R1428.1, U1401.2 (GND), U1402.4 (GND), U1403.3, U1404.4 (GND), U1404.10 (GAIN), U1405.5 (DGND), U1405.13 (AGND), U1407.3 (GND), U1408.2 (GND), U1409.3 (+), U1410.3 (+), U1411.3 (+); also elsewhere on the board
unnamed: C1410.1, R1411.1, U1405.1 (FSADJ)
unnamed: C1412.1, R1418.2, U1406.1, U1406.2 (-)
unnamed: C1412.2, R1410.1, R1412.2
unnamed: C1413.2, U1405.16 (COMP)
unnamed: C1414.1, R1413.1, U1406.5 (+)
unnamed: C1416.2, D1401.1 (K), D1401.5 (A), R1412.1, U1406.3 (+)
unnamed: C1417.1, U1405.3 (REFOUT)
unnamed: C1419.2, R1414.1, R1415.1, R1416.2, U1406.6 (-)
unnamed: C1420.1, C1421.2, L1401.1, R1417.1, U1405.14 (IOUT)
unnamed: C1421.1, C1422.1, C1424.2, L1401.2, L1402.1
unnamed: C1424.1, C1425.1, C1427.2, L1402.2, L1403.1
unnamed: C1427.1, C1428.1, C1431.2, L1403.2, R1419.1
unnamed: C1431.1, R1420.2
unnamed: C1434.1, R1421.1, R1423.2, U1409.6
unnamed: C1434.2, U1408.1 (IOUT), U1409.2 (-)
unnamed: C1436.1, R1424.1, R1426.2, U1410.6
unnamed: C1436.2, R1422.1, R1423.1, R1424.2, U1410.2 (-)
unnamed: D1401.2 (K), D1401.6 (A), R1410.2, U1404.3 (VOUTA)
unnamed: R1402.1, R1403.2, R1404.1, U1404.16 (RSTSEL)
unnamed: R1406.1, U1403.4, U1405.6 (MCLK)
unnamed: R1406.2, U1401.3 (OUT), U1403.1, U1403.2
unnamed: R1413.2, U1404.7 (VOUTB)
unnamed: R1420.1, R1422.2, U1408.7 (VREF)
unnamed: R1421.2, U1408.8 (RFB)
unnamed: R1425.1, R1426.1, R1427.2, U1411.2 (-)
unnamed: R1427.1, U1407.1, U1411.6
unnamed: R1428.2, U1407.2

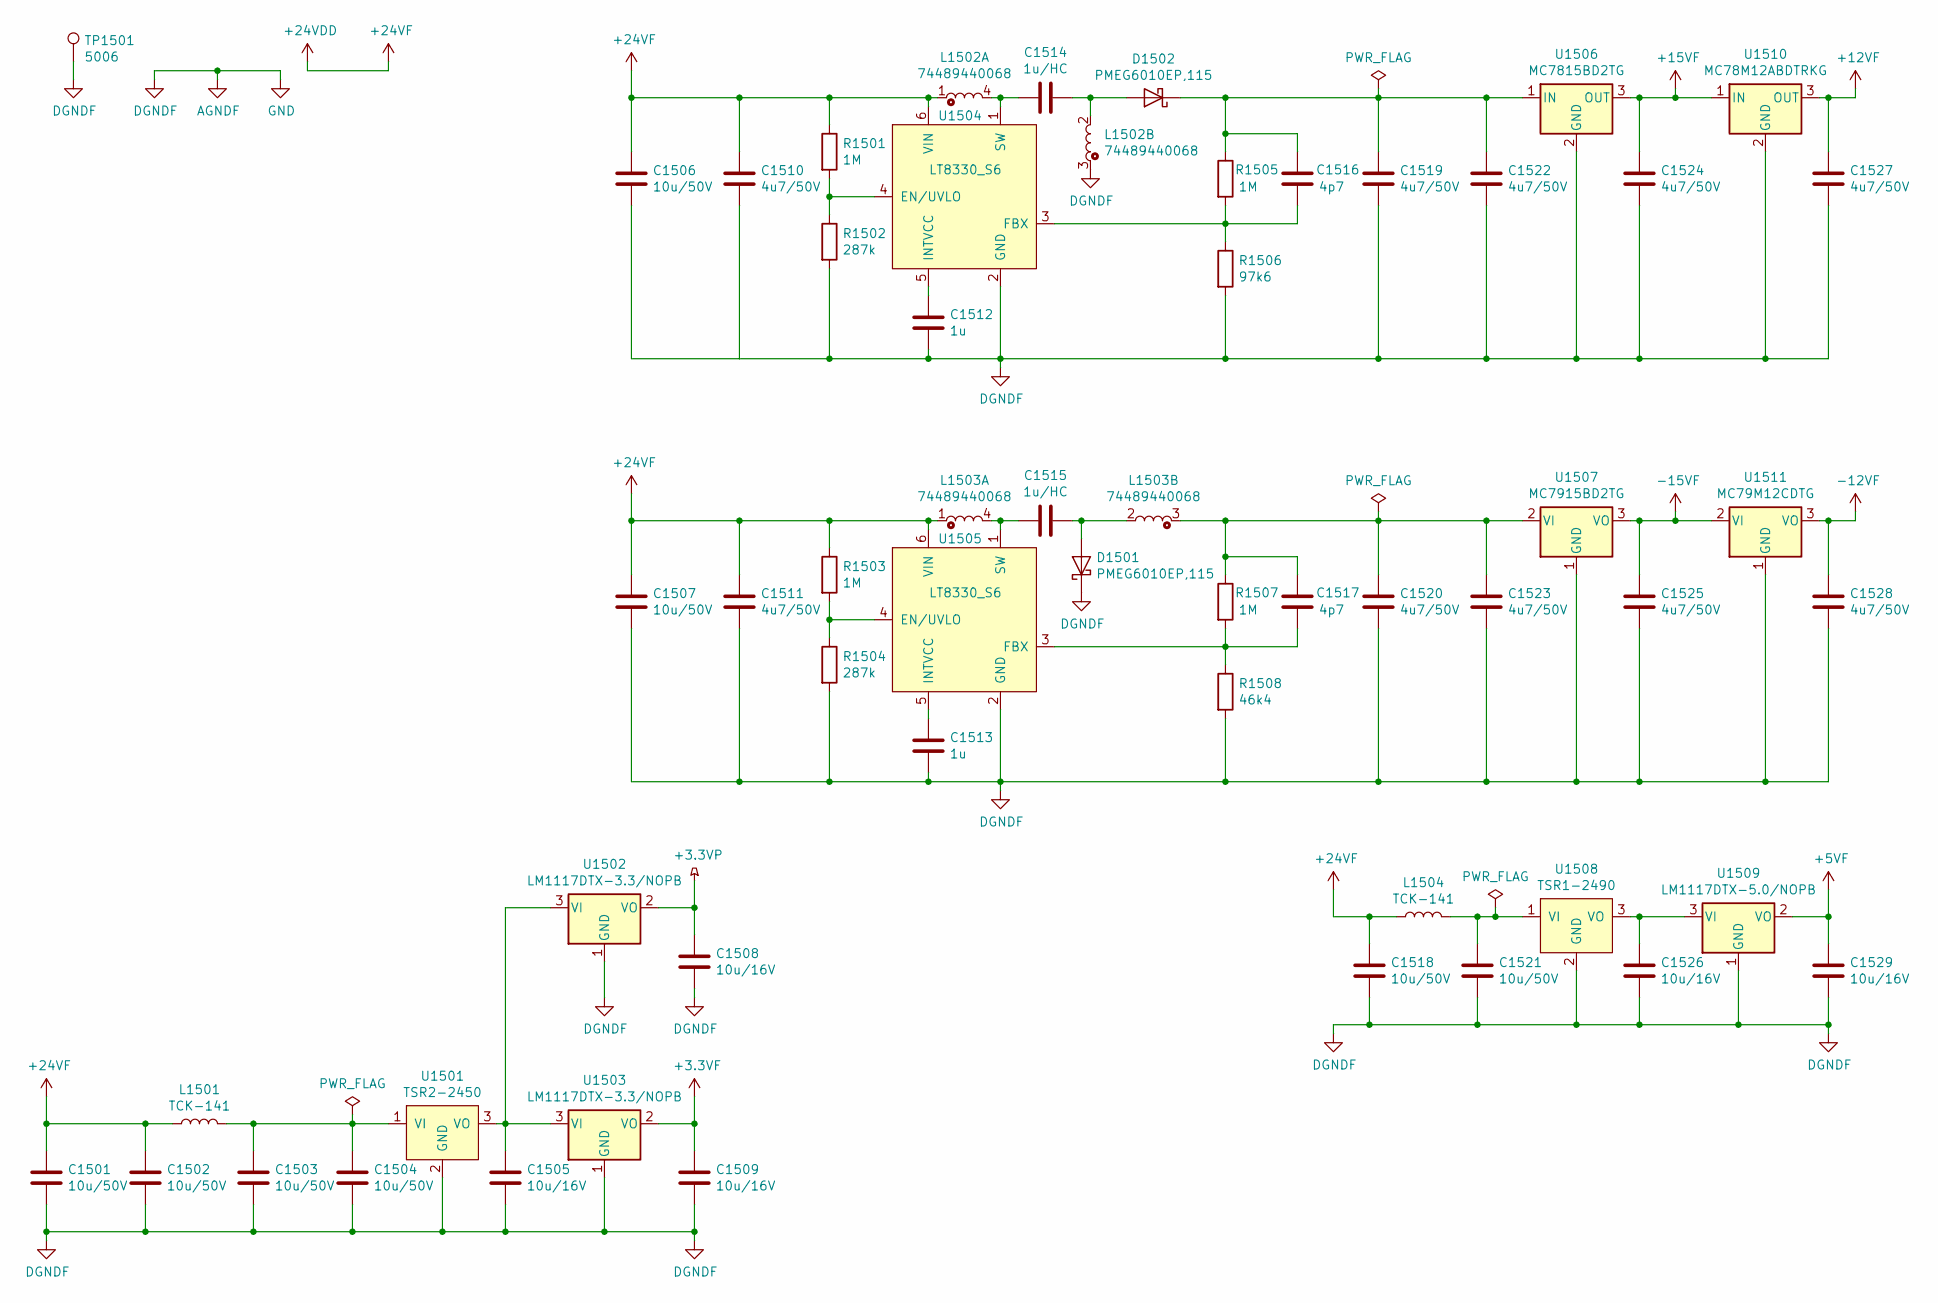
[picture p14: schematic Power_Two.sch, Power supply second]

Parts:
C1501, C1502, C1503, C1504, C1506, C1507, C1518, C1521: 10u/50V; C_1206_3216Metric_Pad1.42x1.75mm_HandSolder
C1505, C1508, C1509, C1526, C1529: 10u/16V; C_1206_3216Metric_Pad1.42x1.75mm_HandSolder
C1510, C1511, C1519, C1520, C1522, C1523, C1524, C1525, C1527, C1528: 4u7/50V; C_1206_3216Metric_Pad1.42x1.75mm_HandSolder
C1512, C1513: 1u; C_0603_1608Metric_Pad1.05x0.95mm_HandSolder
C1514, C1515: 1u/HC; C_1206_3216Metric_Pad1.42x1.75mm_HandSolder
C1516, C1517: 4p7; C_0603_1608Metric_Pad1.05x0.95mm_HandSolder
D1501, D1502: PMEG6010EP,115; D_SOD-128
L1501, L1504: TCK-141
L1502, L1503: 74489440068
R1501, R1503, R1505, R1507: 1M; R_0603_1608Metric_Pad1.05x0.95mm_HandSolder
R1502, R1504: 287k; R_0603_1608Metric_Pad1.05x0.95mm_HandSolder
R1506: 97k6; R_0603_1608Metric_Pad1.05x0.95mm_HandSolder
R1508: 46k4; R_0603_1608Metric_Pad1.05x0.95mm_HandSolder
TP1501: 5006; TestPoint_Loop_D2.60mm_Drill1.6mm_Beaded
U1501: TSR2-2450; TSR2
U1502, U1503: LM1117DTX-3.3/NOPB; TO-252-2
U1504, U1505: LT8330_S6; TSOT-23-6_HandSoldering
U1506: MC7815BD2TG; TO-263-2
U1507: MC7915BD2TG; TO-263-2
U1508: TSR1-2490; TSR1
U1509: LM1117DTX-5.0/NOPB; TO-252-2
U1510: MC78M12ABDTRKG; TO-252-2
U1511: MC79M12CDTG; TO-252-2

Connections:
+3.3VF: C1509.1, U1503.2 (VO); also elsewhere on the board
+3.3VP: C1508.1, U1502.2 (VO); also elsewhere on the board
+5VF: C1529.1, U1509.2 (VO); also elsewhere on the board
+12VF: C1527.1, U1510.3 (OUT); also elsewhere on the board
+15VF: C1524.1, U1506.3 (OUT), U1510.1 (IN); also elsewhere on the board
+24VDD: C1501.1, C1502.1, C1506.1, C1507.1, C1510.1, C1511.1, C1518.1, L1501.1, L1502.1, L1503.1, L1504.1, R1501.1, R1503.1, U1504.6 (VIN), U1505.6 (VIN); also elsewhere on the board
-12VF: C1528.1, U1511.3 (VO); also elsewhere on the board
-15VF: C1525.1, U1507.3 (VO), U1511.2 (VI); also elsewhere on the board
AGNDF: C1501.2, C1502.2, C1503.2, C1504.2, C1505.2, C1506.2, C1507.2, C1508.2, C1509.2, C1510.2, C1511.2, C1512.2, C1513.2, C1518.2, C1519.2, C1520.2, C1521.2, C1522.2, C1523.2, C1524.2, C1525.2, C1526.2, C1527.2, C1528.2, C1529.2, D1501.1 (K), L1502.3, R1502.2, R1504.2, R1506.2, R1508.2, TP1501.1, U1501.2 (GND), U1502.1 (GND), U1503.1 (GND), U1504.2 (GND), U1505.2 (GND), U1506.2 (GND), U1507.1 (GND), U1508.2 (GND), U1509.1 (GND), U1510.2 (GND), U1511.1 (GND); also elsewhere on the board
unnamed: C1503.1, C1504.1, L1501.2, U1501.1 (VI)
unnamed: C1505.1, U1501.3 (VO), U1502.3 (VI), U1503.3 (VI)
unnamed: C1512.1, U1504.5 (INTVCC)
unnamed: C1513.1, U1505.5 (INTVCC)
unnamed: C1514.1, D1502.2 (A), L1502.2
unnamed: C1514.2, L1502.4, U1504.1 (SW)
unnamed: C1515.1, D1501.2 (A), L1503.2
unnamed: C1515.2, L1503.4, U1505.1 (SW)
unnamed: C1516.1, C1519.1, C1522.1, D1502.1 (K), R1505.1, U1506.1 (IN)
unnamed: C1516.2, R1505.2, R1506.1, U1504.3 (FBX)
unnamed: C1517.1, C1520.1, C1523.1, L1503.3, R1507.1, U1507.2 (VI)
unnamed: C1517.2, R1507.2, R1508.1, U1505.3 (FBX)
unnamed: C1521.1, L1504.2, U1508.1 (VI)
unnamed: C1526.1, U1508.3 (VO), U1509.3 (VI)
unnamed: R1501.2, R1502.1, U1504.4 (EN/UVLO)
unnamed: R1503.2, R1504.1, U1505.4 (EN/UVLO)

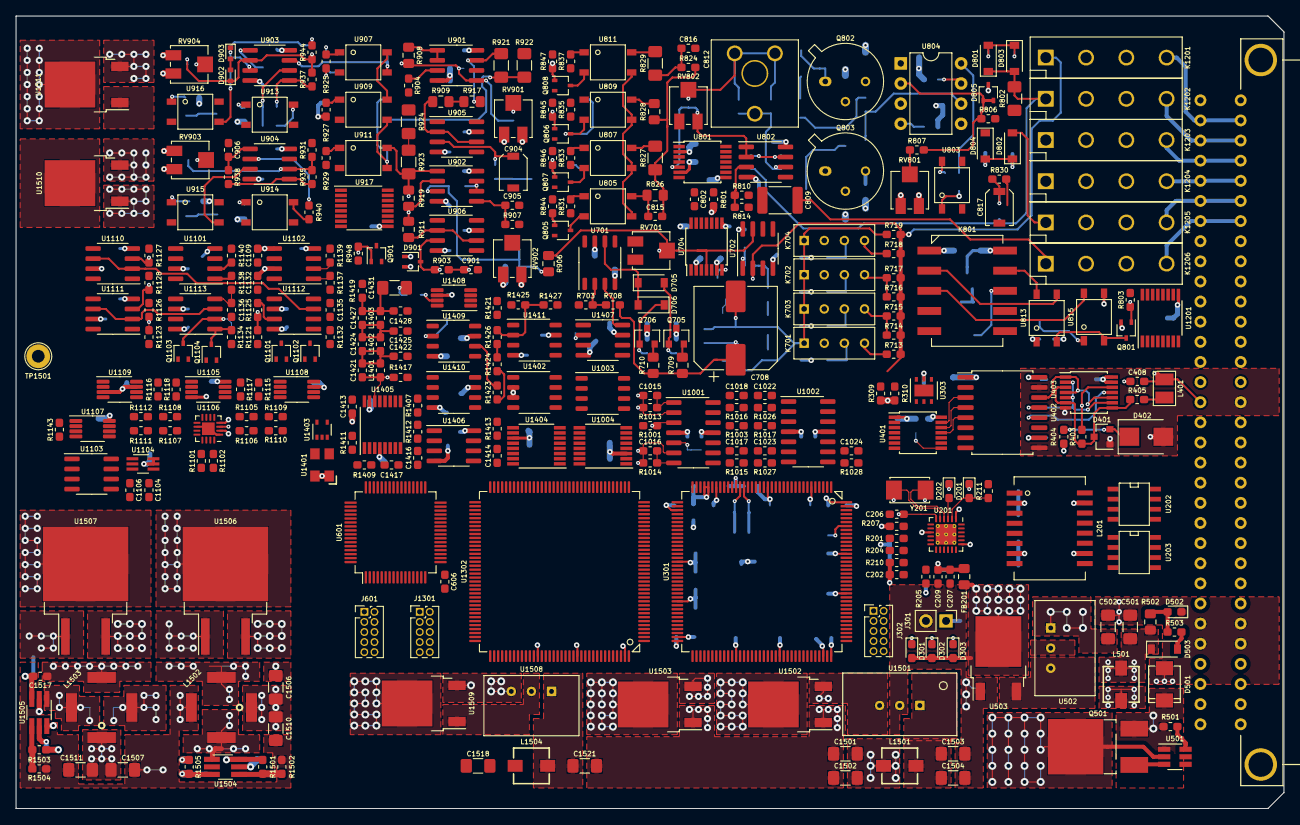
[picture p15: board ETH1CLCR1.kicad_pcb from above]

Board: 8 copper layers, 160.0 x 100.0 mm, 744 parts (0 on the bottom side), 493 nets.
