BehrensG/ETH1CLCR1/software/MCU2/Core/Src/main.c

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

/* Includes ------------------------------------------------------------------*/
#include "main.h"

/* USER CODE BEGIN Includes */
#include <stdio.h>
#include <stdlib.h>
#include <string.h>

#include "relay.h"
#include "ADC.h"
#include "scpi_def.h"
/* USER CODE END Includes */


I2C_HandleTypeDef hi2c4;

/* USER CODE BEGIN PV */
__IO uint8_t SPI6_TxBuffer[SPI6_BUFFOR_SIZE] = {[0 ... SPI6_BUFFOR_SIZE -1] = '\0'};
uint32_t SPI6_NbDataToTransmit = SPI6_BUFFOR_SIZE;
__IO uint16_t SPI6_TransmitIndex = 0;
uint32_t SPI6_TransmitSize = 0;

__IO uint8_t SPI6_RxBuffer[SPI6_BUFFOR_SIZE] = {[0 ... SPI6_BUFFOR_SIZE -1] = '\0'};
__IO uint16_t SPI6_ReceiveIndex = 0;

__IO uint8_t SPI6_XfrCompleteDetect = 0;

__IO uint8_t SPI6_XfrErrorDetect = 0;

/* USER CODE END PV */

void SystemClock_Config(void);
static void MX_GPIO_Init(void);
static void MX_I2C4_Init(void);
static void MX_SPI1_Init(void);
static void MX_SPI2_Init(void);
static void MX_SPI3_Init(void);
static void MX_SPI4_Init(void);
static void MX_SPI5_Init(void);
static void MX_SPI6_Init(void);
/* USER CODE BEGIN 0 */

static void SPI6_ClearTXBuffer()
{
	for(int32_t x = 0; x < SPI6_BUFFOR_SIZE/2; x++)
	{
		SPI6_TxBuffer[x] = '\0';
	}

}


static SPI6_Status SPI6_CheckMode()
{
		if(LL_GPIO_IsInputPinSet(MCU1_RX_DATA_GPIO_Port, MCU1_RX_DATA_Pin))
		{
			return SPI6_MODE_TX;
		}
		else if(LL_GPIO_IsInputPinSet(MCU1_TX_DATA_GPIO_Port, MCU1_TX_DATA_Pin) && (SPI6_ReceiveIndex > 0))
		{
			return SPI6_MODE_RX;
		}

		return SPI6_MODE_NONE;
}

static void SPI6_DataHandler()
{

}

/* USER CODE END 0 */

/**
  * @brief  The application entry point.
  * @retval int
  */
int main(void)
{
  /* USER CODE BEGIN 1 */
	volatile uint8_t rx_data;
	uint8_t timeout = 0;
	uint32_t start_time = 0, current_time = 0;
  /* USER CODE END 1 */

  /* MCU Configuration--------------------------------------------------------*/

  /* Reset of all peripherals, Initializes the Flash interface and the Systick. */
  HAL_Init();

  /* Configure the system clock */
  SystemClock_Config();

  /* Initialize all configured peripherals */
  MX_GPIO_Init();
  MX_I2C4_Init();
  MX_SPI1_Init();
  MX_SPI2_Init();
  MX_SPI3_Init();
  MX_SPI4_Init();
  MX_SPI5_Init();
  MX_SPI6_Init();
  /* USER CODE BEGIN 2 */
  RELAY_Init();

  LL_SPI_Enable(SPI3);
  LL_SPI_StartMasterTransfer(SPI3);
  LL_SPI_Enable(SPI4);
  LL_SPI_StartMasterTransfer(SPI4);
  LL_SPI_Enable(SPI5);
  LL_SPI_StartMasterTransfer(SPI5);

  SCPI_Init(&scpi_context,
          scpi_commands,
          &scpi_interface,
          scpi_units_def,
          SCPI_IDN1, SCPI_IDN2, SCPI_IDN3, SCPI_IDN4,
          scpi_input_buffer, SCPI_INPUT_BUFFER_LENGTH,
          scpi_error_queue_data, SCPI_ERROR_QUEUE_SIZE);

  ADC_AD7380_Init();
  ADC_PGA103_Gain(AINA, 1);
  ADC_PGA103_Gain(AINB, 1);
  /* USER CODE END 2 */

  /* Infinite loop */
  /* USER CODE BEGIN WHILE */
  LL_GPIO_ResetOutputPin(MCU2_STATUS_GPIO_Port, MCU2_STATUS_Pin);
  LL_GPIO_SetOutputPin(MCU2_RX_STATUS_GPIO_Port, MCU2_RX_STATUS_Pin);

  while (1)
  {


    /* USER CODE END WHILE */
	  HAL_Delay(5);
    /* USER CODE BEGIN 3 */
	  if(SPI6_MODE_RX == SPI6_CheckMode())
	  {
		  LL_GPIO_ResetOutputPin(MCU2_RX_STATUS_GPIO_Port, MCU2_RX_STATUS_Pin);
		  //SPI6_ClearTXBuffer();
		  SCPI_Input(&scpi_context, SPI6_RxBuffer, SPI6_ReceiveIndex);
		  SPI6_TransmitIndex = 0;
		  SPI6_ReceiveIndex = 0;
		  LL_GPIO_SetOutputPin(MCU2_RX_STATUS_GPIO_Port, MCU2_RX_STATUS_Pin);
	  }
	  else if(SPI6_MODE_TX == SPI6_CheckMode())
	  {
		  SPI6_TransmitIndex = 0;
		  SPI6_ReceiveIndex = 0;
		  SPI6_TransmitSize = 0;
		  LL_GPIO_SetOutputPin(MCU2_RX_STATUS_GPIO_Port, MCU2_RX_STATUS_Pin);
	  }
  }
  /* USER CODE END 3 */
}

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
