BehrensG/ETH1CLCR1/software/MCU3/Core/Src/main.c

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

/* Includes ------------------------------------------------------------------*/
#include "main.h"

/* USER CODE BEGIN Includes */
#include "DG419.h"
#include "AD9835.h"
#include "AD5453.h"
#include "scpi_def.h"
/* USER CODE END Includes */

I2C_HandleTypeDef hi2c1;

SPI_HandleTypeDef hspi1;
SPI_HandleTypeDef hspi2;
SPI_HandleTypeDef hspi3;
SPI_HandleTypeDef hspi5;

/* USER CODE BEGIN PV */

/* Buffer used for reception */
uint8_t SPI3_RxBuffer[SPI3_BUFFERSIZE] = {[0 ... SPI3_BUFFERSIZE - 1] = '\0'};
__IO uint32_t SPI3_ReceiveIndex  = 0;

/* USER CODE END PV */

void SystemClock_Config(void);
static void MX_GPIO_Init(void);
static void MX_I2C1_Init(void);
static void MX_SPI1_Init(void);
static void MX_SPI2_Init(void);
static void MX_SPI3_Init(void);
static void MX_SPI5_Init(void);
/**
  * @brief  The application entry point.
  * @retval int
  */
int main(void)
{
  /* USER CODE BEGIN 1 */
	HAL_StatusTypeDef error;
  /* USER CODE END 1 */

  /* MCU Configuration--------------------------------------------------------*/

  /* Reset of all peripherals, Initializes the Flash interface and the Systick. */
  HAL_Init();

  /* Configure the system clock */
  SystemClock_Config();

  /* Initialize all configured peripherals */
  MX_GPIO_Init();
  MX_I2C1_Init();
  MX_SPI1_Init();
  MX_SPI2_Init();
  MX_SPI3_Init();
  MX_SPI5_Init();
  /* USER CODE BEGIN 2 */

  AD9835_Init();
  AD5689_Init();

  SCPI_Init(&scpi_context,
          scpi_commands,
          &scpi_interface,
          scpi_units_def,
          SCPI_IDN1, SCPI_IDN2, SCPI_IDN3, SCPI_IDN4,
          scpi_input_buffer, SCPI_INPUT_BUFFER_LENGTH,
          scpi_error_queue_data, SCPI_ERROR_QUEUE_SIZE);

  /* USER CODE END 2 */
	AD9835_FrequencyRegister(AD9835_FREQ0, 1000);
	AD9835_FrequencyRegisterSelect(AD9835_FREQ0);
	AD9835_Output(AD9835_ON);
	AD5453_SetVoltage(0.125);
	DG419_Switch(1);
  /* Infinite loop */
  /* USER CODE BEGIN WHILE */
  while (1)
  {
    /* USER CODE END WHILE */

    /* USER CODE BEGIN 3 */

	  if(HAL_OK == HAL_SPI_Receive_IT(&hspi3, &SPI3_RxBuffer, SPI3_BUFFERSIZE-1))
	  {
		  if(SPI3_ReceiveIndex == (SPI3_BUFFERSIZE-1))
	    	{
	    		SCPI_Input(&scpi_context, SPI3_RxBuffer, SPI3_ReceiveIndex);
	    		SPI3_ReceiveIndex = 0;
	    	}
	  }
  }
  /* USER CODE END 3 */
}

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
