BehrensG/ETH1CLCR1/software/MCU1/Core/Src/main.c

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

/* Includes ------------------------------------------------------------------*/
#include "main.h"
#include "cmsis_os.h"
#include "lwip.h"

/* USER CODE BEGIN Includes */
#include "board.h"
#include "scpi_trigger.h"
#include "spi4.h"
/* USER CODE END Includes */


I2C_HandleTypeDef hi2c2;
I2C_HandleTypeDef hi2c4;

SPI_HandleTypeDef hspi4;

/* Definitions for defaultTask */
osThreadId_t defaultTaskHandle;
const osThreadAttr_t defaultTask_attributes = {
  .name = "defaultTask",
  .priority = (osPriority_t) osPriorityNormal,
  .stack_size = 128 * 4
};
/* Definitions for LEDTask */
osThreadId_t LEDTaskHandle;
const osThreadAttr_t LEDTask_attributes = {
  .name = "LEDTask",
  .priority = (osPriority_t) osPriorityLow,
  .stack_size = 128 * 4
};
/* Definitions for TriggerTask */
osThreadId_t TriggerTaskHandle;
const osThreadAttr_t TriggerTask_attributes = {
  .name = "TriggerTask",
  .priority = (osPriority_t) osPriorityNormal,
  .stack_size = 128 * 4
};
void SystemClock_Config(void);
static void MX_GPIO_Init(void);
static void MX_I2C2_Init(void);
static void MX_I2C4_Init(void);
static void MX_SPI4_Init(void);
void StartDefaultTask(void *argument);
void StartLEDTask(void *argument);
void StartTriggerTask(void *argument);

/**
  * @brief  The application entry point.
  * @retval int
  */
int main(void)
{
  /* Enable I-Cache---------------------------------------------------------*/
  SCB_EnableICache();

  /* Enable D-Cache---------------------------------------------------------*/
  SCB_EnableDCache();

  /* MCU Configuration--------------------------------------------------------*/

  /* Reset of all peripherals, Initializes the Flash interface and the Systick. */
  HAL_Init();

  /* Configure the system clock */
  SystemClock_Config();

  /* Initialize all configured peripherals */
  MX_GPIO_Init();
  MX_I2C2_Init();
  MX_I2C4_Init();
  MX_SPI4_Init();
  /* USER CODE BEGIN 2 */
  MX_LWIP_Init();

  BOARD_DetectDefaultConfig();
  BOARD_CreateDefaultData();
  /* USER CODE END 2 */

  /* Init scheduler */
  osKernelInitialize();

  /* USER CODE BEGIN RTOS_MUTEX */
  /* add mutexes, ... */
  /* USER CODE END RTOS_MUTEX */

  /* USER CODE BEGIN RTOS_SEMAPHORES */
  /* add semaphores, ... */
  /* USER CODE END RTOS_SEMAPHORES */

  /* USER CODE BEGIN RTOS_TIMERS */
  /* start timers, add new ones, ... */
  /* USER CODE END RTOS_TIMERS */

  /* USER CODE BEGIN RTOS_QUEUES */
  /* add queues, ... */
  /* USER CODE END RTOS_QUEUES */

  /* Create the thread(s) */
  /* creation of defaultTask */
 // defaultTaskHandle = osThreadNew(StartDefaultTask, NULL, &defaultTask_attributes);

  /* creation of LEDTask */
 // LEDTaskHandle = osThreadNew(StartLEDTask, NULL, &LEDTask_attributes);

  /* creation of TriggerTask */
 // TriggerTaskHandle = osThreadNew(StartTriggerTask, NULL, &TriggerTask_attributes);

  /* USER CODE BEGIN RTOS_THREADS */
  scpi_server_init();
  /* USER CODE END RTOS_THREADS */

  /* Start scheduler */
  osKernelStart();
 
  /* We should never get here as control is now taken by the scheduler */
  /* Infinite loop */
  /* USER CODE BEGIN WHILE */
  while (1)
  {
    /* USER CODE END WHILE */

    /* USER CODE BEGIN 3 */

  }
  /* USER CODE END 3 */
}

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
/* USER CODE BEGIN 4 */
void  BlinkTask(void* argument)
{
	for(;;)
	{
		HAL_GPIO_TogglePin(LED_GREEN_GPIO_Port, LED_GREEN_Pin);
		osDelay(pdMS_TO_TICKS(500));
	}
}
/* USER CODE END 4 */

/* USER CODE BEGIN Header_StartDefaultTask */
/**
  * @brief  Function implementing the defaultTask thread.
  * @param  argument: Not used 
  * @retval None
  */
/* USER CODE END Header_StartDefaultTask */
void StartDefaultTask(void *argument)
{
  /* init code for LWIP */
  MX_LWIP_Init();
  /* USER CODE BEGIN 5 */

  /* Infinite loop */
  for(;;)
  {
	   // osThreadTerminate(NULL);
  }
  /* USER CODE END 5 */ 
}

/* USER CODE BEGIN Header_StartLEDTask */
/**
* @brief Function implementing the LEDTask thread.
* @param argument: Not used
* @retval None
*/
/* USER CODE END Header_StartLEDTask */
void StartLEDTask(void *argument)
{
  /* USER CODE BEGIN StartLEDTask */
  /* Infinite loop */
  for(;;)
  {
    osDelay(1);
  }
  /* USER CODE END StartLEDTask */
}

/* USER CODE BEGIN Header_StartTriggerTask */
/**
* @brief Function implementing the TriggerTask thread.
* @param argument: Not used
* @retval None
*/
/* USER CODE END Header_StartTriggerTask */
void StartTriggerTask(void *argument)
{
  /* USER CODE BEGIN StartTriggerTask */
  /* Infinite loop */

  int8_t tx_data[SPI4_BUFFER] = {[0 ... SPI4_BUFFER - 1] = '\0'};

  for(;;)
  {
	  if(TRIG_EXT == board.structure.trigger.source)
	  {
		  if(HAL_GPIO_ReadPin(TRIG_IN_GPIO_Port, TRIG_IN_Pin))
		  {
			  osDelay(board.structure.trigger.delay*1000);
			  snprintf(tx_data, SPI4_BUFFER, "IMM\r\n");
			  SPI4_Transmit(&tx_data,1000);
		  }
	  }
	  osDelay(pdMS_TO_TICKS(10));
  }
  /* USER CODE END StartTriggerTask */
}

 /**
  * @brief  Period elapsed callback in non blocking mode
  * @note   This function is called  when TIM1 interrupt took place, inside
  * HAL_TIM_IRQHandler(). It makes a direct call to HAL_IncTick() to increment
  * a global variable "uwTick" used as application time base.
  * @param  htim : TIM handle
  * @retval None
  */
void HAL_TIM_PeriodElapsedCallback(TIM_HandleTypeDef *htim)
{
  if (htim->Instance == TIM1) {
    HAL_IncTick();
  }
}

/**
  * @brief  This function is executed in case of error occurrence.
  * @retval None
  */
void Error_Handler(void)
{
  /* USER CODE BEGIN Error_Handler_Debug */
  /* User can add his own implementation to report the HAL error return state */

  /* USER CODE END Error_Handler_Debug */
}

#ifdef  USE_FULL_ASSERT
/**
  * @brief  Reports the name of the source file and the source line number
  *         where the assert_param error has occurred.
  * @param  file: pointer to the source file name
  * @param  line: assert_param error line source number
  * @retval None
  */
void assert_failed(uint8_t *file, uint32_t line)
{ 
  /* USER CODE BEGIN 6 */
  /* User can add his own implementation to report the file name and line number,
     tex: printf("Wrong parameters value: file %s on line %d\r\n", file, line) */
  /* USER CODE END 6 */
}
#endif /* USE_FULL_ASSERT */

/************************ (C) COPYRIGHT STMicroelectronics *****END OF FILE****/
