BehrensG/ETH1CLCR1/software/MCU1/Core/Inc/spi4.h

/*
 * spi4.h
 *
 *  Created on: May 20, 2020
 *      Author: grzegorz
 */

#ifndef INC_SPI4_H_
#define INC_SPI4_H_

#include "board.h"

#define MCU2_IDLE	0U
#define MCU2_BUSY	1U

#define SPI4_BUFFER 64

BRD_StatusTypeDef SPI4_Transmit(const int8_t* str, uint32_t timeout);
//BRD_StatusTypeDef SPI4_Receive(int8_t* str, uint32_t timeout);
BRD_StatusTypeDef SPI4_Receive(int8_t* str, int32_t* readout_size, uint32_t timeout);

#endif /* INC_SPI4_H_ */
