BehrensG/ETH1CLCR1/software/MCU1/Core/Src/scpi_measure.c

/*
 * scpi_commands_measure.c
 *
 *  Created on: Mar 14, 2020
 *      Author: grzegorz
 */



#include <stdio.h>
#include <stdlib.h>
#include <string.h>

#include "scpi_def.h"
#include "scpi_measure.h"
#include "spi4.h"
/*
 * FETCh?
 *
 * @INFO:
 * Retrieves the measurements taken by the INITiate subsystem commands and places them into the device output buffer.
 * Query response is: <stat>,<data1>,<data2>,<comp1>,<comp2>
 *
 * @RESULTS:
 *
 *			<stat> :	measurement status: 0 (Normal), 1 (Overload), 2 (No-Contact)
 *			<data1> :	measurement data of the primary parameter
 *			<data2> :	measurement data of the secondary parameter
 *			<comp1> : 	comparison result of the primary parameter (no output when comparator is OFF) : 1 (In), 2 (High), 3 (Low), 8 (No-Contact)
 *			<comp2> : 	comparison result of the primary parameter (no output when comparator is OFF) : 1 (In), 2 (High), 3 (Low), 8 (No-Contact)
 *
 * @NOTE:
 * Data format is specifed by FORMat subsystem.
 *
 */

scpi_result_t SCPI_FetchQ(scpi_t * context)
{
	int8_t tx_data[SPI4_BUFFER] ={[0 ... SPI4_BUFFER-1] = '\0'};
	int8_t rx_data[SPI4_BUFFER] ={[0 ... SPI4_BUFFER-1] = '\0'};
	int32_t readout_size = 0;

	snprintf(tx_data, SPI4_BUFFER, "FETCh?");
	SPI4_Transmit(&tx_data,1000);
	HAL_Delay(2);
	SPI4_Receive(&rx_data, &readout_size, 1000);
	SCPI_ResultCharacters(context, rx_data, readout_size);

	return SCPI_RES_OK;
}

/*
 * INITiate[:IMMediate]
 *
 * @INFO:
 * This command causes the trigger system to initiate and complete one full trigger cycle, returning to Idle state on completion.
 *
 * @NOTE:
 * Data format is specifed by FORMat subsystem.
 *
 */

scpi_result_t SCPI_InitiateImmediate(scpi_t * context)
{
	int8_t tx_data[SPI4_BUFFER] ={[0 ... SPI4_BUFFER-1] = '\0'};

	snprintf(tx_data, SPI4_BUFFER, "INIT");
	SPI4_Transmit(&tx_data,1000);

	return SCPI_RES_OK;
}

/*
 * INITiate:CONTinuous {ON|OFF|1|0}
 *
 * @INFO:
 * Enable or disable whether the trigger system is continuously initiated or not.
 *
 * @PARAMETERS:
 * 				OFF or 0 :		does not initiate the trigger system continuously
 * 				ON or 1	:		initiates the trigger system continuously
 *
 * @NOTE:
 * In the current PCB desgin no DC bias voltage output is not possible.
 *
 */

scpi_result_t SCPI_InitiateContinuous(scpi_t * context)
{

	return SCPI_RES_OK;
}

/*
 * INITiate:CONTinuous?
 *
 * @INFO:
 * Queries whether the trigger system is continuously initiated or not. Result can be 0 or 1.
 *
 */

scpi_result_t SCPI_InitiateContinuousQ(scpi_t * context)
{
	int8_t tx_data[SPI4_BUFFER] ={[0 ... SPI4_BUFFER-1] = '\0'};
	int8_t rx_data[SPI4_BUFFER] ={[0 ... SPI4_BUFFER-1] = '\0'};
	int32_t readout_size = 0;

	snprintf(tx_data, SPI4_BUFFER, "INIT:CONT?");
	SPI4_Transmit(&tx_data,1000);
	HAL_Delay(2);
	SPI4_Receive(&rx_data, &readout_size, 1000);
	SCPI_ResultCharacters(context, rx_data, readout_size);
	return SCPI_RES_OK;
}
