BehrensG/ETH1CLCR1/software/MCU2/Core/Src/DAC8568.c

/*
 * DAC8568.c
 *
 *  Created on: Apr 19, 2020
 *      Author: grzegorz
 */

#include "main.h"
#include "board.h"
#include "DAC8568.h"

static uint16_t DAC8568_ConvertVoltageToData16(double voltage)
{
	uint16_t data = 0x0000;
	double volt_tmp = 0.0;

	volt_tmp = voltage/(double)DAC_OPAMP_GAIN;
	volt_tmp += DAC_REF_HALF;

	data = (volt_tmp*DAC_16BIT)/(DAC_REF*DAC_GAIN);

	return data;
}

BRD_StatusTypeDef DAC8568_SetVoltage(uint32_t param, double voltage)
{
	uint16_t volt_data = 0x0000;
	dac_data_t tx_data;

	volt_data = DAC8568_ConvertVoltageToData16(voltage);
	tx_data.word32 = param | (volt_data << 4);

	LL_GPIO_ResetOutputPin(DAC_nSYNC_GPIO_Port, DAC_nSYNC_Pin);


	    while (!LL_SPI_IsActiveFlag_TXC(SPI5)){};

		LL_SPI_TransmitData32(SPI5, tx_data.word32);

		LL_GPIO_SetOutputPin(DAC_nSYNC_GPIO_Port, DAC_nSYNC_Pin);

	return BRD_OK;
}

BRD_StatusTypeDef DAC8568_ResetAll()
{
	dac_data_t tx_data;

	return BRD_OK;
}
