BehrensG/ETH1CLCR1/software/MCU3/Core/Inc/AD5689.h

/*
 * AD5689.h
 *
 *  Created on: Apr 9, 2020
 *      Author: grzegorz
 */

#ifndef INC_AD5689_H_
#define INC_AD5689_H_

#include "main.h"

#define AD5689_CMD_WRITE_TO_INPUT_REG			0x00100000U	//dependent on LDAC input
#define AD5689_CMD_UPDATE_DAC_WITH_INPUT_REG	0x00200000U
#define AD5689_CMD_WRITE_AND_UPDATE_DAC			0x00300000U
#define AD5689_CMD_POWER_UP_DOWN_DAC			0x00400000U
#define AD5689_CMD_HARDWARE_LDAC_MASK			0x00500000U
#define AD5689_CMD_SOFWARE_RESET				0x00600000U
#define AD5689_CMD_DAISY_CHAIN_ENABLE			0x00800000U
#define AD5689_CMD_READBACK_ENABLE				0x00900000U
#define AD5689_ADDR_DAC_A						0x00010000U
#define AD5689_ADDR_DAC_B						0x00080000U
#define AD5689_ADDR_DAC_AB						0x00090000U
#define AD5689_VOUTA							0U
#define AD5689_VOUTB							1U
#define AD5689_VOUTB_GAIN						8U
#define AD5689_VOUTB_OFFSET						10U
#define AD5689_INTERNAL 						0U
#define AD5689_EXTERNAL 						1U
#define AD5689_EXT_REF							2.5

BRD_StatusTypeDef AD5698_SetVOUTB(double voltage);
BRD_StatusTypeDef AD5689_SoftReset();
void AD5689_HardReset(void);

#endif /* INC_AD5689_H_ */
