BehrensG/ETH1CLCR1/software/MCU1/Core/Src/scpi_calibration.c

/*
 * scpi_commands_calibration.c
 *
 *  Created on: Mar 14, 2020
 *      Author: grzegorz
 */

#include "scpi_calibration.h"

scpi_result_t SCPI_CalibrationADCQ(scpi_t * context)
{

    return SCPI_RES_OK;
}

scpi_result_t SCPI_CalibrationAllQ(scpi_t * context)
{

    return SCPI_RES_OK;
}

scpi_result_t SCPI_CalibrationSecureState(scpi_t * context)
{

    return SCPI_RES_OK;
}

scpi_result_t SCPI_CalibrationSecureStateQ(scpi_t * context)
{

    return SCPI_RES_OK;
}

scpi_result_t SCPI_CalibrationStore(scpi_t * context)
{

    return SCPI_RES_OK;
}

scpi_result_t SCPI_CalibrationString(scpi_t * context)
{

    return SCPI_RES_OK;
}

scpi_result_t SCPI_CalibrationStringQ(scpi_t * context)
{

    return SCPI_RES_OK;
}

scpi_result_t SCPI_CalibrationValue(scpi_t * context)
{

    return SCPI_RES_OK;
}

scpi_result_t SCPI_CalibrationValueQ(scpi_t * context)
{

    return SCPI_RES_OK;
}
