BehrensG/ETH1CLCR1/(commit log)

2019-12-05 Schematic design
    [Connector.sch, ETH1CLCR1.kicad_pcb, ETH1CLCR1.sch, Ethernet.sch, FGEN.sch, FGEN_Buffer.sch, Isolation.sch, MCU1.sch]
2020-01-06 Need to redesign the AC source, the LT1468 is too slow.
    [Connector.sch, ETH1CLCR1.sch, FGEN.sch, FGEN_Buffer.sch, MCU2.sch, ProcessAmplifier.sch, RangeResistor.sch]
2020-01-07 Footprint asigment (not finished).
    [ADC.sch, Connector.sch, DAC.sch, ETH1CLCR1.sch, Ethernet.sch, FGEN.sch, FGEN_Buffer.sch, Isolation.sch]
2020-01-11 Modification in schematic and PCB layout.
    [Connector.sch, ETH1CLCR1.kicad_pcb, ETH1CLCR1.sch, Ethernet.sch, FGEN.sch, FGEN_Buffer.sch, Isolation.sch, MCU1.sch]
2020-01-12 PCB layout
    [ETH1CLCR1.kicad_pcb, FGEN_Buffer.sch, Power_Float.sch, RangeResistor.sch]
2020-01-15 Redesinged ADC schematic.
    [ADC.sch, Connector.sch, DAC.sch, ETH1CLCR1.kicad_pcb, Ethernet.sch, FGEN.sch, FGEN_Buffer.sch, Isolation.sch]
2020-01-16 Redesigned the power supply, added humidy+temp. sensor.
    [ADC.sch, Connector.sch, DAC.sch, ETH1CLCR1.kicad_pcb, ETH1CLCR1.sch, Ethernet.sch, FGEN.sch, FGEN_Buffer.sch]
2020-01-18 Fixed mistake in ADC schematic.
    [ADC.sch, ETH1CLCR1.kicad_pcb]
2020-01-19 Changes in schematics.
    [ADC.sch, DAC.sch, ETH1CLCR1.kicad_pcb, ETH1CLCR1.sch, Ethernet.sch, FGEN_Buffer.sch, Power_One.sch, Power_Two.sch]
2020-01-19 Checked the schematics. Created BOM.
    [ADC.sch, Connector.sch, ETH1CLCR1.csv, ETH1CLCR1.kicad_pcb, ETH1CLCR1.ods, ETH1CLCR1.sch, FGEN.sch, FGEN_Buffer.sch]
2020-01-21 Fixed some mistakes in the foorpeints. BOM list ready.
    [ETH1CLCR1.kicad_pcb, ETH1CLCR1.ods, ETH1CLCR1.sch, FGEN_Buffer.sch, MCU2.sch, MCU3.sch, Power_Two.sch, ProcessAmplifier.sch]
2020-01-28 Changed op-amps in ADC schematic.
    [ADC.sch, ETH1CLCR1.kicad_pcb]
2020-01-30 PCB layout.
2020-02-02 PCB done.
    [ADC.sch, FGEN.sch, FGEN_Buffer.sch, MCU3.sch, RangeResistor.sch, Trigger.sch]
2020-02-03 Small modification to silk screen
    [Power2.sch, Power_Base.sch, Power_Float.sch, Power_Second.sch]
2020-02-05 Range BC847 base serial resistors value from 10k to 1k.
    [ADC.sch, FGEN_Buffer.sch, ProcessAmplifier.sch, RangeResistor.sch]
2020-02-06 Small modifications
    [Isolation.sch, PGA.sch]
2020-02-08 Fixed bug in STM32 symbols
    [MCU1.sch, MCU2.sch]
2020-02-09 BOM list update
    [ADC.sch, ETH1CLCR1.csv, ETH1CLCR1.ods]
2020-02-17 Changed BC847W base resistor from 1k to 10k.
    [ADC.sch, FGEN_Buffer.sch, ProcessAmplifier.sch, RangeResistor.sch]
2020-02-28 Small changes in schematics and PCB
    [ADC.sch, FGEN_Buffer.sch, RangeResistor.sch]
2020-03-21 Software development of MCU1. Fixed problem with snprintf in FreeRTOS using solution from http://www.nadler.com/embedded/newlibAndFreeRTOS.html
    [board.c, board.h, eeprom.c, eeprom.h, main.c, scpi-def.c]
2020-04-13 Bug fixes in FGEN schematic. Software for AD9835 and AD5689 works.
    [FGEN.sch]
2020-04-13 Fixed problem with LT1468 stablity (changed 1p5 to 27p C). AD5453 software works. Changed U1410 gain from 10 to 5.
    [FGEN.sch]
2020-04-16 Software development.
    [FGEN.sch]
2020-04-26 Was able to set the SPI3 (MCU2) to run with 80 MHZ clock speed with AD7380. Using HAL lib for SPI and GPIO, too slow switching. Need to change to LL with DMA.
    [ETH1CLCR1.sch, FGEN_Buffer.sch, MCU2.sch, RangeResistor.sch]
2020-04-27 Low level GPIO and SPI. ADC register readout works.
2020-05-05 First test with SPI communication MCU1(Master) <-> MCU2(Slave) successful.
2020-05-11 Fixed problems with MCU1 and MCU2 IRQ communication (buffer problems and IRQ handler).
    [main.c, main.h, scpi_def.c, scpi_def.h, scpi_server.c]
2020-05-17 SCPI function development.
    [MCU1.sch]
2020-05-22 MCU1 SCPI functions development.
    [MCU1.sch]
2020-06-13 Fixed Ethernet connection stability problems. Problem was the too small stack size for Ethernet thread in FreeRTOS.
    [DAC8568.c, DAC8568.h, eeprom.h, main.c, scpi_calculate.c, scpi_def.c, scpi_measure.c, scpi_misc.c]
2020-06-14 Fixed problem with the SPI communication between MCU1 and MCU2. Fixed the data format output in MCU1.
    [main.c, scpi_calculate.c, scpi_def.c, scpi_measure.c, scpi_misc.c, scpi_sense.c, scpi_source.c, spi4.c]
2020-06-14 Problem with MCU1 only write commands to MCU2.
    [ADC.c, main.c, main.h, scpi_source.c, spi4.c]
2020-06-14 Fixed the MCU1 only TX commands to MCU2 (not the best solution). Changed the MCU2 output string.
    [scpi_source.c, spi4.c]
2020-06-15 MCU3 and MCU2 SPI communication works.
2020-06-28 Fixed communication stability between MCU1 and MCU2. Fixed communication to ADC. DAC communication doesn't works. Voltages on LT6350 and PGA103 are not what expected (according to LTSpice).
    [ADC.c, ADC.h, main.c, scpi_calculate.c, scpi_def.c, scpi_misc.c, scpi_sense.c, scpi_source.c]
2020-07-23 Software development
    [ADC.sch]
